adnanberberovic/TSEA56Grupp2/DOKUMENT/DesignSpec/Produktblad/Reflex-Sensor.pdf

Reexsensor
11 oktober 2007
Denna sensor innehåller 1 st så kallad reexdetektor. Den består av en lysdiod med infrarött ljus o

h en ljuskänslig transistor. Lysdioden är alltid tänd så länge som sensorn är spänningssatt. Om underlaget reekterar my

ket ljus blir utsignalen
låg o

h vi

e versa.
Sensorn kopplas in med 5-volts matning till anslutningarna +5 o

h GND. Utsignalen OUT är ana-
log o

h varierar någonstans i området mellan 0 o

h
5 volt. Sensorns motstånd är dimensionerade för ett avstånd på några millimeter mellan fototransistor o

h underlag.

+5V

OUT

GND

62 | 47
Sensorn är en kortbit om 30x14 mm med en anslutningskontakt i ena änden för utsignal (OUT), 5-volts matning (+5) o

h jord (GND). I sensorns
andra ända nns transistor o

h lysdiod. Mitt i sensorn nns ett hål med storleken 3 mm avsett att användas för montering.

OUT
+5

GND

1
