adnanberberovic/TSEA56Grupp2/FÖRSTUDIE/SENSORUPPGIFT/Sensoruppgift_Grupp2.pdf

TSEA56 - Kandidatprojekt i elektronik

## Förstudie - Sensorer

Version 0.1

Grupp 2
Agafonov, Nikolaj, nikag669 Brorsson, Andreas, andbr981

5 mars 2015

Status

Granskad | – | datum
Godkänd | – | datum

Förstudie - Sensorer | 5 mars 2015

## PROJEKTIDENTITET

2015/VT, Undsättningsrobot Gr. 2 Linköpings tekniska högskola, ISY

Namn | Ansvar | Telefon | E-post
Nikolaj Agafonov | Dokumentansvarig (DA) | 072-276 99 46 | nikag669@student.liu.se
Adnan Berberovic | Projektledare (PL) | 070-491 96 07 | adnbe196@student.liu.se
Andreas Brorsson | Testansvarig (TA) | 073-524 44 60 | andbr981@student.liu.se
Fredrik Fridborn | Designansvarig Sensormo-dul (DSE) | 073-585 52 01 | frefr166@student.liu.se
Robert Oprea | Designansvarig Styrmodul (DST) | 070-022 10 18 | robop806@student.liu.se
Måns Skytt | Designansvarig Kommuni-kationsenhet (DK) | 070-354 28 84 | mansk700@student.liu.se

E-postlista för hela gruppen: adnbe196@student.liu.se

Kund: Kent Palmkvist, 581 83 Linköping, Kundtelefon: 013-28 13 47, kentp@isy.liu.se ISY-handledare: Kristoffer Öfjäll, kristoffer.ofjall@liu.se TEMA-handledare: Birgitte Saxstrup, birgitte.saxtrup@liu.se

Kursansvarig: Tomas Svensson, 013-28 13 68, tomass@isy.liu.se Handledare: Olov Andersson, 013-28 26 58, Olov.Andersson@liu.se

TSEA56
ISY
i | Andreas Brorsson Andbr981 Nikolaj Agafonov Nikag669

## Innehåll

1 Inledning | 1
2 Problemformulering | 2
3 Motivation av sensorval | 2
4 Avståndsmätare | 3
5 Vinkelhastightessensor | 6
6 Reflektionssensor | 7
7 RFID | 8
8 Resultat och slutsatser | 8
ii | Andreas Brorsson Andbr981

## Dokumenthistorik

Version | Datum | Utförda förändringar | Utförda av | Granskad
0.1 | 2015-03-05 | Första utkastet | NA, ABr
iii | Andreas Brorsson Andbr981

## 1 Inledning

Denna förstudie om sensorer tar upp frågeställningar som uppkommer när en autonom robot ska konstrueras. Vilka sensorer som kan passa till en undsättningsrobot och hur dessa fungerar. Vilken data de ger till roboten och i vilka storheter fås. Vad kan störa sensorerna och hur noggranna de är.

### 1.1 Syfte

Syftet med skrivuppgiften är att få möjlighet att individuellt träna och få återkoppling på tekniskt skrivande såväl innehållsmässigt som språkligt.

### 1.2 Mål

Målet med förstudien är:

- Att introducera författarna till vetenskapligt och tekniskt skrivande och förbereda inför bland annat examensarbetet.
- Att få en fördjupning i ämnet och en större kunskapsbas för sensorer.
- Att resultatet ska komma fram till vilka sensorer som bör användas i byggandet av en undsättningsrobot i kursen TSEA56.

### 1.3 Introduktion till Sensorer

Sensorer är en anordning för att konvertera en form av energi till en annan form. Dessa energier kan vara elektromagnetiska, mekaniska eller akustiska till t ex en spänning. Då en dator behöver digital data för att kunna analysera sin omgivning kvantiseras spänningen från sensorn via en A/D-omvandlare till digital data som kan processeras.

Sensorer som den autonoma undsättningsroboten kan behöva är:

- Avståndssensorer för att mäta avståndet till väggar och hinder.
- Reflektionssensor, för att få reda på när roboten har kommit fram till målet.
- Gyro, för att läsa av hur mycket roboten har roterat vid svängar eller rotation.
- RFID-avläsare.
1 | Andreas Brorsson Andbr981

## 2 Problemformulering

Förstudien ska beskriva flera olika sensorer som finns tillgängliga för att bygga en autonom undsättningsrobot i kursen TSEA56. Det finns många olika sensorer att tillgå och många sensorer utför samma uppgift. Första uppgiften är att ta reda på vilka sensorer som kan behövas till roboten för att den ska kunna utföra sitt uppdrag.

Därav är det viktigt att beskriva varje sensor utförligt och få svar på dessa frågor för varje sensor för att kunna utvärdera vilka som är lämpliga att använda:

- Hur fungerar sensorn?
- Vilka fysikaliska principer används? (Utveckla)
- Vad har sensorn för mätnoggrannhet? (Utveckla)
- Vilken är dess störkänslighet? (Utveckla)
- Vad har sensorn för prestanda, hur snabb är den och vad har den för fungerande intervall?
- Vart borde den placeras på roboten? (kanske inte borde vara här)
- Har sensorn några Starka/Svaga sidor? (kanske inte borde vara här)

När dessa frågor är besvarade kan en diskussion föras där olika sensorer jämförs. Resultatet av diskussionen generar då ett resultat där en rekommendation om vilka sensorer hur många och placering kommer att sammanställas.

### 2.1 Metod

För att besvara frågeställningar hade vi tillgång till vanheden. Där anges det vilka sensorer vi hade att tillgå, därifån kan vi läsa deras produktblad för att se hur de sköter sig, arbetar och vilken data de ger ifrån sig och om de är dåliga på något. Vi har tillgång till vetenskapliga tidskriftsartiklar via biblioteket. Vi kan fråga personer, intervjua.

## 3 Motivation av sensorval

Sensorer bör finnas på alla sidor om roboten för att känna av väggar och hinder. Och det är även praktiskt att ha fler sensorer på vissa ställen, till exempel på robotens höger- och vänstersidan. Detta behövs för att kunna reglera robotens riktning och hålla den längs ett rakt spår. Dessutom, kan det behövas sensorer av olika detektionsområden på robotens ena sida för att kunna samla tillräcklig data från sensorer, till exempel för att hantera en sväng på ett bra sätt. För att avgöra robotens vridning och därmed undvika att roboten fastnar vid svängar, behöver en vinkelhastighetssensorn kopplas till roboten.

Eftersom korridorerna i labyrinten, där roboten ska köra, är begränsade, och hela labyrintens hölje är högst 6x6 meter, är det lämpligt att använda sensorer, som har relativt lågt detektionsområde.

Områdets undre gränsen är viktigt för mätnoggrannhet vid små avstånd till väggar, för att roboten får inte kollidera med dem. Ju lägre denna gränsen är desto närmare till väggar kan roboten hamna. Mål- och startposition i labyrinten skall vara 0.4x0.4m och markeras med en heltäckande svart ruta. Därför måste roboten ha en sensor som kan detektera start och mål. För dessa syften kan antingen en reflexsensor/reflexsensormodul eller en RFID Card Reader användas.

Det finns även många andra sensorer som inte är relevanta för projektet (till exempel fuktighetsmätare) eller som måste köpas på egen hand och som inte är tillgängliga. Det är bara de sensorer som beskrivs på Vanheden får användas.

## 4 Avståndsmätare

Avståndssensorer skickar ut antingen akustisk eller elektromagnetiska pulser som reflekterar tillbaka från objekt som står i deras väg. Sensorn registrerar när pulserna kommer tillbaka för att sedan räkna ut avståndet till objektet. Optiska och akustiska sensorer har en begränsning vilket avståndsintervall sensorn kan beräkna avstånd på.

### 4.1 Optiska avståndsmätare

Det finns olika typer av optiska sensorer. Generellt finns det en sändare och en mottagare. Dessa kan antingen finnas i en och samma enhet eller inte. Principen bygger på att skicka ut en ljusstråle och detektera den efter att den har reflekterats från det objekt, till vilken avståndet mäts, eller från en speciell reflektor; mottagaren kan även finnas bakom objektet och då bryts ljusstrålen av objektet. [2]

### 4.1.1 Fysikaliska principer

För att mäta avståndet till objektet, används trianguleringsprincipen. Detta medför att avståndet som sensorn visar/skickar beror på den reflekterade ljusets vinkel. Se figur 1 nedan. Funktionaliteten väljs beroende på omgivande miljö. Den kan vara bakgrundsavbländande, förgrundsavbländande eller fixerat fokus. I det första fallet detekteras inte objekt som är längre bort än avkänningsområdet, i det andra - detekteras objektet inte om det finns närmare än avkänningsområdet, och i det sista - detekteras objektet bara om den befinner sig i avkänningsområdet. [2]

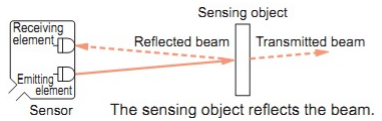
[picture p36: figure]

Figur 1: Direktavkänning - ljuset reflekteras från objektet[ref?].

### 4.1.2 Hur fungerar den för oss?

Direktavkännande sensorer med fixerat fokus kommer att användas i robotens konstruktion, därför att de är de enda som finns att tillgå, samt roboten kommer att användas i en specifik och begränsad miljö. Efter att sensorer har mätt avståndet till en vägg eller något annat objekt, konverteras denna data till respektive spänningsvärde och sedan skickas ut av sensorn. Data behandlas vidare i processorn av en A/D omvandlare, för att kunna användas i ett program.

### 4.1.3 Prestanda

De optiska sensorer som finns till förfogande visar ett mönster av att antingen kunna läsa avstånd på från relativt kort avstånd till relativt kort avstånd. Eller så kan de mäta från ett relativt lång minsta avstånd till relativt långt maximalt avstånd.

Vad detta beror på är att egentligen kan dessa sensorer detektera kortare avstånd än angivit och dessa begränsning endast berättar om deras maximala avstånd. Men på grund av vilka signaler sensorn skickar ut till roboten kommer samma spänning visas för två olika avstånd.

I figur 2 nedan erhålls ett maximum i ut-spänning vid ett visst avstånd, detta är vad sensorn kommer ange som ett minimi-avstånd i dess datablad. Men figuren visar även att sensorn kommer att ge en utsignal när avståndet är mindre, men detta är samma signal fast för ett större avstånd. Därför programmeras roboten att alltid tolka signalerna från mista-avstånd(maximi-punkten) till största avstånd.


Figur 2: Diagram på utsinal beroende på avstånd. [diagram1 ]

För optiska avståndsmätare som är tillgängliga, fås utsignalen i form av ett spänningsvärde. Detta värdet fås cirka 16ms eller 38ms efter en mätning påbörjas, beroende på sensorn.

### 4.1.4 Störkänslighet

De optiska avståndsmätare som var tillgängliga jobbar i det infraröda spektrummet. Detektorn kan då bli störd av solljus och miljöer med starkt omgivande ljus eller reflektioner. Om objekt eller hinder är genomskinlig kan mätningen bli störd eller inte fungera alls.

### 4.2 Akustisk avståndsmätare

Akustiska sensorer registrerar ljud med en mikrofon. Sensorn kan då analysera både våglängd och intensitet på det registrerade ljudet. Med kunskap om utbredningshastigheten för ljudvågor kan även avstånd beräknas.

För akustiska avståndsmätare skickar och mottar mätaren ultraljud. Ultraljuds fördel såväl som definitionen är att människan inte kan höra det, frekvensen ligger över 20kHz. Ultraljud används även för att minska störning från omgivning då det sällan förekommer naturligt. Om avståndsmäting sker under vatten kallas det sonar.

### 4.2.1 Fysikalisk princip

Principen för avståndsmätning med ultraljud är att en högtalare skickar ut ett antal pulser med ultraljud. Ljudet träffar något objekt som reflekterar tillbaka ljudet. Ljudet som har reflekterats tillbaka registreras av mikrofonen på avståndsmätaren. Men kunskap om ljudets hastighet och tiden det tog för ljudet att komma tillbaka går det då att beräkna avståndet till objektet.

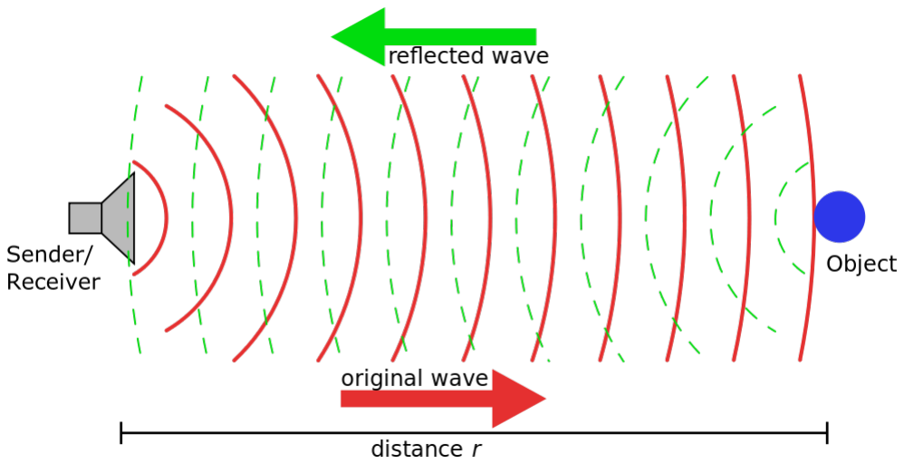
[picture p37: figure]

Figur 3: Hur avståndsmätning med sonar fungerar. [sonar ]

### 4.2.2 Hur fungerar den för oss?

Vilka signaler får vi från out-p?

### 4.2.3 Prestanda

Den ultraljudssensorn som finns till förfogande kan mäta upp avstånd från 3cm till 3m. Sensorn har fördelen att den inte tar hänsyn till ytan av föremålet som t ex om ytan är transparant eller reflekterar ljus dåligt.
Borde stå om hur fort den kan skicka ut data också insignal till man får tillbaka signal..

### 4.2.4 Störkänslighet

När en ultraljudsensor skickar ut pulserna som sedan ska detakteras sprids ljudet ut radiellt från sändaren. Detta resulterar i att detektorn kan detekterar ljud som inkommer i en vissa infallsvinklar som ligger innaför konformat spektrum se figur 4 nedan. Detta medför att roboten som antar att mätingen ska ske ortogonalt från sändaren får fel avstånd på grund av vinkeln detektorn mottagit pulsen.

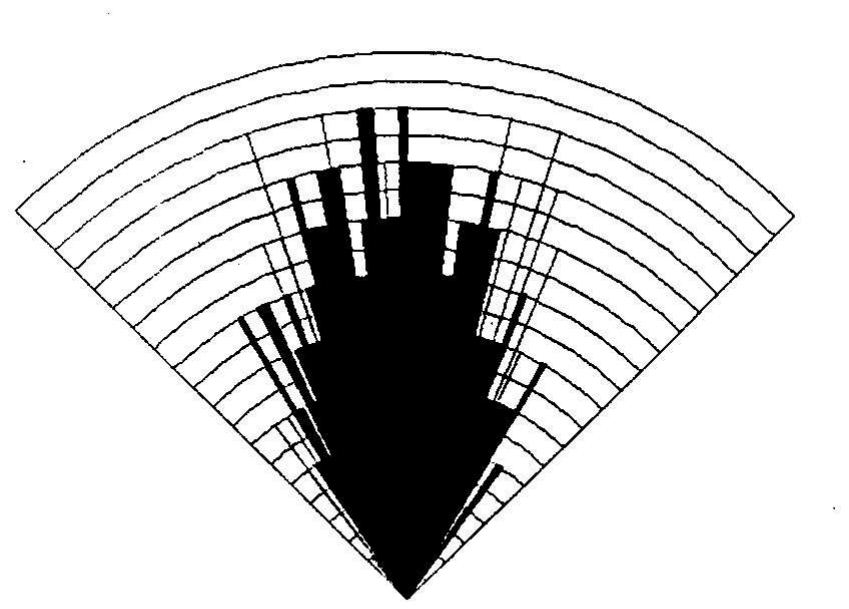
[picture p38: figure]

Figur 4: Spridning i ultraljudsavståndsmätarens mätningar. [spridning ]

## 5 Vinkelhastightessensor

Vinkelhastighetsmätare som ofta refereras till som gyroskop är en mekanisk sensor som kan detektera förändring av vinkel. Denna sortens sensorer kan användas för att räkna ut hur mycket roboten har roterat eller hur långt en sväng är gången. Vinkehastightessensor kan komplettera sensorerna som sitter på hjulen. Varför hjulens egna sensorer inte litas på 100% är för att hjulen kan glida på underlaget eller slira. Detta skulle resultera i att roboten tror den har förflyttat sig när den stått still eller förflyttat sig för lite mot vad den får för information.

### 5.1 Fysikalisk princip

Vibrationsgyro sensorer känner av vinkelhastighet från Corioliskraften som verkar på ett vibrerande ojekt. Roboten kommer att roteras horisontellt - kring Z-axeln (se bild nedan), vilket leder till vertikal vibration inuti gyrot. Sedan beräknas potentiell skillnad mellan de vibrerande armar i gyrot och därmed uppskattas vinkelhastighet. [ref4] och [ref5]

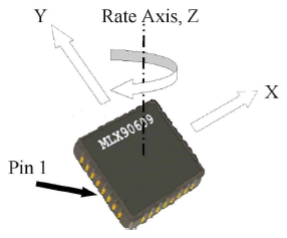
[picture p39: figure]

Figur 5: Vinkelhastighetssensor MLX90609 med axlar[ref?].

### 5.2 Hur fungerar den för oss?

VHS innehåller en A/D-omvandlare, som konverterar data för att kommunicera med processorn via en SPI-bus.

### 5.3 Prestanda

Gyroskopet avläser 13-14 bitar, vilket beror på hur stor vinkelhastighet får vara. Roboten behöver egentligen inte att röra eller rotera sig snabbt.

### 5.4 Störkänslighet

Vad kan göra att sensorn inte fungerar, vad får den att prestera sämre? Om chipet inte är helt vinkelrät kan det bli missvisande mätningar.

## 6 Reflektionssensor

Löst om sensorn

### 6.1 Fysikalisk princip

Beskriv hur sensorn fungerar

### 6.2 Hur fungerar den för oss?

Vad för info kommer vi få från sensorn

### 6.3 Prestanda

Hur bra är den på sin sak(enligt sig själv)

### 6.4 Störkänslighet

Vad kan göra att sensorn inte fungerar, vad får den att prestera sämre?

## 7 RFID

Löst om sensorn

### 7.1 Fysikalisk princip

Beskriv hur sensorn fungerar

### 7.2 Hur fungerar den för oss?

Vad för info kommer vi få från sensorn

### 7.3 Prestanda

Hur bra är den på sin sak(enligt sig själv)

### 7.4 Störkänslighet

Vad kan göra att sensorn inte fungerar, vad får den att prestera sämre?

## 8 Resultat och slutsatser

sammanfatta

### 8.1 Diskussion

Slutsats
