adnanberberovic/TSEA56Grupp2/FÖRSTUDIE/SENSORUPPGIFT/V1/Förstudie Sensorer v1.0.pdf

TSEA56 - Kandidatprojekt i elektronik

## Sensorer till autonom robot

Version 1.0

Agafonov, Nikolaj, nikag669 Brorsson, Andreas, andbr981

1 april 2015

Status

Granskad | FF | 2015-04-01
Godkänd

Sensorer till autonom robot | 1 april 2015

## PROJEKTIDENTITET

2015/VT, Undsättningsrobot Gr. 2 Tekniska högskolan vid Linköpings Universitet, ISY

Namn | Ansvar | Telefon | E-post
Nikolaj Agafonov | Dokumentansvarig (DA) | 072-276 99 46 | nikag669@student.liu.se
Adnan Berberovic | Projektledare (PL) | 070-491 96 07 | adnbe196@student.liu.se
Andreas Brorsson | Testansvarig (TA) | 073-524 44 60 | andbr981@student.liu.se
Fredrik Fridborn | Designansvarig Sensormo-dul (DSE) | 073-585 52 01 | frefr166@student.liu.se
Robert Oprea | Designansvarig Styrmodul (DST) | 070-022 10 18 | robop806@student.liu.se
Måns Skytt | Designansvarig Kommuni-kationsenhet (DK) | 070-354 28 84 | mansk700@student.liu.se

E-postlista för hela gruppen: adnbe196@student.liu.se

Kund: Kent Palmkvist, 581 83 Linköping, Kundtelefon: 013-28 13 47, kentp@isy.liu.se

Kursansvarig: Tomas Svensson, 013-28 13 68, tomass@isy.liu.se Handledare: Olov Andersson, 013-28 26 58, Olov.Andersson@liu.se

TSEA56
ISY
i | Andreas Brorsson, andbr981 Nikolaj Agafonov, nikag669

## Innehåll

1 Inledning | 1
2 Problemformulering | 2
3 Labyrint | 2
4 Motivation till valet av sensorer | 3
5 Avståndsmätare | 3
6 Vinkelhastighetssensor | 7
7 Reflexsensor | 9
8 RFID | 10
ii | Andreas Brorsson, andbr981

9 Resultat och slutsatser | 11
iii | Andreas Brorsson, andbr981

## Dokumenthistorik

Version | Datum | Utförda förändringar | Utförda av | Granskad
0.1 | 2015-03-05 | Första utkastet | NA, ABr | -
1.0 | 2015-04-01 | Slutlig version | NA, ABr | FF
iv | Andreas Brorsson, andbr981

## 1 Inledning

Denna förstudie om sensorer tar upp frågeställningar som uppkommer när en autonom robot ska konstrueras, vilka sensorer som passar till en undsättningsrobot och hur dessa fungerar. Denna rapport behandlar de sensorer som finns tillgängliga i kursen TSEA56 och är lämpliga att använda på en undsättningsrobot. En jämförelse mellan sensorer som utför samma uppgift ställs mot varandra och vilka sensorer som är nödvändiga på roboten.

### 1.1 Introduktion till Sensorer

En sensor är en anordning för att konvertera en form av energi till en annan form. Energin kan vara elektromagnetisk, mekanisk eller akustisk som konverteras till t.ex. en spänning. En dator behöver digital data för att kunna göra beräkningar, därför transformeras spänningen från sensorn via en A/D-omvandlare till digital data som kan processeras.

Sensorer som den autonoma undsättningsroboten behöver är:

- Avståndssensorer för att mäta avståndet till väggar och hinder.
- Reflexsensor eller RFID-avläsare för att ta reda på när roboten kommit fram till målet.
- Gyro, för att beräkna hur mycket roboten har roterat vid svängar eller rotation.

### 1.2 Syfte

Syftet med förstudien är att ge en bred kunskapsbas om sensorer för att kunna jämföra sensorer och komma fram till vilka sensorer som passar bäst till en undsättningsrobot i kursen TSEA56.

### 1.3 Mål

Målet med förstudien är:

- Att beskriva och analysera ovannämnda sensorer.
- Att få en fördjupning i ämnet och en bred kunskapsbas av sensorer.
- Att jämföra ovannämnda sensorer och deras fördelar och nackdelar.
- Att med hänsyn till jämförelsen rekommendera (bestämma) vilka sensorer som bör användas i byggandet av en undsättningsrobot i kursen TSEA56.

### 1.4 Parter

Utöver de personer som är redogjorda för i projektidentiteten är följande personer delaktiga i förstudien.

- Kent Palmkvist - Beställare
- Kristoffer Öfjäll - ISY-handledare
- Birgitte Saxstrup - TEMA-handledare
1 | Andreas Brorsson, andbr981

### 1.5 Begränsningar

Det är bara de sensorer som finns tillgängliga i kursen TSEA56 som kommer att undersökas. Eftersom förstudien skrivas på begränsad tid kommer bara de mest relevanta sensorer att undersökas. Vilka sensorer som finns tillgängliga i kursen specificeras på Vanheden [1]. Vanheden är en webbplats där ISY har samlat datablad och annan nyttig information till de praktiska delarna i kursen.

## 2 Problemformulering

I förstudien ska sensorer som finns tillgängliga för att bygga en autonom undsättningsrobot i kursen TSEA56 beskrivas. Det finns olika sensorer att tillgå och sensorer som utför samma uppgift. Uppgiften är att ta reda på vilka sensorer som behövs till roboten för att den ska kunna utföra sitt uppdrag.

Därav är det viktigt att beskriva varje sensor utförligt och presentera fakta för varje sensor för att kunna utvärdera vilka som är lämpliga att använda. Nedstående frågor används som underlag:

- Hur fungerar sensorn?
- Vilka fysikaliska principer används?
- Vad har sensorn för prestanda?
- Är sensorn känslig för någon störning?

När dessa frågor är besvarade för varje sensor jämförs de. Jämförelsen ger resultatet som sammanfattar vilka och hur många sensorer som bör användas på undsättningsroboten samt var på roboten bör de monteras.

### 2.1 Metod

För att besvara frågeställningarna kommer forskning bedrivas genom litteraturgranskning. Vilka sensorer som ska granskas begränsas av de som finns på Vanheden där tillgång till datablad även finns. För ytterligare information om hur sensorerna fungerar kommer vetenskapliga artiklar att användas. Data ska sammanställas och presenteras för att sedan analyseras för att få fram ett resultat.

## 3 Labyrint

Undsättningsroboten har för uppgift att utforska en labyrint med en area på högst 6x6m. Roboten ska kunna reglera sig själv när den befinner sig i det autonoma läget, d.v.s. att roboten ska korrigera sin riktning på så sätt att avståndet mellan labyrintens väggarna till roboten blir samma. Korridorer i labyrinten ska vara 0.4 m breda och alla hörn får utgöras av vinkelräta väggelement därmed bör roboten vara utrustad med lämpliga sensorer. Mål och startposition i labyrinten skall vara 40x40 cm och markeras med en svart tejp på marken, på så sätt att tejpen täcker hela 40x40 cm rutan.

## 4 Motivation till valet av sensorer

Avståndssensorer bör finnas på alla sidor om roboten för att känna av väggar och hinder. Det är även praktiskt att ha fler sensorer på vissa sidor t.ex. på robotens höger och vänstersida. Detta behövs för att kunna reglera robotens riktning och hålla den centrerad, så att roboten skulle kunna köra utan att slingra sig fram. Dessutom kan det behövas sensorer av olika detektionsområden på robotens sidor för att kunna samla så mycket data som möjligt, till exempel för att rita karta över labyrinten på ett effektivt sätt.

För att avgöra robotens vridning och därmed undvika att roboten fastnar vid svängar behöver en vinkelhastighetssensor kopplas till roboten. Eftersom korridorerna i labyrinten där roboten ska köra är begränsade är det lämpligt att använda sensorer som har relativt kort detektionsområde.

Detektionsområdets undre gräns är viktig för mätnoggrannhet vid små avstånd för att roboten inte ska kollidera med väggar. Ju lägre denna gräns är desto närmare till väggen kan roboten röra sig. Roboten måste även ha en sensor som kan detektera startposition och mål. För dessa syften kan antingen en reflexsensor eller en RFID-avläsare användas.

## 5 Avståndsmätare

Roboten kommer att vara utrustad med aktiva avståndsmätare, vilket betyder att de sensorerna kommer att skicka ut vågor kontinuerligt under den autonoma styrningen. En avståndssensor skickar ut antingen en serie akustiska eller elektromagnetiska pulser som reflekteras tillbaka från objekt som pulserna träffat. Sensorn registrerar antingen när pulserna kommer tillbaka eller reflektionsvinkel för att beräkna avståndet till objektet. Optiska och akustiska sensorer är begränsade med olika avståndsintervall som sensorer kan beräkna avstånd på.

### 5.1 Optisk avståndsmätare

Det finns olika typer av optiska sensorer. Generellt finns det en sändare och en mottagare. Dessa kan antingen finnas i en och samma enhet eller separat. Principen bygger på att skicka ut en ljusstråle och detektera den efter att den har reflekterats från ett objekt, till vilken avståndet mäts [2].

### 5.1.1 Fysikaliska principer

För att mäta avståndet till objekt används trianguleringsprincipen. Detta medför att avståndet som sensorn beräknat fram beror på det reflekterade ljusets vinkel. Se figur 1 nedan. Det finns tre typer av funktionaliteten som väljs beroende på omgivningen. Den kan vara bakgrundsavbländande, förgrundsavbländande eller med fixerat fokus. I det första fallet detekteras inte objekt som är längre bort än avkänningsområdet, i det andra detekteras objekt inte om det finns närmare än avkänningsområdet och i det sista fallet detekteras objekt bara om de befinner sig i avkänningsområdet [2].


Figur 1: Direktavkänning - ljuset reflekteras från objektet [2].

### 5.1.2 Data och signaler

Direktavkännande sensorer med fixerat fokus kommer att användas i robotens konstruktion. Efter att en sensor har mätt avståndet till en vägg eller något annat objekt, konverteras resultatet till respektive spänningsvärde och sedan skickas ut av sensorn. Data behandlas vidare av en A/D-omvandlare för att kunna behandlas i processorn [2], [3].

### 5.1.3 Prestanda

De optiska sensorer som finns till förfogande visar ett mönster av att antingen kunna läsa avstånd från relativt kort avstånd till relativt kort avstånd. Eller så kan de mäta från ett relativt långt minsta avstånd till relativt långt maximalt avstånd t.ex. 4-30 cm och 20-150 cm.

Detta beror på att dessa sensorer egentligen kan detektera kortare avstånd än vad som är angivet som det minsta avståndet i databladen, och de angivna avståndsintervall i databladen anger endast sensorernas maximala avläsningsavstånd. Sensorernas mätningar kan resultera i samma spänningsvärde för två olika avstånd.

I figur 2 nedan erhålls ett maximum i ut-spänning vid avståndet 5 cm(syns på x-axeln), detta är vad sensorn kommer att ange som sitt minimi-avstånd i dess datablad. För avstånd både mindre och större än 5 cm visas samma utspänning, som t.ex för 2.5 volt ges både 4 och 9 cm. Därför programmeras roboten till att alltid tolka signalerna från minsta-avstånd (maximi-punkten) till största avstånd, angivet i databladet [3].


Figur 2: Diagram på utsignal mot avstånd [3].

För optiska avståndsmätare som är tillgängliga, fås utsignalen i form av ett spänningsvärde. Detta värdet fås cirka 16 ms eller 38 ms efter en mätning påbörjas, beroende på sensorn.

### 5.1.4 Störkänslighet

De optiska avståndsmätarna arbetar i det infraröda spektrummet, detektorn kan då bli störd av solljus och miljöer med starkt omgivande ljus eller reflektioner. Om objekt eller hinder är genomskinligt eller har en starkt reflekterande yta kan mätningen bli störd eller inte fungera alls.

### 5.2 Akustisk avståndsmätare

Akustiska sensorer registrerar ljud med en mikrofon. Sensorn kan bestämma både våglängd och intensitet på det registrerade ljudet. Med kunskap om utbredningshastigheten för ljudvågor kan även avståndet till ett objekt beräknas [4].

För akustiska avståndsmätare skickar och mottager mätaren ultraljud. Fördelen med ultraljud är att människan inte kan höra det, för att frekvensen ligger över 20 kHz. Ultraljud används även för att minska störning från omgivning då det sällan förekommer naturligt. Om avståndsmäting sker under vatten kallas det sonar.

### 5.2.1 Fysikalisk princip

Principen för avståndsmätning med ultraljud är att en högtalare skickar ut ett antal pulser med ultraljud. Ljudet träffar något objekt som reflekterar tillbaka ljudet som registreras av mikrofonen på avståndsmätaren. Se figur nedan. Men kunskap om ljudets hastighet och tiden det tar för ljudet att komma tillbaka går det att beräkna avståndet till objektet.


Figur 3: Hur avståndsmätning med ultraljud fungerar [5].

### 5.2.2 Data och signaler

Ultraljudssensorn skickar en puls, som är ungefär från 100 us till 18 ms lång, till en processor, där avståndet till ett objekt beräknas med avseende på pulsens bredd. Om ljudet inte når fram till något objekt, kommer sensorn att skicka en puls som är cirka 36 ms lång.

### 5.2.3 Prestanda

Den ultraljudssensorn som finns till förfogande kan mäta avstånd från 3cm till 3m. Fördelen med sensorn är att dess mätdata är oberoende föremålets förmåga att reflektera eller absorbera ljus.

### 5.2.4 Störkänslighet

När en ultraljudsensor skickar ut pulserna sprids ljudet ut radiellt från sändaren. Detta resulterar i att det detekterade ljudet inkommer från vissa infallsvinklar som ligger innanför ett konformat spektrum se figur 4 nedan. Roboten som antar att mätningar sker ortogonalt från sändaren kan få felaktiga mätvärden.

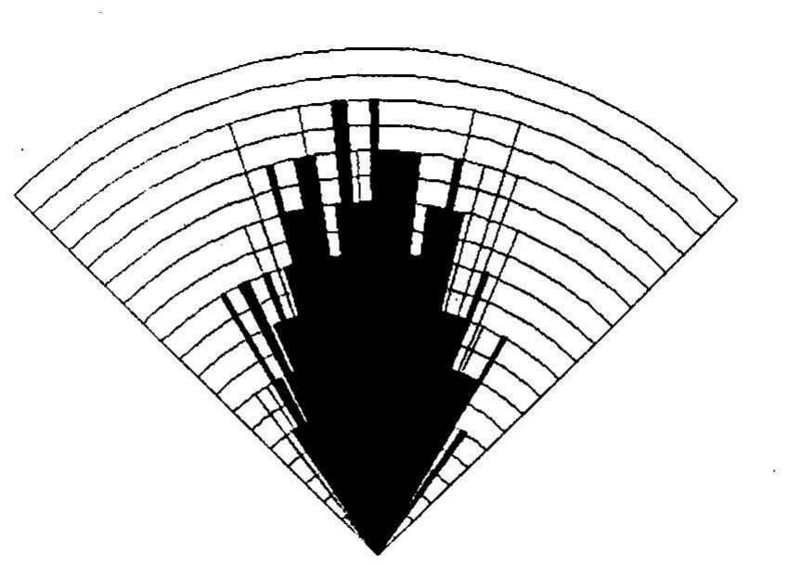
[picture p40: figure]

Figur 4: Spridning i ultraljudsavståndsmätarens mätningar [4].

## 6 Vinkelhastighetssensor

Vinkelhastighetsmätare, som ofta refereras till som gyroskop, är en mekanisk sensor som kan detektera förändringar i vinkelhastighet. Denna sortens sensorer kan användas för att komplettera data, som en processor kan använda för att räkna ut hur mycket roboten har roterat eller hur långt en sväng är gången. Utan gyrot är processorns beräkningar inte helt tillförlitliga för att hjulen kan glida på underlaget eller slira. Detta skulle resultera i att roboten tror den har förflyttat sig när den stått still eller förflyttat sig för lite mot vad den beräknat.

### 6.1 Fysikalisk princip

Gyrot känner av vinkelhastigheten när sensorn roterar horisontellt kring Z-axeln, se figur 5 nedan. Gyrot har en mekanisk struktur som oscillerar då Corioliskraften verkar på den. Denna kraft uppstår endast om modulen är i rörelse. Mekaniska vibrationer som skapas registreras och transformeras sedan till utspänningen [6].


Figur 5: Vinkelhastighetssensor MLX90609 med axlar [6].

### 6.2 Data och signaler

Gyrot beräknar spänningen som beror på robotens vinkelhastighet med avseende på omgivningen. Efter detta konverteras spänningen med en intern A/D-omvandlare till ett digitalt värde. När gyrot har mottagit en operations-kod (bestående av 8 eller 16 bitars ord) från styrmodulen skickas svaret till styrmodulen via en SPI-buss. Data (16 bitars ord) som styrmodulen får från VHS behöver sedan omvandlas till ett respektive värde på vinkelhastiget mätt i grader per sekund.

### 6.3 Prestanda

Gyrot kan läsa av vinkelhastighet upp till 300 grader/s. Gyrot är en enskild modul som kopplas direkt till master-modulen. Det betyder att gyrot inte behöver kopplas till en modul som behöver göra extra beräkningar. A/D-omvandlingen tar cirka 90 mikrosekunder att utföra och det tar 24 klockcykler för gyrot att ta emot ett meddelande från master-modulen och skicka tillbaka ett svar.

### 6.4 Störkänslighet

För att mäta robotens vinkelhastighet med gyrot ska modulen vara placerad vinkelrätt mot rotationsaxeln. Sensorn är känslig för lutning och hinder vilket resulterar i avvikelser från robotens riktiga vinkelhastighet.

## 7 Reflexsensor

Reflekssensorn är en sensor som skickar ut ljus och sedan mäter styrkan i det reflekterade ljuset. Reflekssensorn består av en lysdiod som sänder ut infrarött ljus och en fototransistor som detekterar infrarött ljus, se figur 6 nedan.

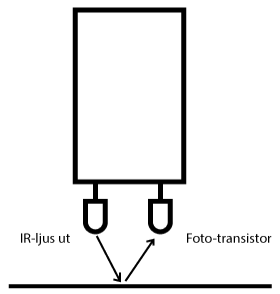
[picture p41: figure]

Figur 6: Hur en reflexsensor fungerar.

### 7.1 Fysikalisk princip

Reflexsensors ljusdiod som radierar infrarött ljus är tänd hela tiden. När fototransistorn blir exponerad för infrarött ljus släpper transistorn igenom ström vilket gör att utgången blir låg. När mindre ljus reflekteras som t.ex. när en svart tejpbit sitter i vägen släpper transistorn igenom mindre ström och utgången blir hög [7].

### 7.2 Data och signaler

Även om tanken är att konstruktionen ska ge en diskret hög och låg signal är det inte så. Utsignalen måste gå genom en A/D-omvandlare och tester måste genomföras för att bestämma när sensorn anses gå hög.

### 7.3 Prestanda

Sensorn placeras några millimeter från mätytan och skickar ut analog data.

### 7.4 Störkänslighet

Fotoresistorn är känslig för infrarött ljus, väldigt starka ljuskällor med infraröttljus i rummet skulle kunna störa sensorn. Avståndet mellan sensorn och ytan ska vara ett par millimeter, därför att om sensorn sätts för långt ifrån ytan kan det reflekterade infraröda ljuset bli för svagt och sensorn går hög felaktigt. Det måste vara tydlig kontrast mellan yta och markering.

## 8 RFID

Tekniken RFID är en akronym för ’radio frequency identification’ och är en teknik som har två huvudkomponenter, en avläsare och en tagg. Där avläsaren skickar ut en radiosignal till en tagg som skickar tillbaka information till avläsaren.

RFID-tekniken har likheter med den föråldrade tekniken med en optisk avläsare som läser stäckkod för att få fram ett ID-nummer. På samma sätt fungerar RFID men eftersom tekniken använder sig av radiovågor istället för optisk avläsning behöver inte avläsaren optiskt se taggen. En annan fördel är att en tagg kan bära på mer information än bara ett ID, de billigaste brukar ha ett minne på 2 KB [8], [9].

Avståndet mellan en avläsare och en tagg kan variera från några centimeter till flera hundra meter beroende på vilken sort tagg som används. Det finns tre olika sorter, passiv, semipassiv och aktiv. Aktiv och semipassiv har strömkällor inkopplade och kan skicka mer data och över längre avstånd, jämfört med en passiv tagg som blir strömförsörjd av radiosignalen från avläsaren [10].

### 8.1 Fysikalisk princip

En avläsare skickar ut radiovågor i 120-140 kHz-området. En passiv tagg som upptäcktes av en avläsare blir strömförsörjd genom induktion som ger den kraft att skicka tillbaka data som sparats på taggen. Resultatet av att passiva taggen använder induktion för att bli strömförsörjd är att avståndet när data ska överföras mellan tagg och avläsare blir kort, ungefär mellan 10-20cm. Semipassiva och aktiva taggar kan därför skicka data över längre avstånd med batteri eller aktiv försörjning.

### 8.2 Data och signaler

Avläsaren skannar kontinuerligt efter en tagg och skickar data seriellt till mikroprocessorn. När en tagg hittats jämförs data med innehållet i ett register i mikroprocessorn [11].

### 8.3 Prestanda

Läsavståndet mellan avläsaren och taggen är upp till 10 cm, avläsaren behöver inte se taggen utan bara vara inom räckhåll. Olika taggar kan ge olika information som avläsaren kan programmeras efter. Taggar kan placeras i många olika miljöer och fungerar nära metall, vätskor och smuts.

### 8.4 Störkänslighet

Om flera taggar skickar tillbaka data samtidigt till avläsaren kan avläsaren få svårt att veta att det är mer än en tagg som skickar data och även blanda ihop data. Den passiva taggen som finns tillgänglig är avståndsberoende och det finns en liten chans att roboten skulle kunna missa taggen. Om taggen är på gränsen kan avläsningen bli fel. Vart taggen är placerad relativt avläsaren påverkar på hur långt avstånd avläsaren kan hitta en tagg.

## 9 Resultat och slutsatser

Genom att jämföra olika sensorer bestämdes vilka sensorer som är lämpliga för robotens konstruktion. Först bedömdes robotens begränsningar, syfte och användningsområde och därmed kunde minsta antalet sensorer bestämmas och deras typer i syfte att roboten skulle kunna uppnå uppställda mål.

Eftersom antalet sensorer som kan kopplas till varje virkort är begransat valdes sensorer som är nödvändiga för att roboten skulle klara av alla uppställda krav. De sensorer som kommer att användas är:

- 5 st optiska avståndsmätare GP2Y0A41SK (4-30 cm).
- 2 st optiska avståndsmätare GP2Y0A21 (10-80 cm).
- En reflexsensor.
- En vinkelhastighetssensor.

En avståndssensor på robotens framsida för att mäta korta avstånd och inte köra på objekt. Två sensorer som mäter korta avstånd på varje sida för att kunna beräkna robotens vinkel och position mellan väggarna. Samt en avståndssensor för långa avstånd på mitten av vardera sida för att ge information om objekt på längre avstånd. Data från dessa sensorer ska användas i PD-regleringen och utritandet av labyrintens karta.

Vinkelhastighetssensorn behövs för att kontrollera hastigheten av robotens vridning och därmed kunna optimera autonom styrning vid kurvor och rotation. Roboten ska ha en sensor som kan identifiera målet, det åstadkommer reflexsensor som fästs på robotens undersida.

### 9.1 Diskussion

En av de stora skillnaderna mellan akustisk och optisk avståndssensor är detektionsområdets vinkel. För akustisk mottagare är detektionsområdet 30 grader brett medans optiska mottagarens detektionsområde är cirka 6 grader. Vilket säger att den optiska sensorn kommer ge mer noggran data.

Enligt databladet är den akustiska sensormodulen ganska stor och duger inte för relativt små robotar. Dessutom är akustiska sensorer avsedda för att mäta avståndet från 3 cm till 3 m och roboten har inget behov av att mäta relativt stora avstånd. Fördelen med både optisk och akustisk avståndsmätare är att människan inte kan uppfatta vågorna som skickas, den optiska sensorn använder infrarött ljus och akustiska sensorn använder ultraljud.

En fråga som dyker upp är om vinkelhastighetssensorn är absolut nödvändig eller inte. Roboten kan tänkas klara vissa av sina uppgifter med hjälp av endast avståndssensorer. Dock kan avståndssensorerna vara missvisande eller svårtolkade under en rotation och robotens egna uträkning om hur långt en rotation är gången blir fel om däcken slirar eller glider. Gyrot beräknar rotationen och ger korrekt data så att en rotation blir effektiv utan att felkorrigering behövs.

Orsaken till att reflexsensorn har valts och inte RFID-avläsaren är framför allt att roboten inte ska känna av olika mål, det finns bara ett. Jämfört med reflexsensorn har RFID-avläsaren större komplexitet och kan hantera olika taggar. Detta behövs inte för autonom styrning av en kartläggningsrobot i kursen TSEA56. Reflexsensorn är enkel darför att den skickar ut en signal som antingen blir hög eller låg beroende om målet hittats eller inte.

RFID-avläsaren skulle kunna vara säkrare än reflexsensorn med avseende på störningskänslighet. De reflekterade ljusets intensitet från reflekssensorn avtar snabbt när avståndet mellan sensor och mark ökar, därmed kan sensormodulen missuppfatta signalen, vid uppbyggandet av roboten bör reflexsensorn placeras så nära marken som möjligt.

## Referenser

[1] Vanheden, ISY, Liu. URL: https://docs.isy.liu.se/twiki/bin/view/VanHeden (hämtad 2015-03-31).
[2] N. Qvist, Generell information om fotoceller, Acumo. URL: http://www.acumo.se/generell-information-om-fotoceller-4 (hämtad 2015-03-31).
[3] Gp2y0a21yk optoelectronic device, SHARP CORPORATION, 2005. URL: http://www.sharpsma.com/webfm_send/1208 (hämtad 2015-03-05).
[4] Srf04 ultrasonic range finder, Devantech, sept. 2003. URL: https://docs.isy.liu.se/twiki/pub/VanHeden/DataSheets/srf04.pdf (hämtad 2015-03-05).
[5] G. Wiora, Principle of a sonar or radar distance measurement, okt. 2005. URL: http://commons.wikimedia.org/wiki/File:Sonar_Principle_EN.svg (hämtad 2015-03-05).
[6] Mlx90609 angular rate sensor, ISY, Liu. URL: https: //docs.isy.liu.se/twiki/pub/VanHeden/DataSheets/MLX90609_datasheet.pdf (hämtad 2015-03-31).
[7] Reflexsensor, okt. 2007. URL: https://docs.isy.liu.se/twiki/pub/VanHeden/DataSheets/reflex_sensor.pdf (hämtad 2015-03-31).
[8] What is rfid? - animated explanation, http://www.explania.com/, mars 2012. URL: https://web.archive.org/web/20120322194318/http://www.explania.com/en/channels/technology/detail/what-is-rfid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 (https://web.archive.org/web/20120322194318/http://www.explania.com/en/channels/technology/detail/what-is-rfid) (hämtad 2015-03-24).
[9] RFID Journal. URL: http://www.rfidjournal.com/faq (hämtad 2015-03-24).
[10] S. A. Weis, Rfid (radio frequency identification): Principles and applications, 2006.
[11] Rfid card reader, serial, Parallax. URL: https://docs.isy.liu.se/twiki/pub/VanHeden/DataSheets/rfid-reader-v21.pdf (hämtad 2015-03-31).
