adnanberberovic/TSEA56Grupp2/DOKUMENT/DesignSpec/Avstand copy.pdf

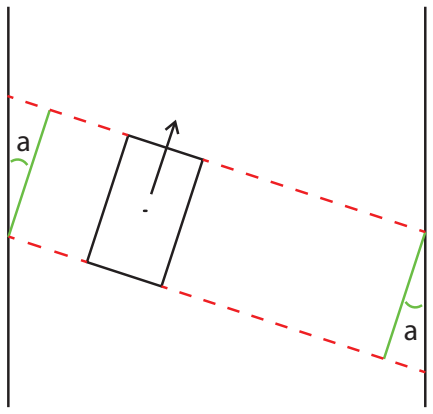
[picture p46: figure]
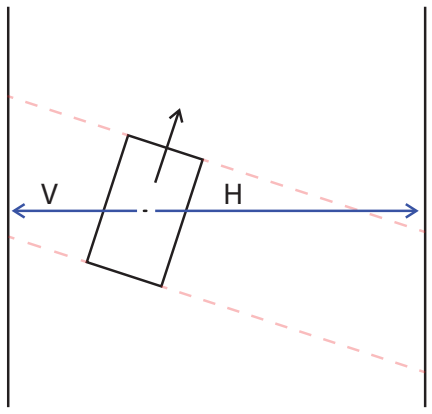
[picture p47: figure]
