adnanberberovic/TSEA56Grupp2/BP/BP2/projektplan_v1.0.pdf

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

Undsättningsrobot | 2015-02-22
3 juni: | (preliminärt) 9.15-17 tävlingar utanför café Java.
5 juni: | Efterstudien ska vara inlämnad. Vid denna tidpunkt ska även källkod skic-kas in i en zip-l.
12 juni: | Bärbar dator och övrig utrustning ska vara återlämnade.

En tidrapport ska lämnas senast kl 16.00 vid följande datum: 4 febr, 23 febr, 9 mars, 23 mars, 30 mars, 13 april, 20 april, 27 april, 4 maj, 11 maj, 18 maj, 25 maj, 1 juni och 8 juni.

2.3 Begränsningar

Roboten anses vara en prototyp. Detta innebär att den kommer vara designad på sådant sätt att den kommer kunna klara av en bana av fördenierad storlek med plan mark, och inte en miljö av godtyckligt väglag och storlek.

## 3 Fasplan

Nedan ges en grov beskrivning av aktiviteterna i varje fas.

3.1 Under projektet

Initialt kommer en stor del av arbetet bestå av att lära sig de verktyg som behövs för att kunna genomföra projektet: AVR, VDHL, dataöverföring via bluetooth, mätteknik etc. Det sker dels genom läsning men även laboratoriskt. Därefter kommer hårdvaran konstrueras och testning kommer ske kontinuerligt. Efter varje modul skapats kommer större tester genomföras. Slutligen kommer mjukvaran kodas med kontinuerlig testning.

3.2 Efter projektet

En färdig produkt ska levereras. Efter projektet kommer efterstudie genomföras, labbplatsen städas och materiel återlämnas varpå projektgruppen upplöses och gruppkontraktet hävs. Gruppen kommer även att reektera över ett utfört projektarbete och kunna föreslå förbättringar.

TSEA56
Projektplan
2 | Projektgrupp 2 e-post: adnbe196@student.liu.se

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
