adnanberberovic/TSEA56Grupp2/BP/BP2/systemskiss_v1.0.pdf

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

Undsättningsrobot | 2015-02-19
1 | Inledning

Denna projektskiss är en del av förarbetet till kandidatprojektet i Elektronik (TSEA56) och detta är en översiktlig beskrivning av hela systemet samt dess ingående delsystem. Projektet utförs på uppdrag av en beställare.

1.1 Syfte och mål

Syftet med projektet är att tillverka en undsättningsrobot som ska tjäna som prototyp för att testa de olika ingående delsystemens funktionalitet samt den autonoma styrningen. Målet med projektet är att tillhandahålla en så väl fungerande prototyp av en autonom undsättningsrobot som möjligt, inom ramarna för projektet.

1.2 Användning

Roboten är tänkt att användas i ett grottsystem (läs spelregler) för att hitta och undsätta personer som fastnat. Roboten ska arbeta autonomt för att hitta kortaste vägen till de nödställda för att sedan leverera nödmaterial så fort som möjligt. Roboten ska även gå att styra från en dator med enkla kommandon tex styra fram, bakåt, svänga och rotera.

## 2 Systemöversikt

Systemet kan ses i sin tänkta miljö i Figur 1. Roboten kommunicerar med en PC via blåtandslänk. Positionsdata skickas kontinuerligt från roboten, som styrs autonomt, till PC:n där användaren kan utläsa värden.

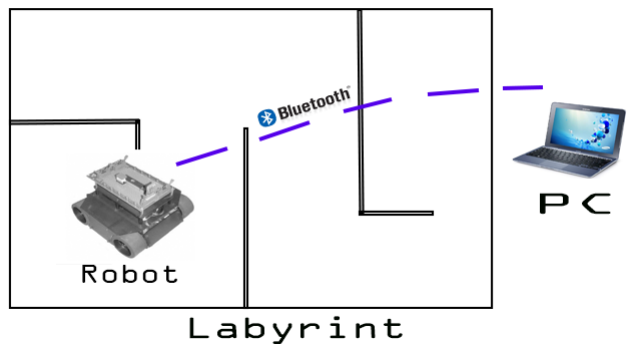
[picture p50: figure]

Figur 1: Systemet i sin tänkta miljö

TSEA56
Systemskiss
1 | Projektgrupp 2 e-post: adnbe196@student.liu.se

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

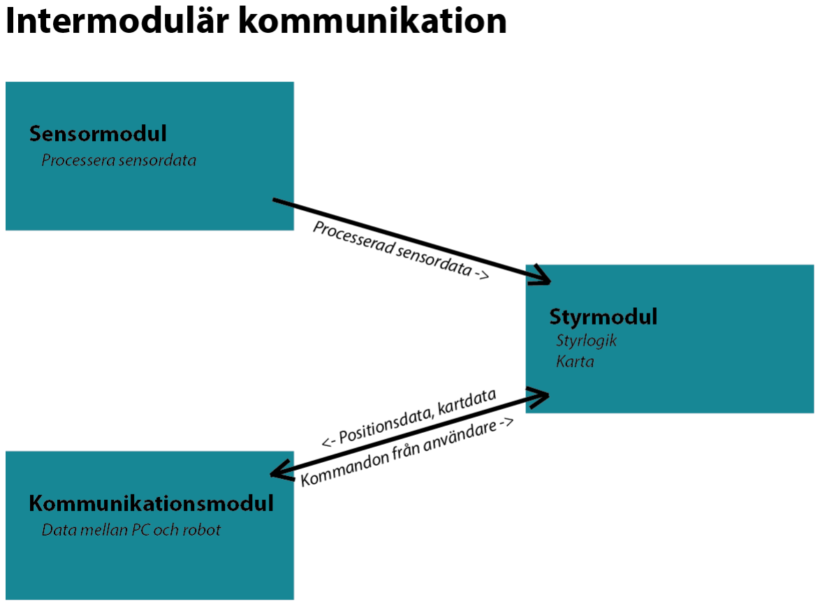
[picture p51: figure]

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

Undsättningsrobot | 2015-02-19

roboten. Upplockning och greppning sker i enlighet med Banspecikation och tävlingsregler.
[2][3]

4.4 Gränssnitt - Display

Displayen ska visa aktuell status och data från roboten på ett tydligt vis.

4.5 Brytare för val av autonom eller manuell styrning

En brytare kommer sitta på ett bra ställe på roboten så den autonoma styrningen kan slås av till fördel av manuell styrning via kommunikationsmodulen och tvärt om med fördel för den autonoma styrningen via sensorer.

## 5 Delsystem 3 - Kommunikationsmodul

Kommunikationsmodulen har två roller beroende på om roboten ligger i autonomt eller manuellt läge. I autonomt läge har den i huvuduppgift att skicka data till PC:n från sensoroch styr-modulen. I manuellt läge har den i uppgift att ta emot data från PC:n som styr roboten via kommunikationsmodulen.

5.1 Bluetooth - Kommunikationsmodul

På kommunikationsmodulen sitter det ett Bluetooth-modem som kan skicka och ta emot data från en PC.

## 6 Delsystem 4 - PC

PC:n har två roller beroende på om roboten ligger i autonomt eller manuellt läge. I autonomt läge har den i huvuduppgift att ta emot data från roboten och sammanfatta för att rita upp en karta på skärm.

6.1 Användargränssnitt - Visualisering

I användargränssnittet så kommer det dels nnas en visualisering av den karta som roboten ritar upp, dels så kommer mät- och styrdata samt de styrbeslut som roboten tar att presenteras på ett tydligt sätt.

6.2 Bluetooth - PC

På PC:n sitter det ett Bluetooth-modem som kan skicka och ta emot data från roboten.

TSEA56
Systemskiss
5 | Projektgrupp 2 e-post: adnbe196@student.liu.se

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
