adnanberberovic/TSEA56Grupp2/BP/BP1/kravspec1.0.pdf

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

Undsättningsrobot | 2015-02-03
1.3 | Användning

Undsättningsroboten kan användas för att utforska en grotta eller någon form av en labyrint (området är begränsat) och leverera ett objekt från en punkt till en annan. Roboten ska kunna styras autonomt med hjälp av olika typer av sensorer runt om roboten. Den ska även kunna styras via blåtand av en användare. Helst ska roboten skicka data till PC:n som behandlas så att en karta kan ritas ut på PC:ns skärm. Följande gur visar ett exempel på hur roboten kommer användas. Den svartmarkerade rutan indikerar målet. Den gröna rutan är ett exempel på var föremålet kan benna sig. Sträckan markerad med (1) visar hur roboten kan köra under utforskningsfasen, dvs kartläggning. Sträckan markerad med (2,3,4) visar hur roboten kan köra under undsättningsfasen, dvs (2) köra ut kortaste sträckan och plocka upp föremålet (grön ruta), (3), köra in och lämna av föremålet på svart ruta och sist (4), köra ut och stanna utanför.

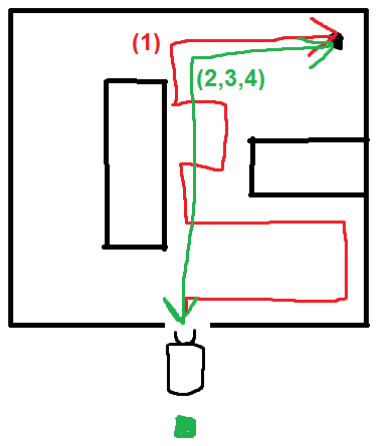
[picture p52: figure]

Figur 1. Exempel på en körning.

TSEA56
LIPS Kravspecikation
2 | Projektgrupp 2 e-post: adnbe196@student.liu.se

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

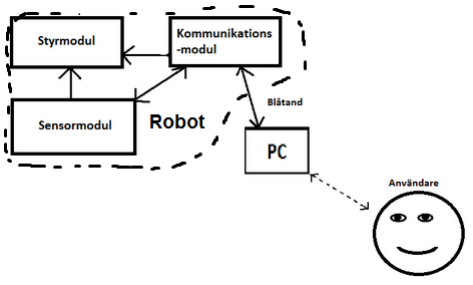
[picture p53: figure]

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

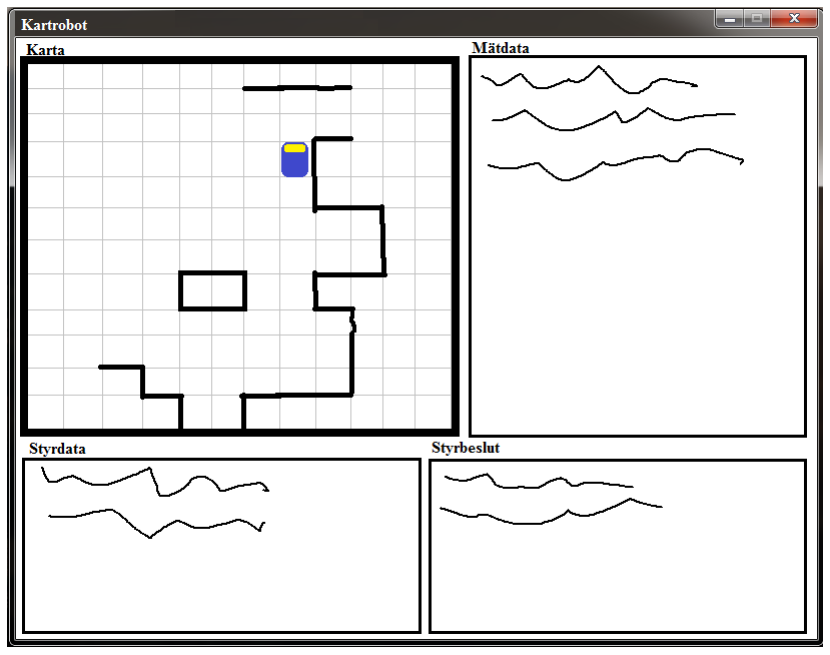
[picture p54: figure]

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
