adnanberberovic/TSEA56Grupp2/FÖRSTUDIE/SENSORUPPGIFT/V1/Förstudie Sensorer V.1/ultra.pdf

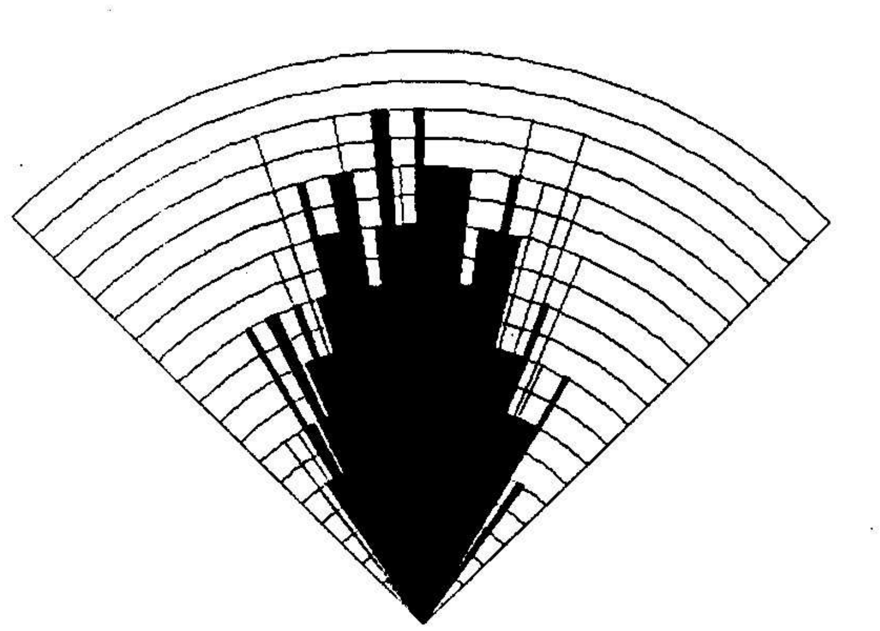
[picture p55: page 1]
