adnanberberovic/TSEA56Grupp2/DOKUMENT/DesignSpec/KOPPLINGSSCHEAMA_SENSOR.jpg

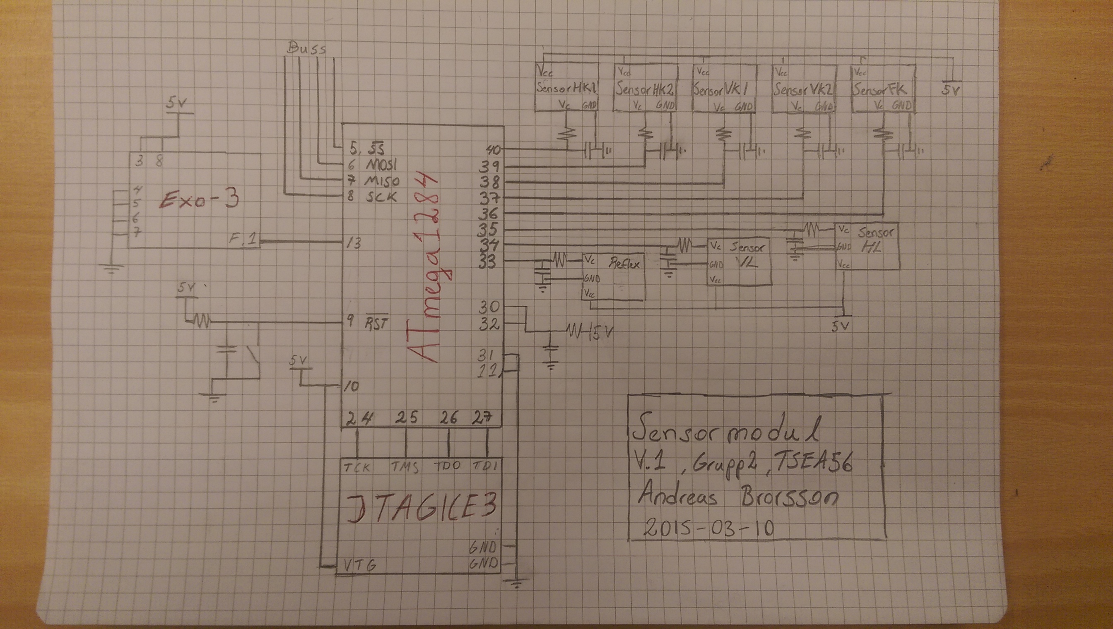
DOKUMENT/DesignSpec/KOPPLINGSSCHEAMA_SENSOR.jpg
