adnanberberovic/TSEA56Grupp2/DOKUMENT/KRAVSPECIFIKATION/Kravspec/images/systemskiss.png

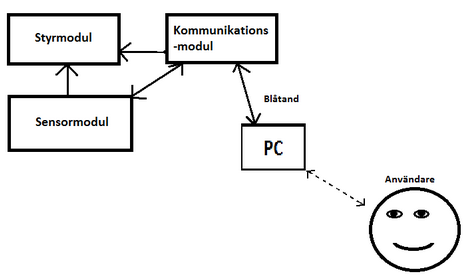
DOKUMENT/KRAVSPECIFIKATION/Kravspec/images/systemskiss.png
