adnanberberovic/TSEA56Grupp2/GUI/Bilder/BG.png

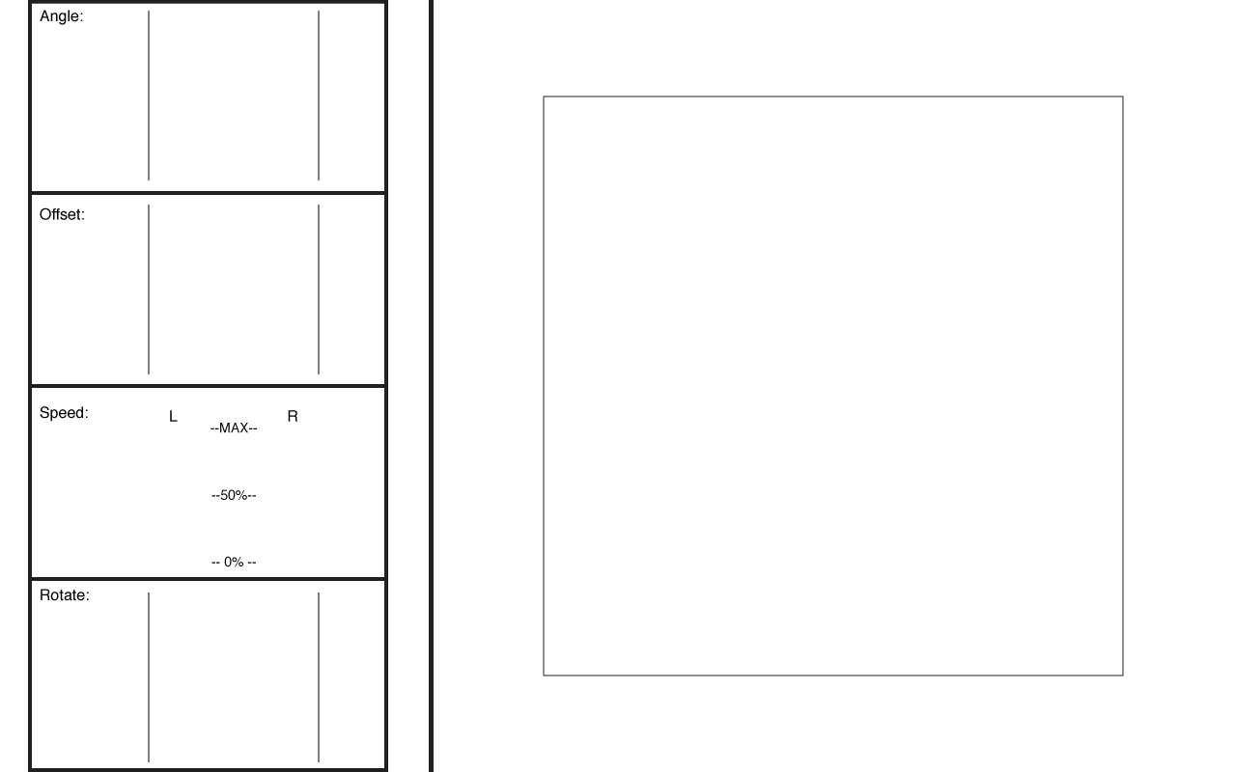
GUI/Bilder/BG.png
