adnanberberovic/TSEA56Grupp2/KONSTRUKTION/BILDER/20150401_132254.jpg

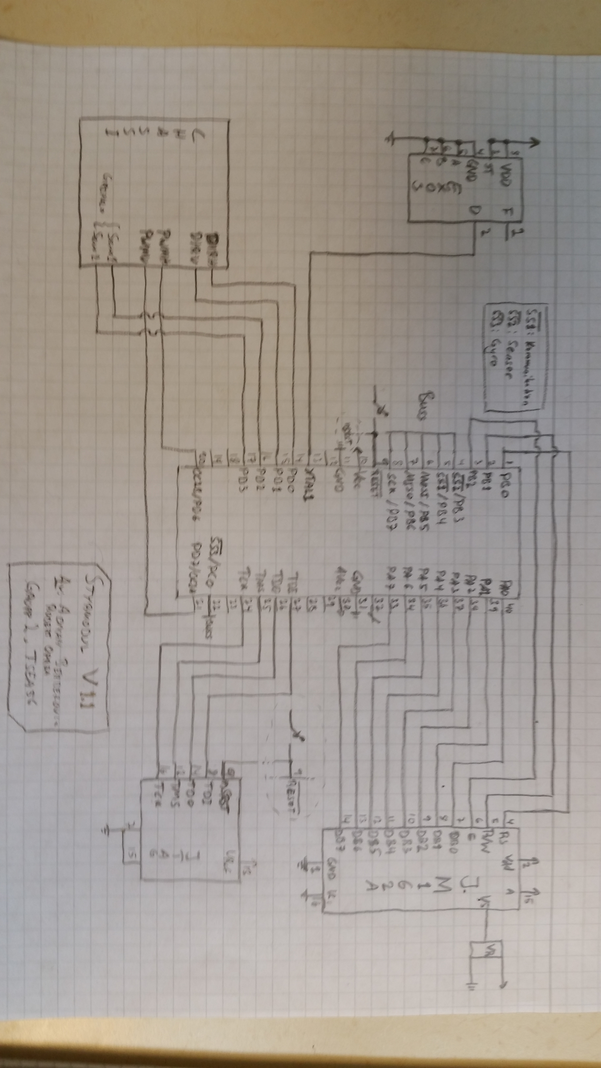
KONSTRUKTION/BILDER/20150401_132254.jpg
