adnanberberovic/TSEA56Grupp2/KONSTRUKTION/BILDER/kopplinsschema_styrmodul_150324.png

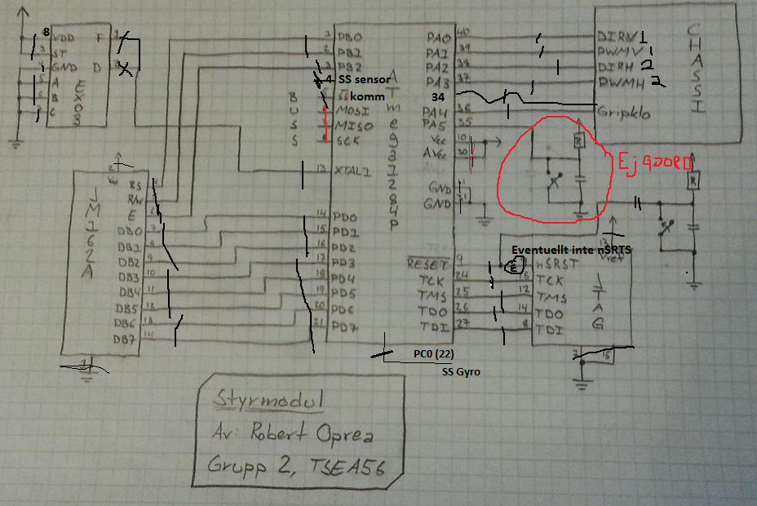
KONSTRUKTION/BILDER/kopplinsschema_styrmodul_150324.png
