adnanberberovic/TSEA56Grupp2/KONSTRUKTION/KOD/Map/Map/Bedug/debug.txt

START 4294967295
0
cPos=(15,15)
cJ=0, JCon=0, lJDir=0, nJs=0, nJl=0
cDir=1, nDir=1
travelledDist=0
2: 2. 1: 1. 0: 0. 
/////////////////////////////          ----------------
/////////////////////////////          ----------------
/////////////////////////////          ----------------
/////////////////////////////          ----------------
/////////////////////////////          ----------------
/////////////////////////////          ----------------
/////////////////////////////          ----------------
/////////////////////////////          ----------------
/////////////////////////////          ----------------
/////////////////////////////          ----------------
/////////////////////////////          ----------------
/////////////////////////////          ----------------
/////////////////////////////          ----------------
/////////////////////////////          ----------------
///////////////./////////////          ----------------
//////////////#O#////////////          ----------------
Normal mode start
Down=0, Left=0, Right=0, Up=1
Visited=1, junction=0
Entered new square
Normal mode end
Op mode: 0 Rot=0 MovF=1
Op mode: 0 Rot=0 MovF=1
Moving forward mode starts
travelledDist=1
curPos=(14,15) 
 Moving forward mode ends
Op mode: 0 Rot=0 MovF=0
Op mode: 0 Rot=0 MovF=0
Op mode: 0 Rot=0 MovF=0

1
cPos=(14,15)
cJ=0, JCon=0, lJDir=0, nJs=0, nJl=0
cDir=1, nDir=1
travelledDist=1
2: 2. 1: 1. 0: 0. 
/////////////////////////////          ----------------
/////////////////////////////          ----------------
/////////////////////////////          ----------------
/////////////////////////////          ----------------
/////////////////////////////          ----------------
/////////////////////////////          ----------------
/////////////////////////////          ----------------
/////////////////////////////          ----------------
/////////////////////////////          ----------------
/////////////////////////////          ----------------
/////////////////////////////          ----------------
/////////////////////////////          ----------------
/////////////////////////////          ----------------
///////////////./////////////          ----------------
//////////////#O.////////////          ----------------
//////////////#:#////////////          ----------------
Normal mode start
Down=0, Left=0, Right=1, Up=1
Visited=1, junction=0
Entered new square
Has unex roads, UnexSQ=2
Array=0, j1=0, j2=0
Array=0, j1=0, j2=0
J#=0, right=0, up=0, left=0, down=0
J#=0, right=0, up=0, left=0, down=0
Normal mode end
Op mode: 0 Rot=0 MovF=1
Op mode: 0 Rot=0 MovF=1
Moving forward mode starts
travelledDist=1
curPos=(13,15) 
 Moving forward mode ends
Op mode: 0 Rot=0 MovF=0
Op mode: 0 Rot=0 MovF=0
Op mode: 0 Rot=0 MovF=0

2
cPos=(13,15)
cJ=0, JCon=1, lJDir=1, nJs=0, nJl=0
cDir=1, nDir=1
travelledDist=1
2: 2. 1: 1. 0: 0. 
/////////////////////////////          ----------------
/////////////////////////////          ----------------
/////////////////////////////          ----------------
/////////////////////////////          ----------------
/////////////////////////////          ----------------
/////////////////////////////          ----------------
/////////////////////////////          ----------------
/////////////////////////////          ----------------
/////////////////////////////          ----------------
/////////////////////////////          ----------------
/////////////////////////////          ----------------
/////////////////////////////          ----------------
///////////////#/////////////          ----------------
//////////////.O#////////////          ----------------
//////////////#X.////////////          ----------------
//////////////#:#////////////          ----------------
Normal mode start
Down=1, Left=1, Right=0, Up=0
Visited=1, junction=0
Entered new square
Normal mode end
Op mode: 0 Rot=1 MovF=1
Rotating mode starts
curDir=2 
 Rotating mode ends
Op mode: 0 Rot=0 MovF=1
Moving forward mode starts
travelledDist=2
curPos=(13,14) 
 Moving forward mode ends
Op mode: 0 Rot=0 MovF=0
Op mode: 0 Rot=0 MovF=0
Op mode: 0 Rot=0 MovF=0

3
cPos=(13,14)
cJ=0, JCon=1, lJDir=1, nJs=0, nJl=0
cDir=2, nDir=2
travelledDist=2
3: 3. 2: 2. 1: 1. 
/////////////////////////////          ----------------
/////////////////////////////          ----------------
/////////////////////////////          ----------------
/////////////////////////////          ----------------
/////////////////////////////          ----------------
/////////////////////////////          ----------------
/////////////////////////////          ----------------
/////////////////////////////          ----------------
/////////////////////////////          ----------------
/////////////////////////////          ----------------
/////////////////////////////          ----------------
/////////////////////////////          ----------------
//////////////##/////////////          ----------------
/////////////.O:#////////////          ----------------
//////////////#X.////////////          ----------------
//////////////#:#////////////          ----------------
Normal mode start
Down=0, Left=1, Right=0, Up=0
Visited=1, junction=0
Entered new square
Normal mode end
Op mode: 0 Rot=0 MovF=1
Op mode: 0 Rot=0 MovF=1
Moving forward mode starts
travelledDist=3
curPos=(13,13) 
 Moving forward mode ends
Op mode: 0 Rot=0 MovF=0
Op mode: 0 Rot=0 MovF=0
Op mode: 0 Rot=0 MovF=0

4
cPos=(13,13)
cJ=0, JCon=1, lJDir=1, nJs=0, nJl=0
cDir=2, nDir=2
travelledDist=3
3: 3. 2: 2. 1: 1. 
/////////////////////////////          ----------------
/////////////////////////////          ----------------
/////////////////////////////          ----------------
/////////////////////////////          ----------------
/////////////////////////////          ----------------
/////////////////////////////          ----------------
/////////////////////////////          ----------------
/////////////////////////////          ----------------
/////////////////////////////          ----------------
/////////////////////////////          ----------------
/////////////////////////////          ----------------
/////////////////////////////          ----------------
/////////////.##/////////////          ----------------
////////////#O::#////////////          ----------------
/////////////.#X.////////////          ----------------
//////////////#:#////////////          ----------------
Normal mode start
Down=1, Left=0, Right=0, Up=1
Visited=1, junction=0
Entered new square
Has unex roads, UnexSQ=2
Array=0, j1=0, j2=1
1337
j1=0, j2=1, direction=1,Added up
j1=1, j2=0, direction=0,Added right
J#=0, right=0, up=1, left=0, down=0
J#=1, right=0, up=0, left=0, down=0
Normal mode end
Op mode: 0 Rot=1 MovF=1
Rotating mode starts
curDir=3 
 Rotating mode ends
Op mode: 0 Rot=0 MovF=1
Moving forward mode starts
travelledDist=1
curPos=(14,13) 
 Moving forward mode ends
Op mode: 0 Rot=0 MovF=0
Op mode: 0 Rot=0 MovF=0
Op mode: 0 Rot=0 MovF=0

5
cPos=(14,13)
cJ=1, JCon=2, lJDir=3, nJs=0, nJl=0
cDir=3, nDir=3
travelledDist=1
0: 0. 3: 3. 2: 2. 
/////////////////////////////          -3--------------
/////////////////////////////          3---------------
/////////////////////////////          ----------------
/////////////////////////////          ----------------
/////////////////////////////          ----------------
/////////////////////////////          ----------------
/////////////////////////////          ----------------
/////////////////////////////          ----------------
/////////////////////////////          ----------------
/////////////////////////////          ----------------
/////////////////////////////          ----------------
/////////////////////////////          ----------------
/////////////.##/////////////          ----------------
////////////#X::#////////////          ----------------
////////////#O#X.////////////          ----------------
/////////////##:#////////////          ----------------
Normal mode start
Down=0, Left=0, Right=0, Up=1
Visited=1, junction=0
Entered new square
Normal mode end
Op mode: 0 Rot=1 MovF=1
Rotating mode starts
curDir=1 
 Rotating mode ends
Op mode: 0 Rot=0 MovF=1
Moving forward mode starts
travelledDist=2
curPos=(13,13) 
 Moving forward mode ends
Op mode: 0 Rot=0 MovF=0
Op mode: 0 Rot=0 MovF=0
Op mode: 0 Rot=0 MovF=0

6
cPos=(13,13)
cJ=1, JCon=2, lJDir=3, nJs=0, nJl=0
cDir=1, nDir=1
travelledDist=2
2: 2. 1: 1. 0: 0. 
/////////////////////////////          -3--------------
/////////////////////////////          3---------------
/////////////////////////////          ----------------
/////////////////////////////          ----------------
/////////////////////////////          ----------------
/////////////////////////////          ----------------
/////////////////////////////          ----------------
/////////////////////////////          ----------------
/////////////////////////////          ----------------
/////////////////////////////          ----------------
/////////////////////////////          ----------------
/////////////////////////////          ----------------
/////////////.##/////////////          ----------------
////////////#O::#////////////          ----------------
////////////#:#X.////////////          ----------------
/////////////##:#////////////          ----------------
Normal mode start
Down=0, Left=0, Right=0, Up=1
Visited=1, junction=1
Entered visited junction
Array=0, j1=1, j2=1
Array=0, j1=1, j2=1
J#=1, right=0, up=0, left=0, down=0
J#=1, right=0, up=0, left=0, down=0
Sent dir=3
Tester=1, UnexSq=1, 0=00, 1=00, 2=00, 3=00
Has UnexSQ=1
Normal mode end
Op mode: 0 Rot=0 MovF=1
Op mode: 0 Rot=0 MovF=1
Moving forward mode starts
travelledDist=1
curPos=(12,13) 
 Moving forward mode ends
Op mode: 0 Rot=0 MovF=0
Op mode: 0 Rot=0 MovF=0
Op mode: 0 Rot=0 MovF=0

7
cPos=(12,13)
cJ=1, JCon=2, lJDir=1, nJs=0, nJl=0
cDir=1, nDir=1
travelledDist=1
2: 2. 1: 1. 0: 0. 
/////////////////////////////          -3--------------
/////////////////////////////          3---------------
/////////////////////////////          ----------------
/////////////////////////////          ----------------
/////////////////////////////          ----------------
/////////////////////////////          ----------------
/////////////////////////////          ----------------
/////////////////////////////          ----------------
/////////////////////////////          ----------------
/////////////////////////////          ----------------
/////////////////////////////          ----------------
/////////////.///////////////          ----------------
////////////#O##/////////////          ----------------
////////////#X::#////////////          ----------------
////////////#:#X.////////////          ----------------
/////////////##:#////////////          ----------------
Normal mode start
Down=1, Left=0, Right=0, Up=1
Visited=1, junction=0
Entered new square
Normal mode end
Op mode: 0 Rot=0 MovF=1
Op mode: 0 Rot=0 MovF=1
Moving forward mode starts
travelledDist=2
curPos=(11,13) 
 Moving forward mode ends
Op mode: 0 Rot=0 MovF=0
Op mode: 0 Rot=0 MovF=0
Op mode: 0 Rot=0 MovF=0

8
cPos=(11,13)
cJ=1, JCon=2, lJDir=1, nJs=0, nJl=0
cDir=1, nDir=1
travelledDist=2
2: 2. 1: 1. 0: 0. 
/////////////////////////////          -3--------------
/////////////////////////////          3---------------
/////////////////////////////          ----------------
/////////////////////////////          ----------------
/////////////////////////////          ----------------
/////////////////////////////          ----------------
/////////////////////////////          ----------------
/////////////////////////////          ----------------
/////////////////////////////          ----------------
/////////////////////////////          ----------------
/////////////.///////////////          ----------------
////////////#O#//////////////          ----------------
////////////#:##/////////////          ----------------
////////////#X::#////////////          ----------------
////////////#:#X.////////////          ----------------
/////////////##:#////////////          ----------------
Normal mode start
Down=0, Left=0, Right=0, Up=1
Visited=1, junction=0
Entered new square
Normal mode end
Op mode: 0 Rot=0 MovF=1
Op mode: 0 Rot=0 MovF=1
Moving forward mode starts
travelledDist=3
curPos=(10,13) 
 Moving forward mode ends
Op mode: 0 Rot=0 MovF=0
Op mode: 0 Rot=0 MovF=0
Op mode: 0 Rot=0 MovF=0

9
cPos=(10,13)
cJ=1, JCon=2, lJDir=1, nJs=0, nJl=0
cDir=1, nDir=1
travelledDist=3
2: 2. 1: 1. 0: 0. 
/////////////////////////////          -3--------------
/////////////////////////////          3---------------
/////////////////////////////          ----------------
/////////////////////////////          ----------------
/////////////////////////////          ----------------
/////////////////////////////          ----------------
/////////////////////////////          ----------------
/////////////////////////////          ----------------
/////////////////////////////          ----------------
/////////////.///////////////          ----------------
////////////#O#//////////////          ----------------
////////////#:#//////////////          ----------------
////////////#:##/////////////          ----------------
////////////#X::#////////////          ----------------
////////////#:#X.////////////          ----------------
/////////////##:#////////////          ----------------
Normal mode start
Down=0, Left=0, Right=0, Up=1
Visited=1, junction=0
Entered new square
Normal mode end
Op mode: 0 Rot=0 MovF=1
Op mode: 0 Rot=0 MovF=1
Moving forward mode starts
travelledDist=4
curPos=(9,13) 
 Moving forward mode ends
Op mode: 0 Rot=0 MovF=0
Op mode: 0 Rot=0 MovF=0
Op mode: 0 Rot=0 MovF=0

10
cPos=(9,13)
cJ=1, JCon=2, lJDir=1, nJs=0, nJl=0
cDir=1, nDir=1
travelledDist=4
2: 2. 1: 1. 0: 0. 
/////////////////////////////          -3--------------
/////////////////////////////          3---------------
/////////////////////////////          ----------------
/////////////////////////////          ----------------
/////////////////////////////          ----------------
/////////////////////////////          ----------------
/////////////////////////////          ----------------
/////////////////////////////          ----------------
/////////////.///////////////          ----------------
////////////#O.//////////////          ----------------
////////////#:#//////////////          ----------------
////////////#:#//////////////          ----------------
////////////#:##/////////////          ----------------
////////////#X::#////////////          ----------------
////////////#:#X.////////////          ----------------
/////////////##:#////////////          ----------------
Normal mode start
Down=0, Left=0, Right=1, Up=1
Visited=1, junction=0
Entered new square
Has unex roads, UnexSQ=2
Array=0, j1=1, j2=2
1337
j1=1, j2=2, direction=1,Added up
j1=2, j2=1, direction=3,Added down
J#=1, right=0, up=2, left=0, down=0
J#=2, right=0, up=0, left=0, down=1
Normal mode end
Op mode: 0 Rot=0 MovF=1
Op mode: 0 Rot=0 MovF=1
Moving forward mode starts
travelledDist=1
curPos=(8,13) 
 Moving forward mode ends
Op mode: 0 Rot=0 MovF=0
Op mode: 0 Rot=0 MovF=0
Op mode: 0 Rot=0 MovF=0

11
cPos=(8,13)
cJ=2, JCon=3, lJDir=1, nJs=0, nJl=0
cDir=1, nDir=1
travelledDist=1
2: 2. 1: 1. 0: 0. 
/////////////////////////////          -3--------------
/////////////////////////////          3-4-------------
/////////////////////////////          -4--------------
/////////////////////////////          ----------------
/////////////////////////////          ----------------
/////////////////////////////          ----------------
/////////////////////////////          ----------------
/////////////.///////////////          ----------------
////////////#O#//////////////          ----------------
////////////#X.//////////////          ----------------
////////////#:#//////////////          ----------------
////////////#:#//////////////          ----------------
////////////#:##/////////////          ----------------
////////////#X::#////////////          ----------------
////////////#:#X.////////////          ----------------
/////////////##:#////////////          ----------------
Normal mode start
Down=1, Left=0, Right=0, Up=1
Visited=1, junction=0
Entered new square
Normal mode end
Op mode: 0 Rot=0 MovF=1
Op mode: 0 Rot=0 MovF=1
Moving forward mode starts
travelledDist=2
curPos=(7,13) 
 Moving forward mode ends
Op mode: 0 Rot=0 MovF=0
Op mode: 0 Rot=0 MovF=0
Op mode: 0 Rot=0 MovF=0

12
cPos=(7,13)
cJ=2, JCon=3, lJDir=1, nJs=0, nJl=0
cDir=1, nDir=1
travelledDist=2
2: 2. 1: 1. 0: 0. 
/////////////////////////////          -3--------------
/////////////////////////////          3-4-------------
/////////////////////////////          -4--------------
/////////////////////////////          ----------------
/////////////////////////////          ----------------
/////////////////////////////          ----------------
/////////////.///////////////          ----------------
////////////#O#//////////////          ----------------
////////////#:#//////////////          ----------------
////////////#X.//////////////          ----------------
////////////#:#//////////////          ----------------
////////////#:#//////////////          ----------------
////////////#:##/////////////          ----------------
////////////#X::#////////////          ----------------
////////////#:#X.////////////          ----------------
/////////////##:#////////////          ----------------
Normal mode start
Down=0, Left=0, Right=0, Up=1
Visited=1, junction=0
Entered new square
Normal mode end
Op mode: 0 Rot=0 MovF=1
Op mode: 0 Rot=0 MovF=1
Moving forward mode starts
travelledDist=3
curPos=(6,13) 
 Moving forward mode ends
Op mode: 0 Rot=0 MovF=0
Op mode: 0 Rot=0 MovF=0
Op mode: 0 Rot=0 MovF=0

13
cPos=(6,13)
cJ=2, JCon=3, lJDir=1, nJs=0, nJl=0
cDir=1, nDir=1
travelledDist=3
2: 2. 1: 1. 0: 0. 
/////////////////////////////          -3--------------
/////////////////////////////          3-4-------------
/////////////////////////////          -4--------------
/////////////////////////////          ----------------
/////////////////////////////          ----------------
/////////////.///////////////          ----------------
////////////#O.//////////////          ----------------
////////////#:#//////////////          ----------------
////////////#:#//////////////          ----------------
////////////#X.//////////////          ----------------
////////////#:#//////////////          ----------------
////////////#:#//////////////          ----------------
////////////#:##/////////////          ----------------
////////////#X::#////////////          ----------------
////////////#:#X.////////////          ----------------
/////////////##:#////////////          ----------------
Normal mode start
Down=0, Left=0, Right=1, Up=1
Visited=1, junction=0
Entered new square
Has unex roads, UnexSQ=2
Array=0, j1=2, j2=3
1337
j1=2, j2=3, direction=1,Added up
j1=3, j2=2, direction=3,Added down
J#=2, right=0, up=3, left=0, down=1
J#=3, right=0, up=0, left=0, down=2
Normal mode end
Op mode: 0 Rot=0 MovF=1
Op mode: 0 Rot=0 MovF=1
Moving forward mode starts
travelledDist=1
curPos=(5,13) 
 Moving forward mode ends
Op mode: 0 Rot=0 MovF=0
Op mode: 0 Rot=0 MovF=0
Op mode: 0 Rot=0 MovF=0

14
cPos=(5,13)
cJ=3, JCon=4, lJDir=1, nJs=0, nJl=0
cDir=1, nDir=1
travelledDist=1
2: 2. 1: 1. 0: 0. 
/////////////////////////////          -3--------------
/////////////////////////////          3-4-------------
/////////////////////////////          -4-3------------
/////////////////////////////          --3-------------
/////////////.///////////////          ----------------
////////////#O#//////////////          ----------------
////////////#X.//////////////          ----------------
////////////#:#//////////////          ----------------
////////////#:#//////////////          ----------------
////////////#X.//////////////          ----------------
////////////#:#//////////////          ----------------
////////////#:#//////////////          ----------------
////////////#:##/////////////          ----------------
////////////#X::#////////////          ----------------
////////////#:#X.////////////          ----------------
/////////////##:#////////////          ----------------
Normal mode start
Down=1, Left=0, Right=0, Up=1
Visited=1, junction=0
Entered new square
Normal mode end
Op mode: 0 Rot=0 MovF=1
Op mode: 0 Rot=0 MovF=1
Moving forward mode starts
travelledDist=2
curPos=(4,13) 
 Moving forward mode ends
Op mode: 0 Rot=0 MovF=0
Op mode: 0 Rot=0 MovF=0
Op mode: 0 Rot=0 MovF=0

15
cPos=(4,13)
cJ=3, JCon=4, lJDir=1, nJs=0, nJl=0
cDir=1, nDir=1
travelledDist=2
2: 2. 1: 1. 0: 0. 
/////////////////////////////          -3--------------
/////////////////////////////          3-4-------------
/////////////////////////////          -4-3------------
/////////////.///////////////          --3-------------
////////////#O#//////////////          ----------------
////////////#:#//////////////          ----------------
////////////#X.//////////////          ----------------
////////////#:#//////////////          ----------------
////////////#:#//////////////          ----------------
////////////#X.//////////////          ----------------
////////////#:#//////////////          ----------------
////////////#:#//////////////          ----------------
////////////#:##/////////////          ----------------
////////////#X::#////////////          ----------------
////////////#:#X.////////////          ----------------
/////////////##:#////////////          ----------------
Normal mode start
Down=0, Left=0, Right=0, Up=1
Visited=1, junction=0
Entered new square
Normal mode end
Op mode: 0 Rot=0 MovF=1
Op mode: 0 Rot=0 MovF=1
Moving forward mode starts
travelledDist=3
curPos=(3,13) 
 Moving forward mode ends
Op mode: 0 Rot=0 MovF=0
Op mode: 0 Rot=0 MovF=0
Op mode: 0 Rot=0 MovF=0

16
cPos=(3,13)
cJ=3, JCon=4, lJDir=1, nJs=0, nJl=0
cDir=1, nDir=1
travelledDist=3
2: 2. 1: 1. 0: 0. 
/////////////////////////////          -3--------------
/////////////////////////////          3-4-------------
/////////////.///////////////          -4-3------------
////////////#O.//////////////          --3-------------
////////////#:#//////////////          ----------------
////////////#:#//////////////          ----------------
////////////#X.//////////////          ----------------
////////////#:#//////////////          ----------------
////////////#:#//////////////          ----------------
////////////#X.//////////////          ----------------
////////////#:#//////////////          ----------------
////////////#:#//////////////          ----------------
////////////#:##/////////////          ----------------
////////////#X::#////////////          ----------------
////////////#:#X.////////////          ----------------
/////////////##:#////////////          ----------------
Normal mode start
Down=0, Left=0, Right=1, Up=1
Visited=1, junction=0
Entered new square
Has unex roads, UnexSQ=2
Array=0, j1=3, j2=4
1337
j1=3, j2=4, direction=1,Added up
j1=4, j2=3, direction=3,Added down
J#=3, right=0, up=4, left=0, down=2
J#=4, right=0, up=0, left=0, down=3
Normal mode end
Op mode: 0 Rot=0 MovF=1
Op mode: 0 Rot=0 MovF=1
Moving forward mode starts
travelledDist=1
curPos=(2,13) 
 Moving forward mode ends
Op mode: 0 Rot=0 MovF=0
Op mode: 0 Rot=0 MovF=0
Op mode: 0 Rot=0 MovF=0

17
cPos=(2,13)
cJ=4, JCon=5, lJDir=1, nJs=0, nJl=0
cDir=1, nDir=1
travelledDist=1
2: 2. 1: 1. 0: 0. 
/////////////////////////////          -3--------------
/////////////#///////////////          3-4-------------
////////////#O#//////////////          -4-3------------
////////////#X.//////////////          --3-3-----------
////////////#:#//////////////          ---3------------
////////////#:#//////////////          ----------------
////////////#X.//////////////          ----------------
////////////#:#//////////////          ----------------
////////////#:#//////////////          ----------------
////////////#X.//////////////          ----------------
////////////#:#//////////////          ----------------
////////////#:#//////////////          ----------------
////////////#:##/////////////          ----------------
////////////#X::#////////////          ----------------
////////////#:#X.////////////          ----------------
/////////////##:#////////////          ----------------
Normal mode start
Down=1, Left=0, Right=0, Up=0
Visited=1, junction=0
Entered new square
Normal mode end
Op mode: 0 Rot=1 MovF=1
Rotating mode starts
curDir=3 
 Rotating mode ends
Op mode: 0 Rot=0 MovF=1
Moving forward mode starts
travelledDist=2
curPos=(3,13) 
 Moving forward mode ends
Op mode: 0 Rot=0 MovF=0
Op mode: 0 Rot=0 MovF=0
Op mode: 0 Rot=0 MovF=0

18
cPos=(3,13)
cJ=4, JCon=5, lJDir=1, nJs=0, nJl=0
cDir=3, nDir=3
travelledDist=2
0: 0. 3: 3. 2: 2. 
/////////////////////////////          -3--------------
/////////////#///////////////          3-4-------------
////////////#:#//////////////          -4-3------------
////////////#O.//////////////          --3-3-----------
////////////#:#//////////////          ---3------------
////////////#:#//////////////          ----------------
////////////#X.//////////////          ----------------
////////////#:#//////////////          ----------------
////////////#:#//////////////          ----------------
////////////#X.//////////////          ----------------
////////////#:#//////////////          ----------------
////////////#:#//////////////          ----------------
////////////#:##/////////////          ----------------
////////////#X::#////////////          ----------------
////////////#:#X.////////////          ----------------
/////////////##:#////////////          ----------------
Normal mode start
Down=0, Left=0, Right=1, Up=0
Visited=1, junction=1
Entered visited junction
Array=0, j1=4, j2=4
Array=0, j1=4, j2=4
J#=4, right=0, up=0, left=0, down=3
J#=4, right=0, up=0, left=0, down=3
Sent dir=1
Tester=1, UnexSq=1, 0=00, 1=00, 2=00, 3=00
Has UnexSQ=1
Normal mode end
Op mode: 0 Rot=1 MovF=1
Rotating mode starts
curDir=0 
 Rotating mode ends
Op mode: 0 Rot=0 MovF=1
Moving forward mode starts
travelledDist=1
curPos=(3,14) 
 Moving forward mode ends
Op mode: 0 Rot=0 MovF=0
Op mode: 0 Rot=0 MovF=0
Op mode: 0 Rot=0 MovF=0

19
cPos=(3,14)
cJ=4, JCon=5, lJDir=0, nJs=0, nJl=0
cDir=0, nDir=0
travelledDist=1
1: 1. 0: 0. 3: 3. 
/////////////////////////////          -3--------------
/////////////#///////////////          3-4-------------
////////////#:#//////////////          -4-3------------
////////////#XO./////////////          --3-3-----------
////////////#:#//////////////          ---3------------
////////////#:#//////////////          ----------------
////////////#X.//////////////          ----------------
////////////#:#//////////////          ----------------
////////////#:#//////////////          ----------------
////////////#X.//////////////          ----------------
////////////#:#//////////////          ----------------
////////////#:#//////////////          ----------------
////////////#:##/////////////          ----------------
////////////#X::#////////////          ----------------
////////////#:#X.////////////          ----------------
/////////////##:#////////////          ----------------
Normal mode start
Down=0, Left=1, Right=1, Up=0
Visited=1, junction=0
Entered new square
Normal mode end
Op mode: 0 Rot=0 MovF=1
Op mode: 0 Rot=0 MovF=1
Moving forward mode starts
travelledDist=2
curPos=(3,15) 
 Moving forward mode ends
Op mode: 0 Rot=0 MovF=0
Op mode: 0 Rot=0 MovF=0
Op mode: 0 Rot=0 MovF=0

20
cPos=(3,15)
cJ=4, JCon=5, lJDir=0, nJs=0, nJl=0
cDir=0, nDir=0
travelledDist=2
1: 1. 0: 0. 3: 3. 
/////////////////////////////          -3--------------
/////////////#///////////////          3-4-------------
////////////#:##/////////////          -4-3------------
////////////#X:O#////////////          --3-3-----------
////////////#:#./////////////          ---3------------
////////////#:#//////////////          ----------------
////////////#X.//////////////          ----------------
////////////#:#//////////////          ----------------
////////////#:#//////////////          ----------------
////////////#X.//////////////          ----------------
////////////#:#//////////////          ----------------
////////////#:#//////////////          ----------------
////////////#:##/////////////          ----------------
////////////#X::#////////////          ----------------
////////////#:#X.////////////          ----------------
/////////////##:#////////////          ----------------
Normal mode start
Down=1, Left=0, Right=0, Up=0
Visited=1, junction=0
Entered new square
Normal mode end
Op mode: 0 Rot=1 MovF=1
Rotating mode starts
curDir=3 
 Rotating mode ends
Op mode: 0 Rot=0 MovF=1
Moving forward mode starts
travelledDist=3
curPos=(4,15) 
 Moving forward mode ends
Op mode: 0 Rot=0 MovF=0
Op mode: 0 Rot=0 MovF=0
Op mode: 0 Rot=0 MovF=0

21
cPos=(4,15)
cJ=4, JCon=5, lJDir=0, nJs=0, nJl=0
cDir=3, nDir=3
travelledDist=3
0: 0. 3: 3. 2: 2. 
/////////////////////////////          -3--------------
/////////////#///////////////          3-4-------------
////////////#:##/////////////          -4-3------------
////////////#X::#////////////          --3-3-----------
////////////#:#O.////////////          ---3------------
////////////#:##/////////////          ----------------
////////////#X.//////////////          ----------------
////////////#:#//////////////          ----------------
////////////#:#//////////////          ----------------
////////////#X.//////////////          ----------------
////////////#:#//////////////          ----------------
////////////#:#//////////////          ----------------
////////////#:##/////////////          ----------------
////////////#X::#////////////          ----------------
////////////#:#X.////////////          ----------------
/////////////##:#////////////          ----------------
Normal mode start
Down=0, Left=0, Right=1, Up=0
Visited=1, junction=0
Entered new square
Normal mode end
Op mode: 0 Rot=1 MovF=1
Rotating mode starts
curDir=0 
 Rotating mode ends
Op mode: 0 Rot=0 MovF=1
Moving forward mode starts
travelledDist=4
curPos=(4,16) 
 Moving forward mode ends
Op mode: 0 Rot=0 MovF=0
Op mode: 0 Rot=0 MovF=0
Op mode: 0 Rot=0 MovF=0

22
cPos=(4,16)
cJ=4, JCon=5, lJDir=0, nJs=0, nJl=0
cDir=0, nDir=0
travelledDist=4
1: 1. 0: 0. 3: 3. 
/////////////////////////////          -3--------------
/////////////#///////////////          3-4-------------
////////////#:##/////////////          -4-3------------
////////////#X::#////////////          --3-3-----------
////////////#:#:O.///////////          ---3------------
////////////#:###////////////          ----------------
////////////#X.//////////////          ----------------
////////////#:#//////////////          ----------------
////////////#:#//////////////          ----------------
////////////#X.//////////////          ----------------
////////////#:#//////////////          ----------------
////////////#:#//////////////          ----------------
////////////#:##/////////////          ----------------
////////////#X::#////////////          ----------------
////////////#:#X.////////////          ----------------
/////////////##:#////////////          ----------------
Normal mode start
Down=0, Left=0, Right=1, Up=0
Visited=1, junction=0
Entered new square
Normal mode end
Op mode: 0 Rot=0 MovF=1
Op mode: 0 Rot=0 MovF=1
Moving forward mode starts
travelledDist=5
curPos=(4,17) 
 Moving forward mode ends
Op mode: 0 Rot=0 MovF=0
Op mode: 0 Rot=0 MovF=0
Op mode: 0 Rot=0 MovF=0

23
cPos=(4,17)
cJ=4, JCon=5, lJDir=0, nJs=0, nJl=0
cDir=0, nDir=0
travelledDist=5
1: 1. 0: 0. 3: 3. 
/////////////////////////////          -3--------------
/////////////#///////////////          3-4-------------
////////////#:##/////////////          -4-3------------
////////////#X::##///////////          --3-3-----------
////////////#:#::O.//////////          ---3------------
////////////#:###.///////////          ----------------
////////////#X.//////////////          ----------------
////////////#:#//////////////          ----------------
////////////#:#//////////////          ----------------
////////////#X.//////////////          ----------------
////////////#:#//////////////          ----------------
////////////#:#//////////////          ----------------
////////////#:##/////////////          ----------------
////////////#X::#////////////          ----------------
////////////#:#X.////////////          ----------------
/////////////##:#////////////          ----------------
Normal mode start
Down=1, Left=0, Right=1, Up=0
Visited=1, junction=0
Entered new square
Has unex roads, UnexSQ=2
Array=0, j1=4, j2=5
1337
j1=4, j2=5, direction=0,Added right
j1=5, j2=4, direction=2,Added left
J#=4, right=5, up=0, left=0, down=3
J#=5, right=0, up=0, left=4, down=0
Normal mode end
Op mode: 0 Rot=0 MovF=1
Op mode: 0 Rot=0 MovF=1
Moving forward mode starts
travelledDist=1
curPos=(4,18) 
 Moving forward mode ends
Op mode: 0 Rot=0 MovF=0
Op mode: 0 Rot=0 MovF=0
Op mode: 0 Rot=0 MovF=0

24
cPos=(4,18)
cJ=5, JCon=6, lJDir=0, nJs=0, nJl=0
cDir=0, nDir=0
travelledDist=1
1: 1. 0: 0. 3: 3. 
/////////////////////////////          -3--------------
/////////////#///////////////          3-4-------------
////////////#:##/////////////          -4-3------------
////////////#X::###//////////          --3-3-----------
////////////#:#::XO./////////          ---3-5----------
////////////#:###.#//////////          ----5-----------
////////////#X.//////////////          ----------------
////////////#:#//////////////          ----------------
////////////#:#//////////////          ----------------
////////////#X.//////////////          ----------------
////////////#:#//////////////          ----------------
////////////#:#//////////////          ----------------
////////////#:##/////////////          ----------------
////////////#X::#////////////          ----------------
////////////#:#X.////////////          ----------------
/////////////##:#////////////          ----------------
Normal mode start
Down=0, Left=1, Right=1, Up=0
Visited=1, junction=0
Entered new square
Normal mode end
Op mode: 0 Rot=0 MovF=1
Op mode: 0 Rot=0 MovF=1
Moving forward mode starts
travelledDist=2
curPos=(4,19) 
 Moving forward mode ends
Op mode: 0 Rot=0 MovF=0
Op mode: 0 Rot=0 MovF=0
Op mode: 0 Rot=0 MovF=0

25
cPos=(4,19)
cJ=5, JCon=6, lJDir=0, nJs=0, nJl=0
cDir=0, nDir=0
travelledDist=2
1: 1. 0: 0. 3: 3. 
/////////////////////////////          -3--------------
/////////////#///////////////          3-4-------------
////////////#:##/////////////          -4-3------------
////////////#X::####/////////          --3-3-----------
////////////#:#::X:O.////////          ---3-5----------
////////////#:###.##/////////          ----5-----------
////////////#X.//////////////          ----------------
////////////#:#//////////////          ----------------
////////////#:#//////////////          ----------------
////////////#X.//////////////          ----------------
////////////#:#//////////////          ----------------
////////////#:#//////////////          ----------------
////////////#:##/////////////          ----------------
////////////#X::#////////////          ----------------
////////////#:#X.////////////          ----------------
/////////////##:#////////////          ----------------
Normal mode start
Down=0, Left=0, Right=1, Up=0
Visited=1, junction=0
Entered new square
Normal mode end
Op mode: 0 Rot=0 MovF=1
Op mode: 0 Rot=0 MovF=1
Moving forward mode starts
travelledDist=3
curPos=(4,20) 
 Moving forward mode ends
Op mode: 0 Rot=0 MovF=0
Op mode: 0 Rot=0 MovF=0
Op mode: 0 Rot=0 MovF=0

26
cPos=(4,20)
cJ=5, JCon=6, lJDir=0, nJs=0, nJl=0
cDir=0, nDir=0
travelledDist=3
1: 1. 0: 0. 3: 3. 
/////////////////////////////          -3--------------
/////////////#///////////////          3-4-------------
////////////#:##/////////////          -4-3------------
////////////#X::####.////////          --3-3-----------
////////////#:#::X::O.///////          ---3-5----------
////////////#:###.###////////          ----5-----------
////////////#X.//////////////          ----------------
////////////#:#//////////////          ----------------
////////////#:#//////////////          ----------------
////////////#X.//////////////          ----------------
////////////#:#//////////////          ----------------
////////////#:#//////////////          ----------------
////////////#:##/////////////          ----------------
////////////#X::#////////////          ----------------
////////////#:#X.////////////          ----------------
/////////////##:#////////////          ----------------
Normal mode start
Down=0, Left=0, Right=1, Up=1
Visited=1, junction=0
Entered new square
Has unex roads, UnexSQ=2
Array=0, j1=5, j2=6
1337
j1=5, j2=6, direction=0,Added right
j1=6, j2=5, direction=2,Added left
J#=5, right=6, up=0, left=4, down=0
J#=6, right=0, up=0, left=5, down=0
Normal mode end
Op mode: 0 Rot=1 MovF=1
Rotating mode starts
curDir=1 
 Rotating mode ends
Op mode: 0 Rot=0 MovF=1
Moving forward mode starts
travelledDist=1
curPos=(3,20) 
 Moving forward mode ends
Op mode: 0 Rot=0 MovF=0
Op mode: 0 Rot=0 MovF=0
Op mode: 0 Rot=0 MovF=0

27
cPos=(3,20)
cJ=6, JCon=7, lJDir=1, nJs=0, nJl=0
cDir=1, nDir=1
travelledDist=1
2: 2. 1: 1. 0: 0. 
/////////////////////////////          -3--------------
/////////////#///////////////          3-4-------------
////////////#:##////.////////          -4-3------------
////////////#X::####O#///////          --3-3-----------
////////////#:#::X::X.///////          ---3-5----------
////////////#:###.###////////          ----5-3---------
////////////#X.//////////////          -----3----------
////////////#:#//////////////          ----------------
////////////#:#//////////////          ----------------
////////////#X.//////////////          ----------------
////////////#:#//////////////          ----------------
////////////#:#//////////////          ----------------
////////////#:##/////////////          ----------------
////////////#X::#////////////          ----------------
////////////#:#X.////////////          ----------------
/////////////##:#////////////          ----------------
Normal mode start
Down=1, Left=0, Right=0, Up=1
Visited=1, junction=0
Entered new square
Normal mode end
Op mode: 0 Rot=0 MovF=1
Op mode: 0 Rot=0 MovF=1
Moving forward mode starts
travelledDist=2
curPos=(2,20) 
 Moving forward mode ends
Op mode: 0 Rot=0 MovF=0
Op mode: 0 Rot=0 MovF=0
Op mode: 0 Rot=0 MovF=0

28
cPos=(2,20)
cJ=6, JCon=7, lJDir=1, nJs=0, nJl=0
cDir=1, nDir=1
travelledDist=2
2: 2. 1: 1. 0: 0. 
/////////////////////////////          -3--------------
/////////////#//////#////////          3-4-------------
////////////#:##///.O#///////          -4-3------------
////////////#X::####:#///////          --3-3-----------
////////////#:#::X::X.///////          ---3-5----------
////////////#:###.###////////          ----5-3---------
////////////#X.//////////////          -----3----------
////////////#:#//////////////          ----------------
////////////#:#//////////////          ----------------
////////////#X.//////////////          ----------------
////////////#:#//////////////          ----------------
////////////#:#//////////////          ----------------
////////////#:##/////////////          ----------------
////////////#X::#////////////          ----------------
////////////#:#X.////////////          ----------------
/////////////##:#////////////          ----------------
Normal mode start
Down=0, Left=1, Right=0, Up=0
Visited=1, junction=0
Entered new square
Normal mode end
Op mode: 0 Rot=1 MovF=1
Rotating mode starts
curDir=2 
 Rotating mode ends
Op mode: 0 Rot=0 MovF=1
Moving forward mode starts
travelledDist=3
curPos=(2,19) 
 Moving forward mode ends
Op mode: 0 Rot=0 MovF=0
Op mode: 0 Rot=0 MovF=0
Op mode: 0 Rot=0 MovF=0

29
cPos=(2,19)
cJ=6, JCon=7, lJDir=1, nJs=0, nJl=0
cDir=2, nDir=2
travelledDist=3
3: 3. 2: 2. 1: 1. 
/////////////////////////////          -3--------------
/////////////#/////##////////          3-4-------------
////////////#:##//.O:#///////          -4-3------------
////////////#X::####:#///////          --3-3-----------
////////////#:#::X::X.///////          ---3-5----------
////////////#:###.###////////          ----5-3---------
////////////#X.//////////////          -----3----------
////////////#:#//////////////          ----------------
////////////#:#//////////////          ----------------
////////////#X.//////////////          ----------------
////////////#:#//////////////          ----------------
////////////#:#//////////////          ----------------
////////////#:##/////////////          ----------------
////////////#X::#////////////          ----------------
////////////#:#X.////////////          ----------------
/////////////##:#////////////          ----------------
Normal mode start
Down=0, Left=1, Right=0, Up=0
Visited=1, junction=0
Entered new square
Normal mode end
Op mode: 0 Rot=0 MovF=1
Op mode: 0 Rot=0 MovF=1
Moving forward mode starts
travelledDist=4
curPos=(2,18) 
 Moving forward mode ends
Op mode: 0 Rot=0 MovF=0
Op mode: 0 Rot=0 MovF=0
Op mode: 0 Rot=0 MovF=0

30
cPos=(2,18)
cJ=6, JCon=7, lJDir=1, nJs=0, nJl=0
cDir=2, nDir=2
travelledDist=4
3: 3. 2: 2. 1: 1. 
/////////////////////////////          -3--------------
/////////////#////###////////          3-4-------------
////////////#:##/.O::#///////          -4-3------------
////////////#X::####:#///////          --3-3-----------
////////////#:#::X::X.///////          ---3-5----------
////////////#:###.###////////          ----5-3---------
////////////#X.//////////////          -----3----------
////////////#:#//////////////          ----------------
////////////#:#//////////////          ----------------
////////////#X.//////////////          ----------------
////////////#:#//////////////          ----------------
////////////#:#//////////////          ----------------
////////////#:##/////////////          ----------------
////////////#X::#////////////          ----------------
////////////#:#X.////////////          ----------------
/////////////##:#////////////          ----------------
Normal mode start
Down=0, Left=1, Right=0, Up=0
Visited=1, junction=0
Entered new square
Normal mode end
Op mode: 0 Rot=0 MovF=1
Op mode: 0 Rot=0 MovF=1
Moving forward mode starts
travelledDist=5
curPos=(2,17) 
 Moving forward mode ends
Op mode: 0 Rot=0 MovF=0
Op mode: 0 Rot=0 MovF=0
Op mode: 0 Rot=0 MovF=0

31
cPos=(2,17)
cJ=6, JCon=7, lJDir=1, nJs=0, nJl=0
cDir=2, nDir=2
travelledDist=5
3: 3. 2: 2. 1: 1. 
/////////////////////////////          -3--------------
/////////////#///####////////          3-4-------------
////////////#:###O:::#///////          -4-3------------
////////////#X::####:#///////          --3-3-----------
////////////#:#::X::X.///////          ---3-5----------
////////////#:###.###////////          ----5-3---------
////////////#X.//////////////          -----3----------
////////////#:#//////////////          ----------------
////////////#:#//////////////          ----------------
////////////#X.//////////////          ----------------
////////////#:#//////////////          ----------------
////////////#:#//////////////          ----------------
////////////#:##/////////////          ----------------
////////////#X::#////////////          ----------------
////////////#:#X.////////////          ----------------
/////////////##:#////////////          ----------------
Normal mode start
Down=0, Left=0, Right=0, Up=0
Visited=1, junction=0
Entered new square
Dead end, UnexSq=0
Rotating mode starts
curDir=0 
 Rotating mode ends
Op mode: 3 Rot=0 MovF=1
Moving forward mode starts
travelledDist=6
curPos=(2,18) 
 Moving forward mode ends
Op mode: 3 Rot=0 MovF=0
Go to junction mode starts
Down=0
Up=0
Go to junction mode ends
Op mode: 3 Rot=0 MovF=1
Op mode: 3 Rot=0 MovF=1

32
cPos=(2,18)
cJ=6, JCon=7, lJDir=1, nJs=6, nJl=0
cDir=0, nDir=0
travelledDist=6
1: 1. 0: 0. 3: 3. 
/////////////////////////////          -3--------------
/////////////#///####////////          3-4-------------
////////////#:###:O::#///////          -4-3------------
////////////#X::####:#///////          --3-3-----------
////////////#:#::X::X.///////          ---3-5----------
////////////#:###.###////////          ----5-3---------
////////////#X.//////////////          -----3----------
////////////#:#//////////////          ----------------
////////////#:#//////////////          ----------------
////////////#X.//////////////          ----------------
////////////#:#//////////////          ----------------
////////////#:#//////////////          ----------------
////////////#:##/////////////          ----------------
////////////#X::#////////////          ----------------
////////////#:#X.////////////          ----------------
/////////////##:#////////////          ----------------
Op mode: 3 Rot=0 MovF=1
Op mode: 3 Rot=0 MovF=1
Moving forward mode starts
travelledDist=7
curPos=(2,19) 
 Moving forward mode ends
Op mode: 3 Rot=0 MovF=0
Go to junction mode starts
Down=0
Up=0
Go to junction mode ends
Op mode: 3 Rot=0 MovF=1
Op mode: 3 Rot=0 MovF=1

33
cPos=(2,19)
cJ=6, JCon=7, lJDir=1, nJs=6, nJl=0
cDir=0, nDir=0
travelledDist=7
1: 1. 0: 0. 3: 3. 
/////////////////////////////          -3--------------
/////////////#///####////////          3-4-------------
////////////#:###::O:#///////          -4-3------------
////////////#X::####:#///////          --3-3-----------
////////////#:#::X::X.///////          ---3-5----------
////////////#:###.###////////          ----5-3---------
////////////#X.//////////////          -----3----------
////////////#:#//////////////          ----------------
////////////#:#//////////////          ----------------
////////////#X.//////////////          ----------------
////////////#:#//////////////          ----------------
////////////#:#//////////////          ----------------
////////////#:##/////////////          ----------------
////////////#X::#////////////          ----------------
////////////#:#X.////////////          ----------------
/////////////##:#////////////          ----------------
Op mode: 3 Rot=0 MovF=1
Op mode: 3 Rot=0 MovF=1
Moving forward mode starts
travelledDist=8
curPos=(2,20) 
 Moving forward mode ends
Op mode: 3 Rot=0 MovF=0
Go to junction mode starts
Down=1
ROT=-1
Go to junction mode ends
Op mode: 3 Rot=1 MovF=1
Op mode: 3 Rot=1 MovF=1

34
cPos=(2,20)
cJ=6, JCon=7, lJDir=1, nJs=6, nJl=0
cDir=0, nDir=3
travelledDist=8
1: 1. 0: 0. 3: 3. 
/////////////////////////////          -3--------------
/////////////#///####////////          3-4-------------
////////////#:###:::O#///////          -4-3------------
////////////#X::####:#///////          --3-3-----------
////////////#:#::X::X.///////          ---3-5----------
////////////#:###.###////////          ----5-3---------
////////////#X.//////////////          -----3----------
////////////#:#//////////////          ----------------
////////////#:#//////////////          ----------------
////////////#X.//////////////          ----------------
////////////#:#//////////////          ----------------
////////////#:#//////////////          ----------------
////////////#:##/////////////          ----------------
////////////#X::#////////////          ----------------
////////////#:#X.////////////          ----------------
/////////////##:#////////////          ----------------
Op mode: 3 Rot=1 MovF=1
Rotating mode starts
curDir=3 
 Rotating mode ends
Op mode: 3 Rot=0 MovF=1
Moving forward mode starts
travelledDist=9
curPos=(3,20) 
 Moving forward mode ends
Op mode: 3 Rot=0 MovF=0
Go to junction mode starts
Left=0
Right=0
Go to junction mode ends
Op mode: 3 Rot=0 MovF=1
Op mode: 3 Rot=0 MovF=1

35
cPos=(3,20)
cJ=6, JCon=7, lJDir=1, nJs=6, nJl=0
cDir=3, nDir=3
travelledDist=9
0: 0. 3: 3. 2: 2. 
/////////////////////////////          -3--------------
/////////////#///####////////          3-4-------------
////////////#:###::::#///////          -4-3------------
////////////#X::####O#///////          --3-3-----------
////////////#:#::X::X.///////          ---3-5----------
////////////#:###.###////////          ----5-3---------
////////////#X.//////////////          -----3----------
////////////#:#//////////////          ----------------
////////////#:#//////////////          ----------------
////////////#X.//////////////          ----------------
////////////#:#//////////////          ----------------
////////////#:#//////////////          ----------------
////////////#:##/////////////          ----------------
////////////#X::#////////////          ----------------
////////////#:#X.////////////          ----------------
/////////////##:#////////////          ----------------
Op mode: 3 Rot=0 MovF=1
Op mode: 3 Rot=0 MovF=1
Moving forward mode starts
travelledDist=10
curPos=(4,20) 
 Moving forward mode ends
Op mode: 3 Rot=0 MovF=0
Go to junction mode starts
Left=1
ROT=-1
curJ=nJs!!
Down=0, Left=0, Right=1, Up=0
Tester=1, UnexSq=1, 0=00, 1=00, 2=00, 3=00
UnexSq exist!!
Go to junction mode ends
Op mode: 0 Rot=0 MovF=0
Op mode: 0 Rot=0 MovF=0

36
cPos=(4,20)
cJ=6, JCon=7, lJDir=1, nJs=6, nJl=0
cDir=3, nDir=0
travelledDist=0
0: 0. 3: 3. 2: 2. 
/////////////////////////////          -3--------------
/////////////#///####////////          3-4-------------
////////////#:###::::#///////          -4-3------------
////////////#X::####:#///////          --3-3-----------
////////////#:#::X::O.///////          ---3-5----------
////////////#:###.###////////          ----5-3---------
////////////#X.//////////////          -----3----------
////////////#:#//////////////          ----------------
////////////#:#//////////////          ----------------
////////////#X.//////////////          ----------------
////////////#:#//////////////          ----------------
////////////#:#//////////////          ----------------
////////////#:##/////////////          ----------------
////////////#X::#////////////          ----------------
////////////#:#X.////////////          ----------------
/////////////##:#////////////          ----------------
Normal mode start
Down=0, Left=0, Right=1, Up=0
Visited=1, junction=1
Entered visited junction
Array=0, j1=6, j2=6
Array=0, j1=6, j2=6
J#=6, right=0, up=0, left=5, down=0
J#=6, right=0, up=0, left=5, down=0
Sent dir=1
Tester=1, UnexSq=1, 0=00, 1=00, 2=00, 3=00
Has UnexSQ=1
Normal mode end
Op mode: 0 Rot=1 MovF=1
Rotating mode starts
curDir=0 
 Rotating mode ends
Op mode: 0 Rot=0 MovF=1
Moving forward mode starts
travelledDist=1
curPos=(4,21) 
 Moving forward mode ends
Op mode: 0 Rot=0 MovF=0
Op mode: 0 Rot=0 MovF=0
Op mode: 0 Rot=0 MovF=0

37
cPos=(4,21)
cJ=6, JCon=7, lJDir=0, nJs=6, nJl=0
cDir=0, nDir=0
travelledDist=1
1: 1. 0: 0. 3: 3. 
/////////////////////////////          -3--------------
/////////////#///####////////          3-4-------------
////////////#:###::::#///////          -4-3------------
////////////#X::####:#///////          --3-3-----------
////////////#:#::X::XO#//////          ---3-5----------
////////////#:###.###.///////          ----5-3---------
////////////#X.//////////////          -----3----------
////////////#:#//////////////          ----------------
////////////#:#//////////////          ----------------
////////////#X.//////////////          ----------------
////////////#:#//////////////          ----------------
////////////#:#//////////////          ----------------
////////////#:##/////////////          ----------------
////////////#X::#////////////          ----------------
////////////#:#X.////////////          ----------------
/////////////##:#////////////          ----------------
Normal mode start
Down=1, Left=1, Right=0, Up=0
Visited=1, junction=0
Entered new square
Normal mode end
Op mode: 0 Rot=1 MovF=1
Rotating mode starts
curDir=3 
 Rotating mode ends
Op mode: 0 Rot=0 MovF=1
Moving forward mode starts
travelledDist=2
curPos=(5,21) 
 Moving forward mode ends
Op mode: 0 Rot=0 MovF=0
Op mode: 0 Rot=0 MovF=0
Op mode: 0 Rot=0 MovF=0

38
cPos=(5,21)
cJ=6, JCon=7, lJDir=0, nJs=6, nJl=0
cDir=3, nDir=3
travelledDist=2
0: 0. 3: 3. 2: 2. 
/////////////////////////////          -3--------------
/////////////#///####////////          3-4-------------
////////////#:###::::#///////          -4-3------------
////////////#X::####:#///////          --3-3-----------
////////////#:#::X::X:#//////          ---3-5----------
////////////#:###.###O.//////          ----5-3---------
////////////#X.//////.///////          -----3----------
////////////#:#//////////////          ----------------
////////////#:#//////////////          ----------------
////////////#X.//////////////          ----------------
////////////#:#//////////////          ----------------
////////////#:#//////////////          ----------------
////////////#:##/////////////          ----------------
////////////#X::#////////////          ----------------
////////////#:#X.////////////          ----------------
/////////////##:#////////////          ----------------
Normal mode start
Down=1, Left=0, Right=1, Up=0
Visited=1, junction=0
Entered new square
Has unex roads, UnexSQ=2
Array=0, j1=6, j2=7
1337
j1=6, j2=7, direction=0,Added right
j1=7, j2=6, direction=1,Added up
J#=6, right=7, up=0, left=5, down=0
J#=7, right=0, up=6, left=0, down=0
Normal mode end
Op mode: 0 Rot=1 MovF=1
Rotating mode starts
curDir=0 
 Rotating mode ends
Op mode: 0 Rot=0 MovF=1
Moving forward mode starts
travelledDist=1
curPos=(5,22) 
 Moving forward mode ends
Op mode: 0 Rot=0 MovF=0
Op mode: 0 Rot=0 MovF=0
Op mode: 0 Rot=0 MovF=0

39
cPos=(5,22)
cJ=7, JCon=8, lJDir=0, nJs=6, nJl=0
cDir=0, nDir=0
travelledDist=1
1: 1. 0: 0. 3: 3. 
/////////////////////////////          -3--------------
/////////////#///####////////          3-4-------------
////////////#:###::::#///////          -4-3------------
////////////#X::####:#///////          --3-3-----------
////////////#:#::X::X:#//////          ---3-5----------
////////////#:###.###XO./////          ----5-3---------
////////////#X.//////.#//////          -----3-2--------
////////////#:#//////////////          ------2---------
////////////#:#//////////////          ----------------
////////////#X.//////////////          ----------------
////////////#:#//////////////          ----------------
////////////#:#//////////////          ----------------
////////////#:##/////////////          ----------------
////////////#X::#////////////          ----------------
////////////#:#X.////////////          ----------------
/////////////##:#////////////          ----------------
Normal mode start
Down=0, Left=1, Right=1, Up=0
Visited=1, junction=0
Entered new square
Normal mode end
Op mode: 0 Rot=0 MovF=1
Op mode: 0 Rot=0 MovF=1
Moving forward mode starts
travelledDist=2
curPos=(5,23) 
 Moving forward mode ends
Op mode: 0 Rot=0 MovF=0
Op mode: 0 Rot=0 MovF=0
Op mode: 0 Rot=0 MovF=0

40
cPos=(5,23)
cJ=7, JCon=8, lJDir=0, nJs=6, nJl=0
cDir=0, nDir=0
travelledDist=2
1: 1. 0: 0. 3: 3. 
/////////////////////////////          -3--------------
/////////////#///####////////          3-4-------------
////////////#:###::::#///////          -4-3------------
////////////#X::####:#///////          --3-3-----------
////////////#:#::X::X:##/////          ---3-5----------
////////////#:###.###X:O.////          ----5-3---------
////////////#X.//////.##/////          -----3-2--------
////////////#:#//////////////          ------2---------
////////////#:#//////////////          ----------------
////////////#X.//////////////          ----------------
////////////#:#//////////////          ----------------
////////////#:#//////////////          ----------------
////////////#:##/////////////          ----------------
////////////#X::#////////////          ----------------
////////////#:#X.////////////          ----------------
/////////////##:#////////////          ----------------
Normal mode start
Down=0, Left=0, Right=1, Up=0
Visited=1, junction=0
Entered new square
Normal mode end
Op mode: 0 Rot=0 MovF=1
Op mode: 0 Rot=0 MovF=1
Moving forward mode starts
travelledDist=3
curPos=(5,24) 
 Moving forward mode ends
Op mode: 0 Rot=0 MovF=0
Op mode: 0 Rot=0 MovF=0
Op mode: 0 Rot=0 MovF=0

41
cPos=(5,24)
cJ=7, JCon=8, lJDir=0, nJs=6, nJl=0
cDir=0, nDir=0
travelledDist=3
1: 1. 0: 0. 3: 3. 
/////////////////////////////          -3--------------
/////////////#///####////////          3-4-------------
////////////#:###::::#///////          -4-3------------
////////////#X::####:#///////          --3-3-----------
////////////#:#::X::X:##.////          ---3-5----------
////////////#:###.###X::O#///          ----5-3---------
////////////#X.//////.##.////          -----3-2--------
////////////#:#//////////////          ------2---------
////////////#:#//////////////          ----------------
////////////#X.//////////////          ----------------
////////////#:#//////////////          ----------------
////////////#:#//////////////          ----------------
////////////#:##/////////////          ----------------
////////////#X::#////////////          ----------------
////////////#:#X.////////////          ----------------
/////////////##:#////////////          ----------------
Normal mode start
Down=1, Left=0, Right=0, Up=1
Visited=1, junction=0
Entered new square
Has unex roads, UnexSQ=2
Array=0, j1=7, j2=8
1337
j1=7, j2=8, direction=0,Added right
j1=8, j2=7, direction=2,Added left
J#=7, right=8, up=6, left=0, down=0
J#=8, right=0, up=0, left=7, down=0
Normal mode end
Op mode: 0 Rot=1 MovF=1
Rotating mode starts
curDir=1 
 Rotating mode ends
Op mode: 0 Rot=0 MovF=1
Moving forward mode starts
travelledDist=1
curPos=(4,24) 
 Moving forward mode ends
Op mode: 0 Rot=0 MovF=0
Op mode: 0 Rot=0 MovF=0
Op mode: 0 Rot=0 MovF=0

42
cPos=(4,24)
cJ=8, JCon=9, lJDir=1, nJs=6, nJl=0
cDir=1, nDir=1
travelledDist=1
2: 2. 1: 1. 0: 0. 
/////////////////////////////          -3--------------
/////////////#///####////////          3-4-------------
////////////#:###::::#///////          -4-3------------
////////////#X::####:#//.////          --3-3-----------
////////////#:#::X::X:##O#///          ---3-5----------
////////////#:###.###X::X#///          ----5-3---------
////////////#X.//////.##.////          -----3-2--------
////////////#:#//////////////          ------2-3-------
////////////#:#//////////////          -------3--------
////////////#X.//////////////          ----------------
////////////#:#//////////////          ----------------
////////////#:#//////////////          ----------------
////////////#:##/////////////          ----------------
////////////#X::#////////////          ----------------
////////////#:#X.////////////          ----------------
/////////////##:#////////////          ----------------
Normal mode start
Down=1, Left=0, Right=0, Up=1
Visited=1, junction=0
Entered new square
Normal mode end
Op mode: 0 Rot=0 MovF=1
Op mode: 0 Rot=0 MovF=1
Moving forward mode starts
travelledDist=2
curPos=(3,24) 
 Moving forward mode ends
Op mode: 0 Rot=0 MovF=0
Op mode: 0 Rot=0 MovF=0
Op mode: 0 Rot=0 MovF=0

43
cPos=(3,24)
cJ=8, JCon=9, lJDir=1, nJs=6, nJl=0
cDir=1, nDir=1
travelledDist=2
2: 2. 1: 1. 0: 0. 
/////////////////////////////          -3--------------
/////////////#///####////////          3-4-------------
////////////#:###::::#//.////          -4-3------------
////////////#X::####:#/#O.///          --3-3-----------
////////////#:#::X::X:##:#///          ---3-5----------
////////////#:###.###X::X#///          ----5-3---------
////////////#X.//////.##.////          -----3-2--------
////////////#:#//////////////          ------2-3-------
////////////#:#//////////////          -------3--------
////////////#X.//////////////          ----------------
////////////#:#//////////////          ----------------
////////////#:#//////////////          ----------------
////////////#:##/////////////          ----------------
////////////#X::#////////////          ----------------
////////////#:#X.////////////          ----------------
/////////////##:#////////////          ----------------
Normal mode start
Down=0, Left=0, Right=1, Up=1
Visited=1, junction=0
Entered new square
Has unex roads, UnexSQ=2
Array=0, j1=8, j2=9
1337
j1=8, j2=9, direction=1,Added up
j1=9, j2=8, direction=3,Added down
J#=8, right=0, up=9, left=7, down=0
J#=9, right=0, up=0, left=0, down=8
Normal mode end
Op mode: 0 Rot=0 MovF=1
Op mode: 0 Rot=0 MovF=1
Moving forward mode starts
travelledDist=1
curPos=(2,24) 
 Moving forward mode ends
Op mode: 0 Rot=0 MovF=0
Op mode: 0 Rot=0 MovF=0
Op mode: 0 Rot=0 MovF=0

44
cPos=(2,24)
cJ=9, JCon=10, lJDir=1, nJs=6, nJl=0
cDir=1, nDir=1
travelledDist=1
2: 2. 1: 1. 0: 0. 
/////////////////////////////          -3--------------
/////////////#///####///#////          3-4-------------
////////////#:###::::#/.O#///          -4-3------------
////////////#X::####:#/#X.///          --3-3-----------
////////////#:#::X::X:##:#///          ---3-5----------
////////////#:###.###X::X#///          ----5-3---------
////////////#X.//////.##.////          -----3-2--------
////////////#:#//////////////          ------2-3-------
////////////#:#//////////////          -------3-2------
////////////#X.//////////////          --------2-------
////////////#:#//////////////          ----------------
////////////#:#//////////////          ----------------
////////////#:##/////////////          ----------------
////////////#X::#////////////          ----------------
////////////#:#X.////////////          ----------------
/////////////##:#////////////          ----------------
Normal mode start
Down=1, Left=1, Right=0, Up=0
Visited=1, junction=0
Entered new square
Normal mode end
Op mode: 0 Rot=1 MovF=1
Rotating mode starts
curDir=2 
 Rotating mode ends
Op mode: 0 Rot=0 MovF=1
Moving forward mode starts
travelledDist=2
curPos=(2,23) 
 Moving forward mode ends
Op mode: 0 Rot=0 MovF=0
Op mode: 0 Rot=0 MovF=0
Op mode: 0 Rot=0 MovF=0

45
cPos=(2,23)
cJ=9, JCon=10, lJDir=1, nJs=6, nJl=0
cDir=2, nDir=2
travelledDist=2
3: 3. 2: 2. 1: 1. 
/////////////////////////////          -3--------------
/////////////#///####//##////          3-4-------------
////////////#:###::::#.O:#///          -4-3------------
////////////#X::####:#/#X.///          --3-3-----------
////////////#:#::X::X:##:#///          ---3-5----------
////////////#:###.###X::X#///          ----5-3---------
////////////#X.//////.##.////          -----3-2--------
////////////#:#//////////////          ------2-3-------
////////////#:#//////////////          -------3-2------
////////////#X.//////////////          --------2-------
////////////#:#//////////////          ----------------
////////////#:#//////////////          ----------------
////////////#:##/////////////          ----------------
////////////#X::#////////////          ----------------
////////////#:#X.////////////          ----------------
/////////////##:#////////////          ----------------
Normal mode start
Down=0, Left=1, Right=0, Up=0
Visited=1, junction=0
Entered new square
Normal mode end
Op mode: 0 Rot=0 MovF=1
Op mode: 0 Rot=0 MovF=1
Moving forward mode starts
travelledDist=3
curPos=(2,22) 
 Moving forward mode ends
Op mode: 0 Rot=0 MovF=0
Op mode: 0 Rot=0 MovF=0
Op mode: 0 Rot=0 MovF=0

46
cPos=(2,22)
cJ=9, JCon=10, lJDir=1, nJs=6, nJl=0
cDir=2, nDir=2
travelledDist=3
3: 3. 2: 2. 1: 1. 
/////////////////////////////          -3--------------
/////////////#///####/###////          3-4-------------
////////////#:###::::#O::#///          -4-3------------
////////////#X::####:###X.///          --3-3-----------
////////////#:#::X::X:##:#///          ---3-5----------
////////////#:###.###X::X#///          ----5-3---------
////////////#X.//////.##.////          -----3-2--------
////////////#:#//////////////          ------2-3-------
////////////#:#//////////////          -------3-2------
////////////#X.//////////////          --------2-------
////////////#:#//////////////          ----------------
////////////#:#//////////////          ----------------
////////////#:##/////////////          ----------------
////////////#X::#////////////          ----------------
////////////#:#X.////////////          ----------------
/////////////##:#////////////          ----------------
Normal mode start
Down=0, Left=0, Right=0, Up=0
Visited=1, junction=0
Entered new square
Dead end, UnexSq=0
Rotating mode starts
curDir=0 
 Rotating mode ends
Op mode: 3 Rot=0 MovF=1
Moving forward mode starts
travelledDist=4
curPos=(2,23) 
 Moving forward mode ends
Op mode: 3 Rot=0 MovF=0
Go to junction mode starts
Down=0
Up=0
Go to junction mode ends
Op mode: 3 Rot=0 MovF=1
Op mode: 3 Rot=0 MovF=1

47
cPos=(2,23)
cJ=9, JCon=10, lJDir=1, nJs=9, nJl=0
cDir=0, nDir=0
travelledDist=4
1: 1. 0: 0. 3: 3. 
/////////////////////////////          -3--------------
/////////////#///####/###////          3-4-------------
////////////#:###::::#:O:#///          -4-3------------
////////////#X::####:###X.///          --3-3-----------
////////////#:#::X::X:##:#///          ---3-5----------
////////////#:###.###X::X#///          ----5-3---------
////////////#X.//////.##.////          -----3-2--------
////////////#:#//////////////          ------2-3-------
////////////#:#//////////////          -------3-2------
////////////#X.//////////////          --------2-------
////////////#:#//////////////          ----------------
////////////#:#//////////////          ----------------
////////////#:##/////////////          ----------------
////////////#X::#////////////          ----------------
////////////#:#X.////////////          ----------------
/////////////##:#////////////          ----------------
Op mode: 3 Rot=0 MovF=1
Op mode: 3 Rot=0 MovF=1
Moving forward mode starts
travelledDist=5
curPos=(2,24) 
 Moving forward mode ends
Op mode: 3 Rot=0 MovF=0
Go to junction mode starts
Down=1
ROT=-1
Go to junction mode ends
Op mode: 3 Rot=1 MovF=1
Op mode: 3 Rot=1 MovF=1

48
cPos=(2,24)
cJ=9, JCon=10, lJDir=1, nJs=9, nJl=0
cDir=0, nDir=3
travelledDist=5
1: 1. 0: 0. 3: 3. 
/////////////////////////////          -3--------------
/////////////#///####/###////          3-4-------------
////////////#:###::::#::O#///          -4-3------------
////////////#X::####:###X.///          --3-3-----------
////////////#:#::X::X:##:#///          ---3-5----------
////////////#:###.###X::X#///          ----5-3---------
////////////#X.//////.##.////          -----3-2--------
////////////#:#//////////////          ------2-3-------
////////////#:#//////////////          -------3-2------
////////////#X.//////////////          --------2-------
////////////#:#//////////////          ----------------
////////////#:#//////////////          ----------------
////////////#:##/////////////          ----------------
////////////#X::#////////////          ----------------
////////////#:#X.////////////          ----------------
/////////////##:#////////////          ----------------
Op mode: 3 Rot=1 MovF=1
Rotating mode starts
curDir=3 
 Rotating mode ends
Op mode: 3 Rot=0 MovF=1
Moving forward mode starts
travelledDist=6
curPos=(3,24) 
 Moving forward mode ends
Op mode: 3 Rot=0 MovF=0
Go to junction mode starts
Left=0
Right=1
ROT=1
curJ=nJs!!
Down=0, Left=0, Right=1, Up=0
Tester=1, UnexSq=1, 0=00, 1=00, 2=00, 3=00
UnexSq exist!!
Go to junction mode ends
Op mode: 0 Rot=0 MovF=0
Op mode: 0 Rot=0 MovF=0

49
cPos=(3,24)
cJ=9, JCon=10, lJDir=1, nJs=9, nJl=0
cDir=3, nDir=0
travelledDist=0
0: 0. 3: 3. 2: 2. 
/////////////////////////////          -3--------------
/////////////#///####/###////          3-4-------------
////////////#:###::::#:::#///          -4-3------------
////////////#X::####:###O.///          --3-3-----------
////////////#:#::X::X:##:#///          ---3-5----------
////////////#:###.###X::X#///          ----5-3---------
////////////#X.//////.##.////          -----3-2--------
////////////#:#//////////////          ------2-3-------
////////////#:#//////////////          -------3-2------
////////////#X.//////////////          --------2-------
////////////#:#//////////////          ----------------
////////////#:#//////////////          ----------------
////////////#:##/////////////          ----------------
////////////#X::#////////////          ----------------
////////////#:#X.////////////          ----------------
/////////////##:#////////////          ----------------
Normal mode start
Down=0, Left=0, Right=1, Up=0
Visited=1, junction=1
Entered visited junction
Array=0, j1=9, j2=9
Array=0, j1=9, j2=9
J#=9, right=0, up=0, left=0, down=8
J#=9, right=0, up=0, left=0, down=8
Sent dir=1
Tester=1, UnexSq=1, 0=00, 1=00, 2=00, 3=00
Has UnexSQ=1
Normal mode end
Op mode: 0 Rot=1 MovF=1
Rotating mode starts
curDir=0 
 Rotating mode ends
Op mode: 0 Rot=0 MovF=1
Moving forward mode starts
travelledDist=1
curPos=(3,25) 
 Moving forward mode ends
Op mode: 0 Rot=0 MovF=0
Op mode: 0 Rot=0 MovF=0
Op mode: 0 Rot=0 MovF=0

50
cPos=(3,25)
cJ=9, JCon=10, lJDir=0, nJs=9, nJl=0
cDir=0, nDir=0
travelledDist=1
1: 1. 0: 0. 3: 3. 
/////////////////////////////          -3--------------
/////////////#///####/###////          3-4-------------
////////////#:###::::#:::#///          -4-3------------
////////////#X::####:###XO#//          --3-3-----------
////////////#:#::X::X:##:#///          ---3-5----------
////////////#:###.###X::X#///          ----5-3---------
////////////#X.//////.##.////          -----3-2--------
////////////#:#//////////////          ------2-3-------
////////////#:#//////////////          -------3-2------
////////////#X.//////////////          --------2-------
////////////#:#//////////////          ----------------
////////////#:#//////////////          ----------------
////////////#:##/////////////          ----------------
////////////#X::#////////////          ----------------
////////////#:#X.////////////          ----------------
/////////////##:#////////////          ----------------
Normal mode start
Down=0, Left=1, Right=0, Up=0
Visited=1, junction=0
Entered new square
Normal mode end
Op mode: 0 Rot=1 MovF=1
Rotating mode starts
curDir=2 
 Rotating mode ends
Op mode: 0 Rot=0 MovF=1
Moving forward mode starts
travelledDist=2
curPos=(3,24) 
 Moving forward mode ends
Op mode: 0 Rot=0 MovF=0
Op mode: 0 Rot=0 MovF=0
Op mode: 0 Rot=0 MovF=0

51
cPos=(3,24)
cJ=9, JCon=10, lJDir=0, nJs=9, nJl=0
cDir=2, nDir=2
travelledDist=2
3: 3. 2: 2. 1: 1. 
/////////////////////////////          -3--------------
/////////////#///####/###////          3-4-------------
////////////#:###::::#:::#///          -4-3------------
////////////#X::####:###O:#//          --3-3-----------
////////////#:#::X::X:##:#///          ---3-5----------
////////////#:###.###X::X#///          ----5-3---------
////////////#X.//////.##.////          -----3-2--------
////////////#:#//////////////          ------2-3-------
////////////#:#//////////////          -------3-2------
////////////#X.//////////////          --------2-------
////////////#:#//////////////          ----------------
////////////#:#//////////////          ----------------
////////////#:##/////////////          ----------------
////////////#X::#////////////          ----------------
////////////#:#X.////////////          ----------------
/////////////##:#////////////          ----------------
Normal mode start
Down=0, Left=0, Right=0, Up=0
Visited=1, junction=1
Entered visited junction
Array=0, j1=9, j2=9
Array=0, j1=9, j2=9
J#=9, right=0, up=0, left=0, down=8
J#=9, right=0, up=0, left=0, down=8
Sent dir=0
Tester=0, UnexSq=0, 0=00, 1=00, 2=00, 3=00
Fully explored junction
WTF CurJunction = 9
 10 9
Decided nJl=8
Op mode: 2 Rot=0 MovF=0
Op mode: 2 Rot=0 MovF=0
Op mode: 2 Rot=0 MovF=0
Far junction mode starts
Destination decided, nJl=8
Åk mot nJs
nDir=1, cJ=9, nJs=8
nDir=3, cJ=9, nJs=8
Far junction mode ends
Op mode: 3 Rot=1 MovF=1

52
cPos=(3,24)
cJ=9, JCon=10, lJDir=0, nJs=8, nJl=8
cDir=2, nDir=3
travelledDist=0
3: 3. 2: 2. 1: 1. 
/////////////////////////////          -3--------------
/////////////#///####/###////          3-4-------------
////////////#:###::::#:::#///          -4-3------------
////////////#X::####:###O:#//          --3-3-----------
////////////#:#::X::X:##:#///          ---3-5----------
////////////#:###.###X::X#///          ----5-3---------
////////////#X.//////.##.////          -----3-2--------
////////////#:#//////////////          ------2-3-------
////////////#:#//////////////          -------3-2------
////////////#X.//////////////          --------2-------
////////////#:#//////////////          ----------------
////////////#:#//////////////          ----------------
////////////#:##/////////////          ----------------
////////////#X::#////////////          ----------------
////////////#:#X.////////////          ----------------
/////////////##:#////////////          ----------------
Op mode: 3 Rot=1 MovF=1
Rotating mode starts
curDir=3 
 Rotating mode ends
Op mode: 3 Rot=0 MovF=1
Moving forward mode starts
travelledDist=1
curPos=(4,24) 
 Moving forward mode ends
Op mode: 3 Rot=0 MovF=0
Go to junction mode starts
Left=0
Right=0
Go to junction mode ends
Op mode: 3 Rot=0 MovF=1
Op mode: 3 Rot=0 MovF=1

53
cPos=(4,24)
cJ=9, JCon=10, lJDir=3, nJs=8, nJl=8
cDir=3, nDir=3
travelledDist=1
0: 0. 3: 3. 2: 2. 
/////////////////////////////          -3--------------
/////////////#///####/###////          3-4-------------
////////////#:###::::#:::#///          -4-3------------
////////////#X::####:###X:#//          --3-3-----------
////////////#:#::X::X:##O#///          ---3-5----------
////////////#:###.###X::X#///          ----5-3---------
////////////#X.//////.##.////          -----3-2--------
////////////#:#//////////////          ------2-3-------
////////////#:#//////////////          -------3-2------
////////////#X.//////////////          --------2-------
////////////#:#//////////////          ----------------
////////////#:#//////////////          ----------------
////////////#:##/////////////          ----------------
////////////#X::#////////////          ----------------
////////////#:#X.////////////          ----------------
/////////////##:#////////////          ----------------
Op mode: 3 Rot=0 MovF=1
Op mode: 3 Rot=0 MovF=1
Moving forward mode starts
travelledDist=2
curPos=(5,24) 
 Moving forward mode ends
Op mode: 3 Rot=0 MovF=0
Go to junction mode starts
Left=1
ROT=-1
curJ=nJs!!
Down=1, Left=0, Right=0, Up=0
Tester=1, UnexSq=1, 0=00, 1=00, 2=00, 3=00
UnexSq exist!!
Go to junction mode ends
Op mode: 0 Rot=0 MovF=0
Op mode: 0 Rot=0 MovF=0

54
cPos=(5,24)
cJ=8, JCon=10, lJDir=3, nJs=8, nJl=8
cDir=3, nDir=3
travelledDist=0
0: 0. 3: 3. 2: 2. 
/////////////////////////////          -3--------------
/////////////#///####/###////          3-4-------------
////////////#:###::::#:::#///          -4-3------------
////////////#X::####:###X:#//          --3-3-----------
////////////#:#::X::X:##:#///          ---3-5----------
////////////#:###.###X::O#///          ----5-3---------
////////////#X.//////.##.////          -----3-2--------
////////////#:#//////////////          ------2-3-------
////////////#:#//////////////          -------3-2------
////////////#X.//////////////          --------2-------
////////////#:#//////////////          ----------------
////////////#:#//////////////          ----------------
////////////#:##/////////////          ----------------
////////////#X::#////////////          ----------------
////////////#:#X.////////////          ----------------
/////////////##:#////////////          ----------------
Normal mode start
Down=1, Left=0, Right=0, Up=0
Visited=1, junction=1
Entered visited junction
Array=0, j1=8, j2=8
Array=0, j1=8, j2=8
J#=8, right=0, up=9, left=7, down=0
J#=8, right=0, up=9, left=7, down=0
Sent dir=1
Tester=1, UnexSq=1, 0=00, 1=00, 2=00, 3=00
Has UnexSQ=1
Normal mode end
Op mode: 0 Rot=0 MovF=1
Op mode: 0 Rot=0 MovF=1
Moving forward mode starts
travelledDist=1
curPos=(6,24) 
 Moving forward mode ends
Op mode: 0 Rot=0 MovF=0
Op mode: 0 Rot=0 MovF=0
Op mode: 0 Rot=0 MovF=0

55
cPos=(6,24)
cJ=8, JCon=10, lJDir=3, nJs=8, nJl=8
cDir=3, nDir=3
travelledDist=1
0: 0. 3: 3. 2: 2. 
/////////////////////////////          -3--------------
/////////////#///####/###////          3-4-------------
////////////#:###::::#:::#///          -4-3------------
////////////#X::####:###X:#//          --3-3-----------
////////////#:#::X::X:##:#///          ---3-5----------
////////////#:###.###X::X#///          ----5-3---------
////////////#X.//////.##O#///          -----3-2--------
////////////#:#/////////#////          ------2-3-------
////////////#:#//////////////          -------3-2------
////////////#X.//////////////          --------2-------
////////////#:#//////////////          ----------------
////////////#:#//////////////          ----------------
////////////#:##/////////////          ----------------
////////////#X::#////////////          ----------------
////////////#:#X.////////////          ----------------
/////////////##:#////////////          ----------------
Normal mode start
Down=0, Left=0, Right=0, Up=1
Visited=1, junction=0
Entered new square
Normal mode end
Op mode: 0 Rot=1 MovF=1
Rotating mode starts
curDir=1 
 Rotating mode ends
Op mode: 0 Rot=0 MovF=1
Moving forward mode starts
travelledDist=2
curPos=(5,24) 
 Moving forward mode ends
Op mode: 0 Rot=0 MovF=0
Op mode: 0 Rot=0 MovF=0
Op mode: 0 Rot=0 MovF=0

56
cPos=(5,24)
cJ=8, JCon=10, lJDir=3, nJs=8, nJl=8
cDir=1, nDir=1
travelledDist=2
2: 2. 1: 1. 0: 0. 
/////////////////////////////          -3--------------
/////////////#///####/###////          3-4-------------
////////////#:###::::#:::#///          -4-3------------
////////////#X::####:###X:#//          --3-3-----------
////////////#:#::X::X:##:#///          ---3-5----------
////////////#:###.###X::O#///          ----5-3---------
////////////#X.//////.##:#///          -----3-2--------
////////////#:#/////////#////          ------2-3-------
////////////#:#//////////////          -------3-2------
////////////#X.//////////////          --------2-------
////////////#:#//////////////          ----------------
////////////#:#//////////////          ----------------
////////////#:##/////////////          ----------------
////////////#X::#////////////          ----------------
////////////#:#X.////////////          ----------------
/////////////##:#////////////          ----------------
Normal mode start
Down=0, Left=0, Right=0, Up=0
Visited=1, junction=1
Entered visited junction
Array=0, j1=8, j2=8
Array=0, j1=8, j2=8
J#=8, right=0, up=9, left=7, down=0
J#=8, right=0, up=9, left=7, down=0
Sent dir=3
Tester=0, UnexSq=0, 0=00, 1=00, 2=00, 3=00
Fully explored junction
WTF CurJunction = 8
 10 9 8
Decided nJl=7
Op mode: 2 Rot=0 MovF=0
Op mode: 2 Rot=0 MovF=0
Op mode: 2 Rot=0 MovF=0
Far junction mode starts
Destination decided, nJl=7
Åk mot nJs
nDir=1, cJ=8, nJs=7
nDir=2, cJ=8, nJs=7
Far junction mode ends
Op mode: 3 Rot=1 MovF=1

57
cPos=(5,24)
cJ=8, JCon=10, lJDir=3, nJs=7, nJl=7
cDir=1, nDir=2
travelledDist=0
2: 2. 1: 1. 0: 0. 
/////////////////////////////          -3--------------
/////////////#///####/###////          3-4-------------
////////////#:###::::#:::#///          -4-3------------
////////////#X::####:###X:#//          --3-3-----------
////////////#:#::X::X:##:#///          ---3-5----------
////////////#:###.###X::O#///          ----5-3---------
////////////#X.//////.##:#///          -----3-2--------
////////////#:#/////////#////          ------2-3-------
////////////#:#//////////////          -------3-2------
////////////#X.//////////////          --------2-------
////////////#:#//////////////          ----------------
////////////#:#//////////////          ----------------
////////////#:##/////////////          ----------------
////////////#X::#////////////          ----------------
////////////#:#X.////////////          ----------------
/////////////##:#////////////          ----------------
Op mode: 3 Rot=1 MovF=1
Rotating mode starts
curDir=2 
 Rotating mode ends
Op mode: 3 Rot=0 MovF=1
Moving forward mode starts
travelledDist=1
curPos=(5,23) 
 Moving forward mode ends
Op mode: 3 Rot=0 MovF=0
Go to junction mode starts
Up=0
Down=0
Go to junction mode ends
Op mode: 3 Rot=0 MovF=1
Op mode: 3 Rot=0 MovF=1

58
cPos=(5,23)
cJ=8, JCon=10, lJDir=2, nJs=7, nJl=7
cDir=2, nDir=2
travelledDist=1
3: 3. 2: 2. 1: 1. 
/////////////////////////////          -3--------------
/////////////#///####/###////          3-4-------------
////////////#:###::::#:::#///          -4-3------------
////////////#X::####:###X:#//          --3-3-----------
////////////#:#::X::X:##:#///          ---3-5----------
////////////#:###.###X:OX#///          ----5-3---------
////////////#X.//////.##:#///          -----3-2--------
////////////#:#/////////#////          ------2-3-------
////////////#:#//////////////          -------3-2------
////////////#X.//////////////          --------2-------
////////////#:#//////////////          ----------------
////////////#:#//////////////          ----------------
////////////#:##/////////////          ----------------
////////////#X::#////////////          ----------------
////////////#:#X.////////////          ----------------
/////////////##:#////////////          ----------------
Op mode: 3 Rot=0 MovF=1
Op mode: 3 Rot=0 MovF=1
Moving forward mode starts
travelledDist=2
curPos=(5,22) 
 Moving forward mode ends
Op mode: 3 Rot=0 MovF=0
Go to junction mode starts
Up=0
Down=0
Go to junction mode ends
Op mode: 3 Rot=0 MovF=1
Op mode: 3 Rot=0 MovF=1

59
cPos=(5,22)
cJ=8, JCon=10, lJDir=2, nJs=7, nJl=7
cDir=2, nDir=2
travelledDist=2
3: 3. 2: 2. 1: 1. 
/////////////////////////////          -3--------------
/////////////#///####/###////          3-4-------------
////////////#:###::::#:::#///          -4-3------------
////////////#X::####:###X:#//          --3-3-----------
////////////#:#::X::X:##:#///          ---3-5----------
////////////#:###.###XO:X#///          ----5-3---------
////////////#X.//////.##:#///          -----3-2--------
////////////#:#/////////#////          ------2-3-------
////////////#:#//////////////          -------3-2------
////////////#X.//////////////          --------2-------
////////////#:#//////////////          ----------------
////////////#:#//////////////          ----------------
////////////#:##/////////////          ----------------
////////////#X::#////////////          ----------------
////////////#:#X.////////////          ----------------
/////////////##:#////////////          ----------------
Op mode: 3 Rot=0 MovF=1
Op mode: 3 Rot=0 MovF=1
Moving forward mode starts
travelledDist=3
curPos=(5,21) 
 Moving forward mode ends
Op mode: 3 Rot=0 MovF=0
Go to junction mode starts
Up=1
ROT=-1
curJ=nJs!!
Down=1, Left=0, Right=0, Up=0
Tester=1, UnexSq=1, 0=00, 1=00, 2=00, 3=00
UnexSq exist!!
Go to junction mode ends
Op mode: 0 Rot=0 MovF=0
Op mode: 0 Rot=0 MovF=0

60
cPos=(5,21)
cJ=7, JCon=10, lJDir=2, nJs=7, nJl=7
cDir=2, nDir=3
travelledDist=0
3: 3. 2: 2. 1: 1. 
/////////////////////////////          -3--------------
/////////////#///####/###////          3-4-------------
////////////#:###::::#:::#///          -4-3------------
////////////#X::####:###X:#//          --3-3-----------
////////////#:#::X::X:##:#///          ---3-5----------
////////////#:###.###O::X#///          ----5-3---------
////////////#X.//////.##:#///          -----3-2--------
////////////#:#/////////#////          ------2-3-------
////////////#:#//////////////          -------3-2------
////////////#X.//////////////          --------2-------
////////////#:#//////////////          ----------------
////////////#:#//////////////          ----------------
////////////#:##/////////////          ----------------
////////////#X::#////////////          ----------------
////////////#:#X.////////////          ----------------
/////////////##:#////////////          ----------------
Normal mode start
Down=1, Left=0, Right=0, Up=0
Visited=1, junction=1
Entered visited junction
Array=0, j1=7, j2=7
Array=0, j1=7, j2=7
J#=7, right=8, up=6, left=0, down=0
J#=7, right=8, up=6, left=0, down=0
Sent dir=0
Tester=1, UnexSq=1, 0=00, 1=00, 2=00, 3=00
Has UnexSQ=1
Normal mode end
Op mode: 0 Rot=1 MovF=1
Rotating mode starts
curDir=3 
 Rotating mode ends
Op mode: 0 Rot=0 MovF=1
Moving forward mode starts
travelledDist=1
curPos=(6,21) 
 Moving forward mode ends
Op mode: 0 Rot=0 MovF=0
Op mode: 0 Rot=0 MovF=0
Op mode: 0 Rot=0 MovF=0

61
cPos=(6,21)
cJ=7, JCon=10, lJDir=3, nJs=7, nJl=7
cDir=3, nDir=3
travelledDist=1
0: 0. 3: 3. 2: 2. 
/////////////////////////////          -3--------------
/////////////#///####/###////          3-4-------------
////////////#:###::::#:::#///          -4-3------------
////////////#X::####:###X:#//          --3-3-----------
////////////#:#::X::X:##:#///          ---3-5----------
////////////#:###.###X::X#///          ----5-3---------
////////////#X./////#O##:#///          -----3-2--------
////////////#:#//////.//#////          ------2-3-------
////////////#:#//////////////          -------3-2------
////////////#X.//////////////          --------2-------
////////////#:#//////////////          ----------------
////////////#:#//////////////          ----------------
////////////#:##/////////////          ----------------
////////////#X::#////////////          ----------------
////////////#:#X.////////////          ----------------
/////////////##:#////////////          ----------------
Normal mode start
Down=1, Left=0, Right=0, Up=1
Visited=1, junction=0
Entered new square
Normal mode end
Op mode: 0 Rot=0 MovF=1
Op mode: 0 Rot=0 MovF=1
Moving forward mode starts
travelledDist=2
curPos=(7,21) 
 Moving forward mode ends
Op mode: 0 Rot=0 MovF=0
Op mode: 0 Rot=0 MovF=0
Op mode: 0 Rot=0 MovF=0

62
cPos=(7,21)
cJ=7, JCon=10, lJDir=3, nJs=7, nJl=7
cDir=3, nDir=3
travelledDist=2
0: 0. 3: 3. 2: 2. 
/////////////////////////////          -3--------------
/////////////#///####/###////          3-4-------------
////////////#:###::::#:::#///          -4-3------------
////////////#X::####:###X:#//          --3-3-----------
////////////#:#::X::X:##:#///          ---3-5----------
////////////#:###.###X::X#///          ----5-3---------
////////////#X./////#:##:#///          -----3-2--------
////////////#:#/////.O#/#////          ------2-3-------
////////////#:#//////.///////          -------3-2------
////////////#X.//////////////          --------2-------
////////////#:#//////////////          ----------------
////////////#:#//////////////          ----------------
////////////#:##/////////////          ----------------
////////////#X::#////////////          ----------------
////////////#:#X.////////////          ----------------
/////////////##:#////////////          ----------------
Normal mode start
Down=1, Left=1, Right=0, Up=0
Visited=1, junction=0
Entered new square
Has unex roads, UnexSQ=2
Array=0, j1=7, j2=10
1337
j1=7, j2=10, direction=3,Added down
j1=10, j2=7, direction=1,Added up
J#=7, right=8, up=6, left=0, down=10
J#=10, right=0, up=7, left=0, down=0
Normal mode end
Op mode: 0 Rot=0 MovF=1
Op mode: 0 Rot=0 MovF=1
Moving forward mode starts
travelledDist=1
curPos=(8,21) 
 Moving forward mode ends
Op mode: 0 Rot=0 MovF=0
Op mode: 0 Rot=0 MovF=0
Op mode: 0 Rot=0 MovF=0

63
cPos=(8,21)
cJ=10, JCon=11, lJDir=3, nJs=7, nJl=7
cDir=3, nDir=3
travelledDist=1
0: 0. 3: 3. 2: 2. 
/////////////////////////////          -3--------------
/////////////#///####/###////          3-4-------------
////////////#:###::::#:::#///          -4-3------------
////////////#X::####:###X:#//          --3-3-----------
////////////#:#::X::X:##:#///          ---3-5----------
////////////#:###.###X::X#///          ----5-3---------
////////////#X./////#:##:#///          -----3-2--------
////////////#:#/////.X#/#////          ------2-3-2-----
////////////#:#/////#O.//////          -------3-2------
////////////#X.//////#///////          --------2-------
////////////#:#//////////////          -------2--------
////////////#:#//////////////          ----------------
////////////#:##/////////////          ----------------
////////////#X::#////////////          ----------------
////////////#:#X.////////////          ----------------
/////////////##:#////////////          ----------------
Normal mode start
Down=0, Left=0, Right=1, Up=1
Visited=1, junction=0
Entered new square
Normal mode end
Op mode: 0 Rot=1 MovF=1
Rotating mode starts
curDir=0 
 Rotating mode ends
Op mode: 0 Rot=0 MovF=1
Moving forward mode starts
travelledDist=2
curPos=(8,22) 
 Moving forward mode ends
Op mode: 0 Rot=0 MovF=0
Op mode: 0 Rot=0 MovF=0
Op mode: 0 Rot=0 MovF=0

64
cPos=(8,22)
cJ=10, JCon=11, lJDir=3, nJs=7, nJl=7
cDir=0, nDir=0
travelledDist=2
1: 1. 0: 0. 3: 3. 
/////////////////////////////          -3--------------
/////////////#///####/###////          3-4-------------
////////////#:###::::#:::#///          -4-3------------
////////////#X::####:###X:#//          --3-3-----------
////////////#:#::X::X:##:#///          ---3-5----------
////////////#:###.###X::X#///          ----5-3---------
////////////#X./////#:##:#///          -----3-2--------
////////////#:#/////.X#/#////          ------2-3-2-----
////////////#:#/////#:O./////          -------3-2------
////////////#X.//////##//////          --------2-------
////////////#:#//////////////          -------2--------
////////////#:#//////////////          ----------------
////////////#:##/////////////          ----------------
////////////#X::#////////////          ----------------
////////////#:#X.////////////          ----------------
/////////////##:#////////////          ----------------
Normal mode start
Down=0, Left=0, Right=1, Up=0
Visited=1, junction=0
Entered new square
Normal mode end
Op mode: 0 Rot=0 MovF=1
Op mode: 0 Rot=0 MovF=1
Moving forward mode starts
travelledDist=3
curPos=(8,23) 
 Moving forward mode ends
Op mode: 0 Rot=0 MovF=0
Op mode: 0 Rot=0 MovF=0
Op mode: 0 Rot=0 MovF=0

65
cPos=(8,23)
cJ=10, JCon=11, lJDir=3, nJs=7, nJl=7
cDir=0, nDir=0
travelledDist=3
1: 1. 0: 0. 3: 3. 
/////////////////////////////          -3--------------
/////////////#///####/###////          3-4-------------
////////////#:###::::#:::#///          -4-3------------
////////////#X::####:###X:#//          --3-3-----------
////////////#:#::X::X:##:#///          ---3-5----------
////////////#:###.###X::X#///          ----5-3---------
////////////#X./////#:##:#///          -----3-2--------
////////////#:#/////.X###////          ------2-3-2-----
////////////#:#/////#::O.////          -------3-2------
////////////#X.//////##./////          --------2-------
////////////#:#//////////////          -------2--------
////////////#:#//////////////          ----------------
////////////#:##/////////////          ----------------
////////////#X::#////////////          ----------------
////////////#:#X.////////////          ----------------
/////////////##:#////////////          ----------------
Normal mode start
Down=1, Left=0, Right=1, Up=0
Visited=1, junction=0
Entered new square
Has unex roads, UnexSQ=2
Array=0, j1=10, j2=11
1337
j1=10, j2=11, direction=3,Added down
j1=11, j2=10, direction=2,Added left
J#=10, right=0, up=7, left=0, down=11
J#=11, right=0, up=0, left=10, down=0
Normal mode end
Op mode: 0 Rot=0 MovF=1
Op mode: 0 Rot=0 MovF=1
Moving forward mode starts
travelledDist=1
curPos=(8,24) 
 Moving forward mode ends
Op mode: 0 Rot=0 MovF=0
Op mode: 0 Rot=0 MovF=0
Op mode: 0 Rot=0 MovF=0

66
cPos=(8,24)
cJ=11, JCon=12, lJDir=0, nJs=7, nJl=7
cDir=0, nDir=0
travelledDist=1
1: 1. 0: 0. 3: 3. 
/////////////////////////////          -3--------------
/////////////#///####/###////          3-4-------------
////////////#:###::::#:::#///          -4-3------------
////////////#X::####:###X:#//          --3-3-----------
////////////#:#::X::X:##:#///          ---3-5----------
////////////#:###.###X::X#///          ----5-3---------
////////////#X./////#:##:#///          -----3-2--------
////////////#:#/////.X###////          ------2-3-2-----
////////////#:#/////#::XO.///          -------3-2------
////////////#X.//////##.#////          --------2-------
////////////#:#//////////////          -------2---3----
////////////#:#//////////////          ----------3-----
////////////#:##/////////////          ----------------
////////////#X::#////////////          ----------------
////////////#:#X.////////////          ----------------
/////////////##:#////////////          ----------------
Normal mode start
Down=0, Left=1, Right=1, Up=0
Visited=1, junction=0
Entered new square
Normal mode end
Op mode: 0 Rot=0 MovF=1
Op mode: 0 Rot=0 MovF=1
Moving forward mode starts
travelledDist=2
curPos=(8,25) 
 Moving forward mode ends
Op mode: 0 Rot=0 MovF=0
Op mode: 0 Rot=0 MovF=0
Op mode: 0 Rot=0 MovF=0

67
cPos=(8,25)
cJ=11, JCon=12, lJDir=0, nJs=7, nJl=7
cDir=0, nDir=0
travelledDist=2
1: 1. 0: 0. 3: 3. 
/////////////////////////////          -3--------------
/////////////#///####/###////          3-4-------------
////////////#:###::::#:::#///          -4-3------------
////////////#X::####:###X:#//          --3-3-----------
////////////#:#::X::X:##:#///          ---3-5----------
////////////#:###.###X::X#///          ----5-3---------
////////////#X./////#:##:#///          -----3-2--------
////////////#:#/////.X####///          ------2-3-2-----
////////////#:#/////#::X:O#//          -------3-2------
////////////#X.//////##.#.///          --------2-------
////////////#:#//////////////          -------2---3----
////////////#:#//////////////          ----------3-----
////////////#:##/////////////          ----------------
////////////#X::#////////////          ----------------
////////////#:#X.////////////          ----------------
/////////////##:#////////////          ----------------
Normal mode start
Down=1, Left=0, Right=0, Up=0
Visited=1, junction=0
Entered new square
Normal mode end
Op mode: 0 Rot=1 MovF=1
Rotating mode starts
curDir=3 
 Rotating mode ends
Op mode: 0 Rot=0 MovF=1
Moving forward mode starts
travelledDist=3
curPos=(9,25) 
 Moving forward mode ends
Op mode: 0 Rot=0 MovF=0
Op mode: 0 Rot=0 MovF=0
Op mode: 0 Rot=0 MovF=0

68
cPos=(9,25)
cJ=11, JCon=12, lJDir=0, nJs=7, nJl=7
cDir=3, nDir=3
travelledDist=3
0: 0. 3: 3. 2: 2. 
/////////////////////////////          -3--------------
/////////////#///####/###////          3-4-------------
////////////#:###::::#:::#///          -4-3------------
////////////#X::####:###X:#//          --3-3-----------
////////////#:#::X::X:##:#///          ---3-5----------
////////////#:###.###X::X#///          ----5-3---------
////////////#X./////#:##:#///          -----3-2--------
////////////#:#/////.X####///          ------2-3-2-----
////////////#:#/////#::X::#//          -------3-2------
////////////#X.//////##.#O#//          --------2-------
////////////#:#//////////.///          -------2---3----
////////////#:#//////////////          ----------3-----
////////////#:##/////////////          ----------------
////////////#X::#////////////          ----------------
////////////#:#X.////////////          ----------------
/////////////##:#////////////          ----------------
Normal mode start
Down=1, Left=0, Right=0, Up=0
Visited=1, junction=0
Entered new square
Normal mode end
Op mode: 0 Rot=0 MovF=1
Op mode: 0 Rot=0 MovF=1
Moving forward mode starts
travelledDist=4
curPos=(10,25) 
 Moving forward mode ends
Op mode: 0 Rot=0 MovF=0
Op mode: 0 Rot=0 MovF=0
Op mode: 0 Rot=0 MovF=0

69
cPos=(10,25)
cJ=11, JCon=12, lJDir=0, nJs=7, nJl=7
cDir=3, nDir=3
travelledDist=4
0: 0. 3: 3. 2: 2. 
/////////////////////////////          -3--------------
/////////////#///####/###////          3-4-------------
////////////#:###::::#:::#///          -4-3------------
////////////#X::####:###X:#//          --3-3-----------
////////////#:#::X::X:##:#///          ---3-5----------
////////////#:###.###X::X#///          ----5-3---------
////////////#X./////#:##:#///          -----3-2--------
////////////#:#/////.X####///          ------2-3-2-----
////////////#:#/////#::X::#//          -------3-2------
////////////#X.//////##.#:#//          --------2-------
////////////#:#/////////#O#//          -------2---3----
////////////#:#//////////.///          ----------3-----
////////////#:##/////////////          ----------------
////////////#X::#////////////          ----------------
////////////#:#X.////////////          ----------------
/////////////##:#////////////          ----------------
Normal mode start
Down=1, Left=0, Right=0, Up=0
Visited=1, junction=0
Entered new square
Normal mode end
Op mode: 0 Rot=0 MovF=1
Op mode: 0 Rot=0 MovF=1
Moving forward mode starts
travelledDist=5
curPos=(11,25) 
 Moving forward mode ends
Op mode: 0 Rot=0 MovF=0
Op mode: 0 Rot=0 MovF=0
Op mode: 0 Rot=0 MovF=0

70
cPos=(11,25)
cJ=11, JCon=12, lJDir=0, nJs=7, nJl=7
cDir=3, nDir=3
travelledDist=5
0: 0. 3: 3. 2: 2. 
/////////////////////////////          -3--------------
/////////////#///####/###////          3-4-------------
////////////#:###::::#:::#///          -4-3------------
////////////#X::####:###X:#//          --3-3-----------
////////////#:#::X::X:##:#///          ---3-5----------
////////////#:###.###X::X#///          ----5-3---------
////////////#X./////#:##:#///          -----3-2--------
////////////#:#/////.X####///          ------2-3-2-----
////////////#:#/////#::X::#//          -------3-2------
////////////#X.//////##.#:#//          --------2-------
////////////#:#/////////#:#//          -------2---3----
////////////#:#/////////#O#//          ----------3-----
////////////#:##/////////.///          ----------------
////////////#X::#////////////          ----------------
////////////#:#X.////////////          ----------------
/////////////##:#////////////          ----------------
Normal mode start
Down=1, Left=0, Right=0, Up=0
Visited=1, junction=0
Entered new square
Normal mode end
Op mode: 0 Rot=0 MovF=1
Op mode: 0 Rot=0 MovF=1
Moving forward mode starts
travelledDist=6
curPos=(12,25) 
 Moving forward mode ends
Op mode: 0 Rot=0 MovF=0
Op mode: 0 Rot=0 MovF=0
Op mode: 0 Rot=0 MovF=0

71
cPos=(12,25)
cJ=11, JCon=12, lJDir=0, nJs=7, nJl=7
cDir=3, nDir=3
travelledDist=6
0: 0. 3: 3. 2: 2. 
/////////////////////////////          -3--------------
/////////////#///####/###////          3-4-------------
////////////#:###::::#:::#///          -4-3------------
////////////#X::####:###X:#//          --3-3-----------
////////////#:#::X::X:##:#///          ---3-5----------
////////////#:###.###X::X#///          ----5-3---------
////////////#X./////#:##:#///          -----3-2--------
////////////#:#/////.X####///          ------2-3-2-----
////////////#:#/////#::X::#//          -------3-2------
////////////#X.//////##.#:#//          --------2-------
////////////#:#/////////#:#//          -------2---3----
////////////#:#/////////#:#//          ----------3-----
////////////#:##////////#O#//          ----------------
////////////#X::#////////.///          ----------------
////////////#:#X.////////////          ----------------
/////////////##:#////////////          ----------------
Normal mode start
Down=1, Left=0, Right=0, Up=0
Visited=1, junction=0
Entered new square
Normal mode end
Op mode: 0 Rot=0 MovF=1
Op mode: 0 Rot=0 MovF=1
Moving forward mode starts
travelledDist=7
curPos=(13,25) 
 Moving forward mode ends
Op mode: 0 Rot=0 MovF=0
Op mode: 0 Rot=0 MovF=0
Op mode: 0 Rot=0 MovF=0

72
cPos=(13,25)
cJ=11, JCon=12, lJDir=0, nJs=7, nJl=7
cDir=3, nDir=3
travelledDist=7
0: 0. 3: 3. 2: 2. 
/////////////////////////////          -3--------------
/////////////#///####/###////          3-4-------------
////////////#:###::::#:::#///          -4-3------------
////////////#X::####:###X:#//          --3-3-----------
////////////#:#::X::X:##:#///          ---3-5----------
////////////#:###.###X::X#///          ----5-3---------
////////////#X./////#:##:#///          -----3-2--------
////////////#:#/////.X####///          ------2-3-2-----
////////////#:#/////#::X::#//          -------3-2------
////////////#X.//////##.#:#//          --------2-------
////////////#:#/////////#:#//          -------2---3----
////////////#:#/////////#:#//          ----------3-----
////////////#:##////////#:#//          ----------------
////////////#X::#///////#O#//          ----------------
////////////#:#X.////////.///          ----------------
/////////////##:#////////////          ----------------
Normal mode start
Down=1, Left=0, Right=0, Up=0
Visited=1, junction=0
Entered new square
Normal mode end
Op mode: 0 Rot=0 MovF=1
Op mode: 0 Rot=0 MovF=1
Moving forward mode starts
travelledDist=8
curPos=(14,25) 
 Moving forward mode ends
Op mode: 0 Rot=0 MovF=0
Op mode: 0 Rot=0 MovF=0
Op mode: 0 Rot=0 MovF=0

73
cPos=(14,25)
cJ=11, JCon=12, lJDir=0, nJs=7, nJl=7
cDir=3, nDir=3
travelledDist=8
0: 0. 3: 3. 2: 2. 
/////////////////////////////          -3--------------
/////////////#///####/###////          3-4-------------
////////////#:###::::#:::#///          -4-3------------
////////////#X::####:###X:#//          --3-3-----------
////////////#:#::X::X:##:#///          ---3-5----------
////////////#:###.###X::X#///          ----5-3---------
////////////#X./////#:##:#///          -----3-2--------
////////////#:#/////.X####///          ------2-3-2-----
////////////#:#/////#::X::#//          -------3-2------
////////////#X.//////##.#:#//          --------2-------
////////////#:#/////////#:#//          -------2---3----
////////////#:#/////////#:#//          ----------3-----
////////////#:##////////#:#//          ----------------
////////////#X::#///////#:#//          ----------------
////////////#:#X.///////.O#//          ----------------
/////////////##:#////////#///          ----------------
Normal mode start
Down=0, Left=1, Right=0, Up=0
Visited=1, junction=0
Entered new square
Normal mode end
Op mode: 0 Rot=1 MovF=1
Rotating mode starts
curDir=2 
 Rotating mode ends
Op mode: 0 Rot=0 MovF=1
Moving forward mode starts
travelledDist=9
curPos=(14,24) 
 Moving forward mode ends
Op mode: 0 Rot=0 MovF=0
Op mode: 0 Rot=0 MovF=0
Op mode: 0 Rot=0 MovF=0

74
cPos=(14,24)
cJ=11, JCon=12, lJDir=0, nJs=7, nJl=7
cDir=2, nDir=2
travelledDist=9
3: 3. 2: 2. 1: 1. 
/////////////////////////////          -3--------------
/////////////#///####/###////          3-4-------------
////////////#:###::::#:::#///          -4-3------------
////////////#X::####:###X:#//          --3-3-----------
////////////#:#::X::X:##:#///          ---3-5----------
////////////#:###.###X::X#///          ----5-3---------
////////////#X./////#:##:#///          -----3-2--------
////////////#:#/////.X####///          ------2-3-2-----
////////////#:#/////#::X::#//          -------3-2------
////////////#X.//////##.#:#//          --------2-------
////////////#:#/////////#:#//          -------2---3----
////////////#:#/////////#:#//          ----------3-----
////////////#:##////////#:#//          ----------------
////////////#X::#///////#:#//          ----------------
////////////#:#X.//////.O:#//          ----------------
/////////////##:#///////##///          ----------------
Normal mode start
Down=0, Left=1, Right=0, Up=0
Visited=1, junction=0
Entered new square
Normal mode end
Op mode: 0 Rot=0 MovF=1
Op mode: 0 Rot=0 MovF=1
Moving forward mode starts
travelledDist=10
curPos=(14,23) 
 Moving forward mode ends
Op mode: 0 Rot=0 MovF=0
Op mode: 0 Rot=0 MovF=0
Op mode: 0 Rot=0 MovF=0

75
cPos=(14,23)
cJ=11, JCon=12, lJDir=0, nJs=7, nJl=7
cDir=2, nDir=2
travelledDist=10
3: 3. 2: 2. 1: 1. 
/////////////////////////////          -3--------------
/////////////#///####/###////          3-4-------------
////////////#:###::::#:::#///          -4-3------------
////////////#X::####:###X:#//          --3-3-----------
////////////#:#::X::X:##:#///          ---3-5----------
////////////#:###.###X::X#///          ----5-3---------
////////////#X./////#:##:#///          -----3-2--------
////////////#:#/////.X####///          ------2-3-2-----
////////////#:#/////#::X::#//          -------3-2------
////////////#X.//////##.#:#//          --------2-------
////////////#:#/////////#:#//          -------2---3----
////////////#:#/////////#:#//          ----------3-----
////////////#:##////////#:#//          ----------------
////////////#X::#//////##:#//          ----------------
////////////#:#X./////.O::#//          ----------------
/////////////##:#//////###///          ----------------
Normal mode start
Down=0, Left=1, Right=0, Up=0
Visited=1, junction=0
Entered new square
Normal mode end
Op mode: 0 Rot=0 MovF=1
Op mode: 0 Rot=0 MovF=1
Moving forward mode starts
travelledDist=11
curPos=(14,22) 
 Moving forward mode ends
Op mode: 0 Rot=0 MovF=0
Op mode: 0 Rot=0 MovF=0
Op mode: 0 Rot=0 MovF=0

76
cPos=(14,22)
cJ=11, JCon=12, lJDir=0, nJs=7, nJl=7
cDir=2, nDir=2
travelledDist=11
3: 3. 2: 2. 1: 1. 
/////////////////////////////          -3--------------
/////////////#///####/###////          3-4-------------
////////////#:###::::#:::#///          -4-3------------
////////////#X::####:###X:#//          --3-3-----------
////////////#:#::X::X:##:#///          ---3-5----------
////////////#:###.###X::X#///          ----5-3---------
////////////#X./////#:##:#///          -----3-2--------
////////////#:#/////.X####///          ------2-3-2-----
////////////#:#/////#::X::#//          -------3-2------
////////////#X.//////##.#:#//          --------2-------
////////////#:#/////////#:#//          -------2---3----
////////////#:#/////////#:#//          ----------3-----
////////////#:##////////#:#//          ----------------
////////////#X::#/////###:#//          ----------------
////////////#:#X.////.O:::#//          ----------------
/////////////##:#/////####///          ----------------
Normal mode start
Down=0, Left=1, Right=0, Up=0
Visited=1, junction=0
Entered new square
Normal mode end
Op mode: 0 Rot=0 MovF=1
Op mode: 0 Rot=0 MovF=1
Moving forward mode starts
travelledDist=12
curPos=(14,21) 
 Moving forward mode ends
Op mode: 0 Rot=0 MovF=0
Op mode: 0 Rot=0 MovF=0
Op mode: 0 Rot=0 MovF=0

77
cPos=(14,21)
cJ=11, JCon=12, lJDir=0, nJs=7, nJl=7
cDir=2, nDir=2
travelledDist=12
3: 3. 2: 2. 1: 1. 
/////////////////////////////          -3--------------
/////////////#///####/###////          3-4-------------
////////////#:###::::#:::#///          -4-3------------
////////////#X::####:###X:#//          --3-3-----------
////////////#:#::X::X:##:#///          ---3-5----------
////////////#:###.###X::X#///          ----5-3---------
////////////#X./////#:##:#///          -----3-2--------
////////////#:#/////.X####///          ------2-3-2-----
////////////#:#/////#::X::#//          -------3-2------
////////////#X.//////##.#:#//          --------2-------
////////////#:#/////////#:#//          -------2---3----
////////////#:#/////////#:#//          ----------3-----
////////////#:##////////#:#//          ----------------
////////////#X::#////####:#//          ----------------
////////////#:#X.///.O::::#//          ----------------
/////////////##:#////#####///          ----------------
Normal mode start
Down=0, Left=1, Right=0, Up=0
Visited=1, junction=0
Entered new square
Normal mode end
Op mode: 0 Rot=0 MovF=1
Op mode: 0 Rot=0 MovF=1
Moving forward mode starts
travelledDist=13
curPos=(14,20) 
 Moving forward mode ends
Op mode: 0 Rot=0 MovF=0
Op mode: 0 Rot=0 MovF=0
Op mode: 0 Rot=0 MovF=0

78
cPos=(14,20)
cJ=11, JCon=12, lJDir=0, nJs=7, nJl=7
cDir=2, nDir=2
travelledDist=13
3: 3. 2: 2. 1: 1. 
/////////////////////////////          -3--------------
/////////////#///####/###////          3-4-------------
////////////#:###::::#:::#///          -4-3------------
////////////#X::####:###X:#//          --3-3-----------
////////////#:#::X::X:##:#///          ---3-5----------
////////////#:###.###X::X#///          ----5-3---------
////////////#X./////#:##:#///          -----3-2--------
////////////#:#/////.X####///          ------2-3-2-----
////////////#:#/////#::X::#//          -------3-2------
////////////#X.//////##.#:#//          --------2-------
////////////#:#/////////#:#//          -------2---3----
////////////#:#/////////#:#//          ----------3-----
////////////#:##////////#:#//          ----------------
////////////#X::#///.####:#//          ----------------
////////////#:#X.//.O:::::#//          ----------------
/////////////##:#///######///          ----------------
Normal mode start
Down=0, Left=1, Right=0, Up=1
Visited=1, junction=0
Entered new square
Has unex roads, UnexSQ=2
Array=0, j1=11, j2=12
1337
j1=11, j2=12, direction=0,Added right
j1=12, j2=11, direction=0,Added right
J#=11, right=12, up=0, left=10, down=0
J#=12, right=11, up=0, left=0, down=0
Normal mode end
Op mode: 0 Rot=0 MovF=1
Op mode: 0 Rot=0 MovF=1
Moving forward mode starts
travelledDist=1
curPos=(14,19) 
 Moving forward mode ends
Op mode: 0 Rot=0 MovF=0
Op mode: 0 Rot=0 MovF=0
Op mode: 0 Rot=0 MovF=0

79
cPos=(14,19)
cJ=12, JCon=13, lJDir=2, nJs=7, nJl=7
cDir=2, nDir=2
travelledDist=1
3: 3. 2: 2. 1: 1. 
/////////////////////////////          -3--------------
/////////////#///####/###////          3-4-------------
////////////#:###::::#:::#///          -4-3------------
////////////#X::####:###X:#//          --3-3-----------
////////////#:#::X::X:##:#///          ---3-5----------
////////////#:###.###X::X#///          ----5-3---------
////////////#X./////#:##:#///          -----3-2--------
////////////#:#/////.X####///          ------2-3-2-----
////////////#:#/////#::X::#//          -------3-2------
////////////#X.//////##.#:#//          --------2-------
////////////#:#/////////#:#//          -------2---3----
////////////#:#/////////#:#//          ----------3-13---
////////////#:##////////#:#//          -----------13----
////////////#X::#//#.####:#//          ----------------
////////////#:#X./.OX:::::#//          ----------------
/////////////##:#//#######///          ----------------
Normal mode start
Down=0, Left=1, Right=1, Up=0
Visited=1, junction=0
Entered new square
Normal mode end
Op mode: 0 Rot=0 MovF=1
Op mode: 0 Rot=0 MovF=1
Moving forward mode starts
travelledDist=2
curPos=(14,18) 
 Moving forward mode ends
Op mode: 0 Rot=0 MovF=0
Op mode: 0 Rot=0 MovF=0
Op mode: 0 Rot=0 MovF=0

80
cPos=(14,18)
cJ=12, JCon=13, lJDir=2, nJs=7, nJl=7
cDir=2, nDir=2
travelledDist=2
3: 3. 2: 2. 1: 1. 
/////////////////////////////          -3--------------
/////////////#///####/###////          3-4-------------
////////////#:###::::#:::#///          -4-3------------
////////////#X::####:###X:#//          --3-3-----------
////////////#:#::X::X:##:#///          ---3-5----------
////////////#:###.###X::X#///          ----5-3---------
////////////#X./////#:##:#///          -----3-2--------
////////////#:#/////.X####///          ------2-3-2-----
////////////#:#/////#::X::#//          -------3-2------
////////////#X.//////##.#:#//          --------2-------
////////////#:#/////////#:#//          -------2---3----
////////////#:#/////////#:#//          ----------3-13---
////////////#:##////////#:#//          -----------13----
////////////#X::#/##.####:#//          ----------------
////////////#:#X..O:X:::::#//          ----------------
/////////////##:#/########///          ----------------
Normal mode start
Down=0, Left=1, Right=0, Up=0
Visited=1, junction=0
Entered new square
Normal mode end
Op mode: 0 Rot=0 MovF=1
Op mode: 0 Rot=0 MovF=1
Moving forward mode starts
travelledDist=3
curPos=(14,17) 
 Moving forward mode ends
Op mode: 0 Rot=0 MovF=0
Op mode: 0 Rot=0 MovF=0
Op mode: 0 Rot=0 MovF=0

81
cPos=(14,17)
cJ=12, JCon=13, lJDir=2, nJs=7, nJl=7
cDir=2, nDir=2
travelledDist=3
3: 3. 2: 2. 1: 1. 
/////////////////////////////          -3--------------
/////////////#///####/###////          3-4-------------
////////////#:###::::#:::#///          -4-3------------
////////////#X::####:###X:#//          --3-3-----------
////////////#:#::X::X:##:#///          ---3-5----------
////////////#:###.###X::X#///          ----5-3---------
////////////#X./////#:##:#///          -----3-2--------
////////////#:#/////.X####///          ------2-3-2-----
////////////#:#/////#::X::#//          -------3-2------
////////////#X.//////##.#:#//          --------2-------
////////////#:#/////////#:#//          -------2---3----
////////////#:#/////////#:#//          ----------3-13---
////////////#:##////////#:#//          -----------13----
////////////#X::#.##.####:#//          ----------------
////////////#:#X.O::X:::::#//          ----------------
/////////////##:##########///          ----------------
Normal mode start
Down=0, Left=1, Right=0, Up=1
Visited=1, junction=0
Entered new square
Has unex roads, UnexSQ=2
Array=0, j1=12, j2=13
1337
j1=12, j2=13, direction=2,Added left
j1=13, j2=12, direction=0,Added right
J#=12, right=11, up=0, left=13, down=0
J#=13, right=12, up=0, left=0, down=0
Normal mode end
Op mode: 0 Rot=0 MovF=1
Op mode: 0 Rot=0 MovF=1
Moving forward mode starts
travelledDist=1
curPos=(14,16) 
 Moving forward mode ends
Op mode: 0 Rot=0 MovF=0
Op mode: 0 Rot=0 MovF=0
Op mode: 0 Rot=0 MovF=0

82
cPos=(14,16)
cJ=13, JCon=14, lJDir=2, nJs=7, nJl=7
cDir=2, nDir=2
travelledDist=1
3: 3. 2: 2. 1: 1. 
/////////////////////////////          -3--------------
/////////////#///####/###////          3-4-------------
////////////#:###::::#:::#///          -4-3------------
////////////#X::####:###X:#//          --3-3-----------
////////////#:#::X::X:##:#///          ---3-5----------
////////////#:###.###X::X#///          ----5-3---------
////////////#X./////#:##:#///          -----3-2--------
////////////#:#/////.X####///          ------2-3-2-----
////////////#:#/////#::X::#//          -------3-2------
////////////#X.//////##.#:#//          --------2-------
////////////#:#/////////#:#//          -------2---3----
////////////#:#/////////#:#//          ----------3-13---
////////////#:##////////#:#//          -----------13-3--
////////////#X::#.##.####:#//          ------------3---
////////////#:#XOX::X:::::#//          ----------------
/////////////##:##########///          ----------------
Normal mode start
Down=0, Left=1, Right=1, Up=0
Visited=1, junction=0
Entered new square
Normal mode end
Op mode: 0 Rot=0 MovF=1
Op mode: 0 Rot=0 MovF=1
Moving forward mode starts
travelledDist=2
curPos=(14,15) 
 Moving forward mode ends
Op mode: 0 Rot=0 MovF=0
Op mode: 0 Rot=0 MovF=0
Op mode: 0 Rot=0 MovF=0

83
cPos=(14,15)
cJ=13, JCon=14, lJDir=2, nJs=7, nJl=7
cDir=2, nDir=2
travelledDist=2
3: 3. 2: 2. 1: 1. 
/////////////////////////////          -3--------------
/////////////#///####/###////          3-4-------------
////////////#:###::::#:::#///          -4-3------------
////////////#X::####:###X:#//          --3-3-----------
////////////#:#::X::X:##:#///          ---3-5----------
////////////#:###.###X::X#///          ----5-3---------
////////////#X./////#:##:#///          -----3-2--------
////////////#:#/////.X####///          ------2-3-2-----
////////////#:#/////#::X::#//          -------3-2------
////////////#X.//////##.#:#//          --------2-------
////////////#:#/////////#:#//          -------2---3----
////////////#:#/////////#:#//          ----------3-13---
////////////#:##////////#:#//          -----------13-3--
////////////#X::#.##.####:#//          ------------3---
////////////#:#O:X::X:::::#//          ----------------
/////////////##:##########///          ----------------
Normal mode start
Down=0, Left=0, Right=0, Up=0
Visited=1, junction=1
Entered visited junction
Array=0, j1=13, j2=0
1337
j1=0, j2=13, direction=0,Added right
j1=13, j2=0, direction=2,Added left
J#=13, right=12, up=0, left=0, down=0
J#=0, right=13, up=1, left=0, down=0
Sent dir=0
Tester=0, UnexSq=0, 0=00, 1=00, 2=00, 3=00
Fully explored junction
WTF CurJunction = 0
 14
Decided nJl=13
Op mode: 2 Rot=0 MovF=0
Op mode: 2 Rot=0 MovF=0
Op mode: 2 Rot=0 MovF=0
Far junction mode starts
Destination decided, nJl=13
Åk mot nJs
nDir=1, cJ=0, nJs=1
nDir=1, cJ=0, nJs=1
Far junction mode ends
Op mode: 3 Rot=1 MovF=1

84
cPos=(14,15)
cJ=0, JCon=14, lJDir=2, nJs=1, nJl=13
cDir=2, nDir=1
travelledDist=0
3: 3. 2: 2. 1: 1. 
/////////////////////////////          -3-----------2--
/////////////#///####/###////          3-4-------------
////////////#:###::::#:::#///          -4-3------------
////////////#X::####:###X:#//          --3-3-----------
////////////#:#::X::X:##:#///          ---3-5----------
////////////#:###.###X::X#///          ----5-3---------
////////////#X./////#:##:#///          -----3-2--------
////////////#:#/////.X####///          ------2-3-2-----
////////////#:#/////#::X::#//          -------3-2------
////////////#X.//////##.#:#//          --------2-------
////////////#:#/////////#:#//          -------2---3----
////////////#:#/////////#:#//          ----------3-13---
////////////#:##////////#:#//          -----------13-3--
////////////#X::#.##.####:#//          2-----------3---
////////////#:#O:X::X:::::#//          ----------------
/////////////##:##########///          ----------------
Op mode: 3 Rot=1 MovF=1
Rotating mode starts
curDir=1 
 Rotating mode ends
Op mode: 3 Rot=0 MovF=1
Moving forward mode starts
travelledDist=1
curPos=(13,15) 
 Moving forward mode ends
Op mode: 3 Rot=0 MovF=0
Go to junction mode starts
Right=0
Left=1
ROT=1
Go to junction mode ends
Op mode: 3 Rot=1 MovF=1
Op mode: 3 Rot=1 MovF=1

85
cPos=(13,15)
cJ=0, JCon=14, lJDir=1, nJs=1, nJl=13
cDir=1, nDir=2
travelledDist=1
2: 2. 1: 1. 0: 0. 
/////////////////////////////          -3-----------2--
/////////////#///####/###////          3-4-------------
////////////#:###::::#:::#///          -4-3------------
////////////#X::####:###X:#//          --3-3-----------
////////////#:#::X::X:##:#///          ---3-5----------
////////////#:###.###X::X#///          ----5-3---------
////////////#X./////#:##:#///          -----3-2--------
////////////#:#/////.X####///          ------2-3-2-----
////////////#:#/////#::X::#//          -------3-2------
////////////#X.//////##.#:#//          --------2-------
////////////#:#/////////#:#//          -------2---3----
////////////#:#/////////#:#//          ----------3-13---
////////////#:##////////#:#//          -----------13-3--
////////////#X:O#.##.####:#//          2-----------3---
////////////#:#X:X::X:::::#//          ----------------
/////////////##:##########///          ----------------
Op mode: 3 Rot=1 MovF=1
Rotating mode starts
curDir=2 
 Rotating mode ends
Op mode: 3 Rot=0 MovF=1
Moving forward mode starts
travelledDist=2
curPos=(13,14) 
 Moving forward mode ends
Op mode: 3 Rot=0 MovF=0
Go to junction mode starts
Up=0
Down=0
Go to junction mode ends
Op mode: 3 Rot=0 MovF=1
Op mode: 3 Rot=0 MovF=1

86
cPos=(13,14)
cJ=0, JCon=14, lJDir=1, nJs=1, nJl=13
cDir=2, nDir=2
travelledDist=2
3: 3. 2: 2. 1: 1. 
/////////////////////////////          -3-----------2--
/////////////#///####/###////          3-4-------------
////////////#:###::::#:::#///          -4-3------------
////////////#X::####:###X:#//          --3-3-----------
////////////#:#::X::X:##:#///          ---3-5----------
////////////#:###.###X::X#///          ----5-3---------
////////////#X./////#:##:#///          -----3-2--------
////////////#:#/////.X####///          ------2-3-2-----
////////////#:#/////#::X::#//          -------3-2------
////////////#X.//////##.#:#//          --------2-------
////////////#:#/////////#:#//          -------2---3----
////////////#:#/////////#:#//          ----------3-13---
////////////#:##////////#:#//          -----------13-3--
////////////#XO:#.##.####:#//          2-----------3---
////////////#:#X:X::X:::::#//          ----------------
/////////////##:##########///          ----------------
Op mode: 3 Rot=0 MovF=1
Op mode: 3 Rot=0 MovF=1
Moving forward mode starts
travelledDist=3
curPos=(13,13) 
 Moving forward mode ends
Op mode: 3 Rot=0 MovF=0
Go to junction mode starts
Up=1
ROT=-1
curJ=nJs!!
Down=0, Left=0, Right=0, Up=0
Tester=0, UnexSq=0, 0=01, 1=01, 2=01, 3=01
 14
Decided nJl=13
Go to junction mode ends
Op mode: 2 Rot=1 MovF=0
Op mode: 2 Rot=1 MovF=0

87
cPos=(13,13)
cJ=1, JCon=14, lJDir=1, nJs=2, nJl=13
cDir=2, nDir=1
travelledDist=0
3: 3. 2: 2. 1: 1. 
/////////////////////////////          -3-----------2--
/////////////#///####/###////          3-4-------------
////////////#:###::::#:::#///          -4-3------------
////////////#X::####:###X:#//          --3-3-----------
////////////#:#::X::X:##:#///          ---3-5----------
////////////#:###.###X::X#///          ----5-3---------
////////////#X./////#:##:#///          -----3-2--------
////////////#:#/////.X####///          ------2-3-2-----
////////////#:#/////#::X::#//          -------3-2------
////////////#X.//////##.#:#//          --------2-------
////////////#:#/////////#:#//          -------2---3----
////////////#:#/////////#:#//          ----------3-13---
////////////#:##////////#:#//          -----------13-3--
////////////#O::#.##.####:#//          2-----------3---
////////////#:#X:X::X:::::#//          ----------------
/////////////##:##########///          ----------------
Op mode: 2 Rot=1 MovF=0
Rotating mode starts
curDir=1 
 Rotating mode ends
Op mode: 2 Rot=0 MovF=0
Op mode: 2 Rot=0 MovF=0
Op mode: 2 Rot=0 MovF=0
Far junction mode starts
Destination decided, nJl=13
Åk mot nJs
nDir=1, cJ=1, nJs=2
nDir=1, cJ=1, nJs=2
Far junction mode ends
Op mode: 3 Rot=0 MovF=1

88
cPos=(13,13)
cJ=1, JCon=14, lJDir=1, nJs=2, nJl=13
cDir=1, nDir=1
travelledDist=0
2: 2. 1: 1. 0: 0. 
/////////////////////////////          -3-----------2--
/////////////#///####/###////          3-4-------------
////////////#:###::::#:::#///          -4-3------------
////////////#X::####:###X:#//          --3-3-----------
////////////#:#::X::X:##:#///          ---3-5----------
////////////#:###.###X::X#///          ----5-3---------
////////////#X./////#:##:#///          -----3-2--------
////////////#:#/////.X####///          ------2-3-2-----
////////////#:#/////#::X::#//          -------3-2------
////////////#X.//////##.#:#//          --------2-------
////////////#:#/////////#:#//          -------2---3----
////////////#:#/////////#:#//          ----------3-13---
////////////#:##////////#:#//          -----------13-3--
////////////#O::#.##.####:#//          2-----------3---
////////////#:#X:X::X:::::#//          ----------------
/////////////##:##########///          ----------------
Op mode: 3 Rot=0 MovF=1
Op mode: 3 Rot=0 MovF=1
Moving forward mode starts
travelledDist=1
curPos=(12,13) 
 Moving forward mode ends
Op mode: 3 Rot=0 MovF=0
Go to junction mode starts
Right=0
Left=0
Go to junction mode ends
Op mode: 3 Rot=0 MovF=1
Op mode: 3 Rot=0 MovF=1

89
cPos=(12,13)
cJ=1, JCon=14, lJDir=1, nJs=2, nJl=13
cDir=1, nDir=1
travelledDist=1
2: 2. 1: 1. 0: 0. 
/////////////////////////////          -3-----------2--
/////////////#///####/###////          3-4-------------
////////////#:###::::#:::#///          -4-3------------
////////////#X::####:###X:#//          --3-3-----------
////////////#:#::X::X:##:#///          ---3-5----------
////////////#:###.###X::X#///          ----5-3---------
////////////#X./////#:##:#///          -----3-2--------
////////////#:#/////.X####///          ------2-3-2-----
////////////#:#/////#::X::#//          -------3-2------
////////////#X.//////##.#:#//          --------2-------
////////////#:#/////////#:#//          -------2---3----
////////////#:#/////////#:#//          ----------3-13---
////////////#O##////////#:#//          -----------13-3--
////////////#X::#.##.####:#//          2-----------3---
////////////#:#X:X::X:::::#//          ----------------
/////////////##:##########///          ----------------
Op mode: 3 Rot=0 MovF=1
Op mode: 3 Rot=0 MovF=1
Moving forward mode starts
travelledDist=2
curPos=(11,13) 
 Moving forward mode ends
Op mode: 3 Rot=0 MovF=0
Go to junction mode starts
Right=0
Left=0
Go to junction mode ends
Op mode: 3 Rot=0 MovF=1
Op mode: 3 Rot=0 MovF=1

90
cPos=(11,13)
cJ=1, JCon=14, lJDir=1, nJs=2, nJl=13
cDir=1, nDir=1
travelledDist=2
2: 2. 1: 1. 0: 0. 
/////////////////////////////          -3-----------2--
/////////////#///####/###////          3-4-------------
////////////#:###::::#:::#///          -4-3------------
////////////#X::####:###X:#//          --3-3-----------
////////////#:#::X::X:##:#///          ---3-5----------
////////////#:###.###X::X#///          ----5-3---------
////////////#X./////#:##:#///          -----3-2--------
////////////#:#/////.X####///          ------2-3-2-----
////////////#:#/////#::X::#//          -------3-2------
////////////#X.//////##.#:#//          --------2-------
////////////#:#/////////#:#//          -------2---3----
////////////#O#/////////#:#//          ----------3-13---
////////////#:##////////#:#//          -----------13-3--
////////////#X::#.##.####:#//          2-----------3---
////////////#:#X:X::X:::::#//          ----------------
/////////////##:##########///          ----------------
Op mode: 3 Rot=0 MovF=1
Op mode: 3 Rot=0 MovF=1
Moving forward mode starts
travelledDist=3
curPos=(10,13) 
 Moving forward mode ends
Op mode: 3 Rot=0 MovF=0
Go to junction mode starts
Right=0
Left=0
Go to junction mode ends
Op mode: 3 Rot=0 MovF=1
Op mode: 3 Rot=0 MovF=1

91
cPos=(10,13)
cJ=1, JCon=14, lJDir=1, nJs=2, nJl=13
cDir=1, nDir=1
travelledDist=3
2: 2. 1: 1. 0: 0. 
/////////////////////////////          -3-----------2--
/////////////#///####/###////          3-4-------------
////////////#:###::::#:::#///          -4-3------------
////////////#X::####:###X:#//          --3-3-----------
////////////#:#::X::X:##:#///          ---3-5----------
////////////#:###.###X::X#///          ----5-3---------
////////////#X./////#:##:#///          -----3-2--------
////////////#:#/////.X####///          ------2-3-2-----
////////////#:#/////#::X::#//          -------3-2------
////////////#X.//////##.#:#//          --------2-------
////////////#O#/////////#:#//          -------2---3----
////////////#:#/////////#:#//          ----------3-13---
////////////#:##////////#:#//          -----------13-3--
////////////#X::#.##.####:#//          2-----------3---
////////////#:#X:X::X:::::#//          ----------------
/////////////##:##########///          ----------------
Op mode: 3 Rot=0 MovF=1
Op mode: 3 Rot=0 MovF=1
Moving forward mode starts
travelledDist=4
curPos=(9,13) 
 Moving forward mode ends
Op mode: 3 Rot=0 MovF=0
Go to junction mode starts
Right=1
ROT=-1
curJ=nJs!!
Down=0, Left=0, Right=1, Up=0
Tester=1, UnexSq=1, 0=01, 1=01, 2=01, 3=01
UnexSq exist!!
Go to junction mode ends
Op mode: 0 Rot=0 MovF=0
Op mode: 0 Rot=0 MovF=0

92
cPos=(9,13)
cJ=2, JCon=14, lJDir=1, nJs=2, nJl=13
cDir=1, nDir=0
travelledDist=0
2: 2. 1: 1. 0: 0. 
/////////////////////////////          -3-----------2--
/////////////#///####/###////          3-4-------------
////////////#:###::::#:::#///          -4-3------------
////////////#X::####:###X:#//          --3-3-----------
////////////#:#::X::X:##:#///          ---3-5----------
////////////#:###.###X::X#///          ----5-3---------
////////////#X./////#:##:#///          -----3-2--------
////////////#:#/////.X####///          ------2-3-2-----
////////////#:#/////#::X::#//          -------3-2------
////////////#O.//////##.#:#//          --------2-------
////////////#:#/////////#:#//          -------2---3----
////////////#:#/////////#:#//          ----------3-13---
////////////#:##////////#:#//          -----------13-3--
////////////#X::#.##.####:#//          2-----------3---
////////////#:#X:X::X:::::#//          ----------------
/////////////##:##########///          ----------------
Normal mode start
Down=0, Left=0, Right=1, Up=0
Visited=1, junction=1
Entered visited junction
Array=0, j1=2, j2=2
Array=0, j1=2, j2=2
J#=2, right=0, up=3, left=0, down=1
J#=2, right=0, up=3, left=0, down=1
Sent dir=3
Tester=1, UnexSq=1, 0=01, 1=01, 2=01, 3=01
Has UnexSQ=1
Normal mode end
Op mode: 0 Rot=1 MovF=1
Rotating mode starts
curDir=0 
 Rotating mode ends
Op mode: 0 Rot=0 MovF=1
Moving forward mode starts
travelledDist=1
curPos=(9,14) 
 Moving forward mode ends
Op mode: 0 Rot=0 MovF=0
Op mode: 0 Rot=0 MovF=0
Op mode: 0 Rot=0 MovF=0

93
cPos=(9,14)
cJ=2, JCon=14, lJDir=0, nJs=2, nJl=13
cDir=0, nDir=0
travelledDist=1
1: 1. 0: 0. 3: 3. 
/////////////////////////////          -3-----------2--
/////////////#///####/###////          3-4-------------
////////////#:###::::#:::#///          -4-3------------
////////////#X::####:###X:#//          --3-3-----------
////////////#:#::X::X:##:#///          ---3-5----------
////////////#:###.###X::X#///          ----5-3---------
////////////#X./////#:##:#///          -----3-2--------
////////////#:#/////.X####///          ------2-3-2-----
////////////#:#/////#::X::#//          -------3-2------
////////////#XO./////##.#:#//          --------2-------
////////////#:#/////////#:#//          -------2---3----
////////////#:#/////////#:#//          ----------3-13---
////////////#:##////////#:#//          -----------13-3--
////////////#X::#.##.####:#//          2-----------3---
////////////#:#X:X::X:::::#//          ----------------
/////////////##:##########///          ----------------
Normal mode start
Down=0, Left=1, Right=1, Up=0
Visited=1, junction=0
Entered new square
Normal mode end
Op mode: 0 Rot=0 MovF=1
Op mode: 0 Rot=0 MovF=1
Moving forward mode starts
travelledDist=2
curPos=(9,15) 
 Moving forward mode ends
Op mode: 0 Rot=0 MovF=0
Op mode: 0 Rot=0 MovF=0
Op mode: 0 Rot=0 MovF=0

94
cPos=(9,15)
cJ=2, JCon=14, lJDir=0, nJs=2, nJl=13
cDir=0, nDir=0
travelledDist=2
1: 1. 0: 0. 3: 3. 
/////////////////////////////          -3-----------2--
/////////////#///####/###////          3-4-------------
////////////#:###::::#:::#///          -4-3------------
////////////#X::####:###X:#//          --3-3-----------
////////////#:#::X::X:##:#///          ---3-5----------
////////////#:###.###X::X#///          ----5-3---------
////////////#X./////#:##:#///          -----3-2--------
////////////#:#/////.X####///          ------2-3-2-----
////////////#:#.////#::X::#//          -------3-2------
////////////#X:O#////##.#:#//          --------2-------
////////////#:##////////#:#//          -------2---3----
////////////#:#/////////#:#//          ----------3-13---
////////////#:##////////#:#//          -----------13-3--
////////////#X::#.##.####:#//          2-----------3---
////////////#:#X:X::X:::::#//          ----------------
/////////////##:##########///          ----------------
Normal mode start
Down=0, Left=0, Right=0, Up=1
Visited=1, junction=0
Entered new square
Normal mode end
Op mode: 0 Rot=1 MovF=1
Rotating mode starts
curDir=1 
 Rotating mode ends
Op mode: 0 Rot=0 MovF=1
Moving forward mode starts
travelledDist=3
curPos=(8,15) 
 Moving forward mode ends
Op mode: 0 Rot=0 MovF=0
Op mode: 0 Rot=0 MovF=0
Op mode: 0 Rot=0 MovF=0

95
cPos=(8,15)
cJ=2, JCon=14, lJDir=0, nJs=2, nJl=13
cDir=1, nDir=1
travelledDist=3
2: 2. 1: 1. 0: 0. 
/////////////////////////////          -3-----------2--
/////////////#///####/###////          3-4-------------
////////////#:###::::#:::#///          -4-3------------
////////////#X::####:###X:#//          --3-3-----------
////////////#:#::X::X:##:#///          ---3-5----------
////////////#:###.###X::X#///          ----5-3---------
////////////#X./////#:##:#///          -----3-2--------
////////////#:#.////.X####///          ------2-3-2-----
////////////#:#O#///#::X::#//          -------3-2------
////////////#X::#////##.#:#//          --------2-------
////////////#:##////////#:#//          -------2---3----
////////////#:#/////////#:#//          ----------3-13---
////////////#:##////////#:#//          -----------13-3--
////////////#X::#.##.####:#//          2-----------3---
////////////#:#X:X::X:::::#//          ----------------
/////////////##:##########///          ----------------
Normal mode start
Down=0, Left=0, Right=0, Up=1
Visited=1, junction=0
Entered new square
Normal mode end
Op mode: 0 Rot=0 MovF=1
Op mode: 0 Rot=0 MovF=1
Moving forward mode starts
travelledDist=4
curPos=(7,15) 
 Moving forward mode ends
Op mode: 0 Rot=0 MovF=0
Op mode: 0 Rot=0 MovF=0
Op mode: 0 Rot=0 MovF=0

96
cPos=(7,15)
cJ=2, JCon=14, lJDir=0, nJs=2, nJl=13
cDir=1, nDir=1
travelledDist=4
2: 2. 1: 1. 0: 0. 
/////////////////////////////          -3-----------2--
/////////////#///####/###////          3-4-------------
////////////#:###::::#:::#///          -4-3------------
////////////#X::####:###X:#//          --3-3-----------
////////////#:#::X::X:##:#///          ---3-5----------
////////////#:###.###X::X#///          ----5-3---------
////////////#X..////#:##:#///          -----3-2--------
////////////#:#O#///.X####///          ------2-3-2-----
////////////#:#:#///#::X::#//          -------3-2------
////////////#X::#////##.#:#//          --------2-------
////////////#:##////////#:#//          -------2---3----
////////////#:#/////////#:#//          ----------3-13---
////////////#:##////////#:#//          -----------13-3--
////////////#X::#.##.####:#//          2-----------3---
////////////#:#X:X::X:::::#//          ----------------
/////////////##:##########///          ----------------
Normal mode start
Down=0, Left=0, Right=0, Up=1
Visited=1, junction=0
Entered new square
Normal mode end
Op mode: 0 Rot=0 MovF=1
Op mode: 0 Rot=0 MovF=1
Moving forward mode starts
travelledDist=5
curPos=(6,15) 
 Moving forward mode ends
Op mode: 0 Rot=0 MovF=0
Op mode: 0 Rot=0 MovF=0
Op mode: 0 Rot=0 MovF=0

97
cPos=(6,15)
cJ=2, JCon=14, lJDir=0, nJs=2, nJl=13
cDir=1, nDir=1
travelledDist=5
2: 2. 1: 1. 0: 0. 
/////////////////////////////          -3-----------2--
/////////////#///####/###////          3-4-------------
////////////#:###::::#:::#///          -4-3------------
////////////#X::####:###X:#//          --3-3-----------
////////////#:#::X::X:##:#///          ---3-5----------
////////////#:###.###X::X#///          ----5-3---------
////////////#X.O#///#:##:#///          -----3-2--------
////////////#:#:#///.X####///          ------2-3-2-----
////////////#:#:#///#::X::#//          -------3-2------
////////////#X::#////##.#:#//          --------2-------
////////////#:##////////#:#//          -------2---3----
////////////#:#/////////#:#//          ----------3-13---
////////////#:##////////#:#//          -----------13-3--
////////////#X::#.##.####:#//          2-----------3---
////////////#:#X:X::X:::::#//          ----------------
/////////////##:##########///          ----------------
Normal mode start
Down=0, Left=1, Right=0, Up=0
Visited=1, junction=0
Entered new square
Normal mode end
Op mode: 0 Rot=1 MovF=1
Rotating mode starts
curDir=2 
 Rotating mode ends
Op mode: 0 Rot=0 MovF=1
Moving forward mode starts
travelledDist=6
curPos=(6,14) 
 Moving forward mode ends
Op mode: 0 Rot=0 MovF=0
Op mode: 0 Rot=0 MovF=0
Op mode: 0 Rot=0 MovF=0

98
cPos=(6,14)
cJ=2, JCon=14, lJDir=0, nJs=2, nJl=13
cDir=2, nDir=2
travelledDist=6
3: 3. 2: 2. 1: 1. 
/////////////////////////////          -3-----------2--
/////////////#///####/###////          3-4-------------
////////////#:###::::#:::#///          -4-3------------
////////////#X::####:###X:#//          --3-3-----------
////////////#:#::X::X:##:#///          ---3-5----------
////////////#:###.###X::X#///          ----5-3---------
////////////#XO:#///#:##:#///          -----3-2--------
////////////#:#:#///.X####///          ------2-3-2-----
////////////#:#:#///#::X::#//          -------3-2------
////////////#X::#////##.#:#//          --------2-------
////////////#:##////////#:#//          -------2---3----
////////////#:#/////////#:#//          ----------3-13---
////////////#:##////////#:#//          -----------13-3--
////////////#X::#.##.####:#//          2-----------3---
////////////#:#X:X::X:::::#//          ----------------
/////////////##:##########///          ----------------
Normal mode start
Down=0, Left=1, Right=0, Up=0
Visited=1, junction=0
Entered new square
Normal mode end
Op mode: 0 Rot=0 MovF=1
Op mode: 0 Rot=0 MovF=1
Moving forward mode starts
travelledDist=7
curPos=(6,13) 
 Moving forward mode ends
Op mode: 0 Rot=0 MovF=0
Op mode: 0 Rot=0 MovF=0
Op mode: 0 Rot=0 MovF=0

99
cPos=(6,13)
cJ=2, JCon=14, lJDir=0, nJs=2, nJl=13
cDir=2, nDir=2
travelledDist=7
3: 3. 2: 2. 1: 1. 
/////////////////////////////          -3-----------2--
/////////////#///####/###////          3-4-------------
////////////#:###::::#:::#///          -4-3------------
////////////#X::####:###X:#//          --3-3-----------
////////////#:#::X::X:##:#///          ---3-5----------
////////////#:###.###X::X#///          ----5-3---------
////////////#O::#///#:##:#///          -----3-2--------
////////////#:#:#///.X####///          ------2-3-2-----
////////////#:#:#///#::X::#//          -------3-2------
////////////#X::#////##.#:#//          --------2-------
////////////#:##////////#:#//          -------2---3----
////////////#:#/////////#:#//          ----------3-13---
////////////#:##////////#:#//          -----------13-3--
////////////#X::#.##.####:#//          2-----------3---
////////////#:#X:X::X:::::#//          ----------------
/////////////##:##########///          ----------------
Normal mode start
Down=0, Left=0, Right=0, Up=0
Visited=1, junction=1
Entered visited junction
Array=3, j1=2, j2=3
Array=3, j1=3, j2=2
J#=2, right=0, up=3, left=0, down=1
J#=3, right=0, up=4, left=0, down=2
Sent dir=0
Tester=0, UnexSq=0, 0=01, 1=01, 2=01, 3=01
Fully explored junction
WTF CurJunction = 3
 14
Decided nJl=13
Op mode: 2 Rot=0 MovF=0
Op mode: 2 Rot=0 MovF=0
Op mode: 2 Rot=0 MovF=0
Far junction mode starts
Destination decided, nJl=13
Åk mot nJs
nDir=1, cJ=3, nJs=4
nDir=1, cJ=3, nJs=4
Far junction mode ends
Op mode: 3 Rot=1 MovF=1

100
cPos=(6,13)
cJ=3, JCon=14, lJDir=0, nJs=4, nJl=13
cDir=2, nDir=1
travelledDist=0
3: 3. 2: 2. 1: 1. 
/////////////////////////////          -3-----------2--
/////////////#///####/###////          3-4-------------
////////////#:###::::#:::#///          -4-3------------
////////////#X::####:###X:#//          --3-3-----------
////////////#:#::X::X:##:#///          ---3-5----------
////////////#:###.###X::X#///          ----5-3---------
////////////#O::#///#:##:#///          -----3-2--------
////////////#:#:#///.X####///          ------2-3-2-----
////////////#:#:#///#::X::#//          -------3-2------
////////////#X::#////##.#:#//          --------2-------
////////////#:##////////#:#//          -------2---3----
////////////#:#/////////#:#//          ----------3-13---
////////////#:##////////#:#//          -----------13-3--
////////////#X::#.##.####:#//          2-----------3---
////////////#:#X:X::X:::::#//          ----------------
/////////////##:##########///          ----------------
Op mode: 3 Rot=1 MovF=1
Rotating mode starts
curDir=1 
 Rotating mode ends
Op mode: 3 Rot=0 MovF=1
Moving forward mode starts
travelledDist=1
curPos=(5,13) 
 Moving forward mode ends
Op mode: 3 Rot=0 MovF=0
Go to junction mode starts
Right=0
Left=0
Go to junction mode ends
Op mode: 3 Rot=0 MovF=1
Op mode: 3 Rot=0 MovF=1

101
cPos=(5,13)
cJ=3, JCon=14, lJDir=1, nJs=4, nJl=13
cDir=1, nDir=1
travelledDist=1
2: 2. 1: 1. 0: 0. 
/////////////////////////////          -3-----------2--
/////////////#///####/###////          3-4-------------
////////////#:###::::#:::#///          -4-3------------
////////////#X::####:###X:#//          --3-3-----------
////////////#:#::X::X:##:#///          ---3-5----------
////////////#O###.###X::X#///          ----5-3---------
////////////#X::#///#:##:#///          -----3-2--------
////////////#:#:#///.X####///          ------2-3-2-----
////////////#:#:#///#::X::#//          -------3-2------
////////////#X::#////##.#:#//          --------2-------
////////////#:##////////#:#//          -------2---3----
////////////#:#/////////#:#//          ----------3-13---
////////////#:##////////#:#//          -----------13-3--
////////////#X::#.##.####:#//          2-----------3---
////////////#:#X:X::X:::::#//          ----------------
/////////////##:##########///          ----------------
Op mode: 3 Rot=0 MovF=1
Op mode: 3 Rot=0 MovF=1
Moving forward mode starts
travelledDist=2
curPos=(4,13) 
 Moving forward mode ends
Op mode: 3 Rot=0 MovF=0
Go to junction mode starts
Right=0
Left=0
Go to junction mode ends
Op mode: 3 Rot=0 MovF=1
Op mode: 3 Rot=0 MovF=1

102
cPos=(4,13)
cJ=3, JCon=14, lJDir=1, nJs=4, nJl=13
cDir=1, nDir=1
travelledDist=2
2: 2. 1: 1. 0: 0. 
/////////////////////////////          -3-----------2--
/////////////#///####/###////          3-4-------------
////////////#:###::::#:::#///          -4-3------------
////////////#X::####:###X:#//          --3-3-----------
////////////#O#::X::X:##:#///          ---3-5----------
////////////#:###.###X::X#///          ----5-3---------
////////////#X::#///#:##:#///          -----3-2--------
////////////#:#:#///.X####///          ------2-3-2-----
////////////#:#:#///#::X::#//          -------3-2------
////////////#X::#////##.#:#//          --------2-------
////////////#:##////////#:#//          -------2---3----
////////////#:#/////////#:#//          ----------3-13---
////////////#:##////////#:#//          -----------13-3--
////////////#X::#.##.####:#//          2-----------3---
////////////#:#X:X::X:::::#//          ----------------
/////////////##:##########///          ----------------
Op mode: 3 Rot=0 MovF=1
Op mode: 3 Rot=0 MovF=1
Moving forward mode starts
travelledDist=3
curPos=(3,13) 
 Moving forward mode ends
Op mode: 3 Rot=0 MovF=0
Go to junction mode starts
Right=1
ROT=-1
curJ=nJs!!
Down=0, Left=0, Right=0, Up=0
Tester=0, UnexSq=0, 0=01, 1=01, 2=01, 3=01
 14
Decided nJl=13
Go to junction mode ends
Op mode: 2 Rot=1 MovF=0
Op mode: 2 Rot=1 MovF=0

103
cPos=(3,13)
cJ=4, JCon=14, lJDir=1, nJs=5, nJl=13
cDir=1, nDir=1
travelledDist=0
2: 2. 1: 1. 0: 0. 
/////////////////////////////          -3-----------2--
/////////////#///####/###////          3-4-------------
////////////#:###::::#:::#///          -4-3------------
////////////#O::####:###X:#//          --3-3-----------
////////////#:#::X::X:##:#///          ---3-5----------
////////////#:###.###X::X#///          ----5-3---------
////////////#X::#///#:##:#///          -----3-2--------
////////////#:#:#///.X####///          ------2-3-2-----
////////////#:#:#///#::X::#//          -------3-2------
////////////#X::#////##.#:#//          --------2-------
////////////#:##////////#:#//          -------2---3----
////////////#:#/////////#:#//          ----------3-13---
////////////#:##////////#:#//          -----------13-3--
////////////#X::#.##.####:#//          2-----------3---
////////////#:#X:X::X:::::#//          ----------------
/////////////##:##########///          ----------------
Op mode: 2 Rot=1 MovF=0
Rotating mode starts
curDir=1 
 Rotating mode ends
Op mode: 2 Rot=0 MovF=0
Op mode: 2 Rot=0 MovF=0
Op mode: 2 Rot=0 MovF=0
Far junction mode starts
Destination decided, nJl=13
Åk mot nJs
nDir=1, cJ=4, nJs=5
nDir=0, cJ=4, nJs=5
Far junction mode ends
Op mode: 3 Rot=1 MovF=1

104
cPos=(3,13)
cJ=4, JCon=14, lJDir=1, nJs=5, nJl=13
cDir=1, nDir=0
travelledDist=0
2: 2. 1: 1. 0: 0. 
/////////////////////////////          -3-----------2--
/////////////#///####/###////          3-4-------------
////////////#:###::::#:::#///          -4-3------------
////////////#O::####:###X:#//          --3-3-----------
////////////#:#::X::X:##:#///          ---3-5----------
////////////#:###.###X::X#///          ----5-3---------
////////////#X::#///#:##:#///          -----3-2--------
////////////#:#:#///.X####///          ------2-3-2-----
////////////#:#:#///#::X::#//          -------3-2------
////////////#X::#////##.#:#//          --------2-------
////////////#:##////////#:#//          -------2---3----
////////////#:#/////////#:#//          ----------3-13---
////////////#:##////////#:#//          -----------13-3--
////////////#X::#.##.####:#//          2-----------3---
////////////#:#X:X::X:::::#//          ----------------
/////////////##:##########///          ----------------
Op mode: 3 Rot=1 MovF=1
Rotating mode starts
curDir=0 
 Rotating mode ends
Op mode: 3 Rot=0 MovF=1
Moving forward mode starts
travelledDist=1
curPos=(3,14) 
 Moving forward mode ends
Op mode: 3 Rot=0 MovF=0
Go to junction mode starts
Down=0
Up=0
Go to junction mode ends
Op mode: 3 Rot=0 MovF=1
Op mode: 3 Rot=0 MovF=1

105
cPos=(3,14)
cJ=4, JCon=14, lJDir=0, nJs=5, nJl=13
cDir=0, nDir=0
travelledDist=1
1: 1. 0: 0. 3: 3. 
/////////////////////////////          -3-----------2--
/////////////#///####/###////          3-4-------------
////////////#:###::::#:::#///          -4-3------------
////////////#XO:####:###X:#//          --3-3-----------
////////////#:#::X::X:##:#///          ---3-5----------
////////////#:###.###X::X#///          ----5-3---------
////////////#X::#///#:##:#///          -----3-2--------
////////////#:#:#///.X####///          ------2-3-2-----
////////////#:#:#///#::X::#//          -------3-2------
////////////#X::#////##.#:#//          --------2-------
////////////#:##////////#:#//          -------2---3----
////////////#:#/////////#:#//          ----------3-13---
////////////#:##////////#:#//          -----------13-3--
////////////#X::#.##.####:#//          2-----------3---
////////////#:#X:X::X:::::#//          ----------------
/////////////##:##########///          ----------------
Op mode: 3 Rot=0 MovF=1
Op mode: 3 Rot=0 MovF=1
Moving forward mode starts
travelledDist=2
curPos=(3,15) 
 Moving forward mode ends
Op mode: 3 Rot=0 MovF=0
Go to junction mode starts
Down=1
ROT=-1
Go to junction mode ends
Op mode: 3 Rot=1 MovF=1
Op mode: 3 Rot=1 MovF=1

106
cPos=(3,15)
cJ=4, JCon=14, lJDir=0, nJs=5, nJl=13
cDir=0, nDir=3
travelledDist=2
1: 1. 0: 0. 3: 3. 
/////////////////////////////          -3-----------2--
/////////////#///####/###////          3-4-------------
////////////#:###::::#:::#///          -4-3------------
////////////#X:O####:###X:#//          --3-3-----------
////////////#:#::X::X:##:#///          ---3-5----------
////////////#:###.###X::X#///          ----5-3---------
////////////#X::#///#:##:#///          -----3-2--------
////////////#:#:#///.X####///          ------2-3-2-----
////////////#:#:#///#::X::#//          -------3-2------
////////////#X::#////##.#:#//          --------2-------
////////////#:##////////#:#//          -------2---3----
////////////#:#/////////#:#//          ----------3-13---
////////////#:##////////#:#//          -----------13-3--
////////////#X::#.##.####:#//          2-----------3---
////////////#:#X:X::X:::::#//          ----------------
/////////////##:##########///          ----------------
Op mode: 3 Rot=1 MovF=1
Rotating mode starts
curDir=3 
 Rotating mode ends
Op mode: 3 Rot=0 MovF=1
Moving forward mode starts
travelledDist=3
curPos=(4,15) 
 Moving forward mode ends
Op mode: 3 Rot=0 MovF=0
Go to junction mode starts
Left=0
Right=1
ROT=1
Go to junction mode ends
Op mode: 3 Rot=1 MovF=1
Op mode: 3 Rot=1 MovF=1

107
cPos=(4,15)
cJ=4, JCon=14, lJDir=0, nJs=5, nJl=13
cDir=3, nDir=0
travelledDist=3
0: 0. 3: 3. 2: 2. 
/////////////////////////////          -3-----------2--
/////////////#///####/###////          3-4-------------
////////////#:###::::#:::#///          -4-3------------
////////////#X::####:###X:#//          --3-3-----------
////////////#:#O:X::X:##:#///          ---3-5----------
////////////#:###.###X::X#///          ----5-3---------
////////////#X::#///#:##:#///          -----3-2--------
////////////#:#:#///.X####///          ------2-3-2-----
////////////#:#:#///#::X::#//          -------3-2------
////////////#X::#////##.#:#//          --------2-------
////////////#:##////////#:#//          -------2---3----
////////////#:#/////////#:#//          ----------3-13---
////////////#:##////////#:#//          -----------13-3--
////////////#X::#.##.####:#//          2-----------3---
////////////#:#X:X::X:::::#//          ----------------
/////////////##:##########///          ----------------
Op mode: 3 Rot=1 MovF=1
Rotating mode starts
curDir=0 
 Rotating mode ends
Op mode: 3 Rot=0 MovF=1
Moving forward mode starts
travelledDist=4
curPos=(4,16) 
 Moving forward mode ends
Op mode: 3 Rot=0 MovF=0
Go to junction mode starts
Down=0
Up=0
Go to junction mode ends
Op mode: 3 Rot=0 MovF=1
Op mode: 3 Rot=0 MovF=1

108
cPos=(4,16)
cJ=4, JCon=14, lJDir=0, nJs=5, nJl=13
cDir=0, nDir=0
travelledDist=4
1: 1. 0: 0. 3: 3. 
/////////////////////////////          -3-----------2--
/////////////#///####/###////          3-4-------------
////////////#:###::::#:::#///          -4-3------------
////////////#X::####:###X:#//          --3-3-----------
////////////#:#:OX::X:##:#///          ---3-5----------
////////////#:###.###X::X#///          ----5-3---------
////////////#X::#///#:##:#///          -----3-2--------
////////////#:#:#///.X####///          ------2-3-2-----
////////////#:#:#///#::X::#//          -------3-2------
////////////#X::#////##.#:#//          --------2-------
////////////#:##////////#:#//          -------2---3----
////////////#:#/////////#:#//          ----------3-13---
////////////#:##////////#:#//          -----------13-3--
////////////#X::#.##.####:#//          2-----------3---
////////////#:#X:X::X:::::#//          ----------------
/////////////##:##########///          ----------------
Op mode: 3 Rot=0 MovF=1
Op mode: 3 Rot=0 MovF=1
Moving forward mode starts
travelledDist=5
curPos=(4,17) 
 Moving forward mode ends
Op mode: 3 Rot=0 MovF=0
Go to junction mode starts
Down=1
ROT=-1
curJ=nJs!!
Down=1, Left=0, Right=0, Up=0
Tester=1, UnexSq=1, 0=01, 1=01, 2=01, 3=01
UnexSq exist!!
Go to junction mode ends
Op mode: 0 Rot=0 MovF=0
Op mode: 0 Rot=0 MovF=0

109
cPos=(4,17)
cJ=5, JCon=14, lJDir=0, nJs=5, nJl=13
cDir=0, nDir=3
travelledDist=0
1: 1. 0: 0. 3: 3. 
/////////////////////////////          -3-----------2--
/////////////#///####/###////          3-4-------------
////////////#:###::::#:::#///          -4-3------------
////////////#X::####:###X:#//          --3-3-----------
////////////#:#::O::X:##:#///          ---3-5----------
////////////#:###.###X::X#///          ----5-3---------
////////////#X::#///#:##:#///          -----3-2--------
////////////#:#:#///.X####///          ------2-3-2-----
////////////#:#:#///#::X::#//          -------3-2------
////////////#X::#////##.#:#//          --------2-------
////////////#:##////////#:#//          -------2---3----
////////////#:#/////////#:#//          ----------3-13---
////////////#:##////////#:#//          -----------13-3--
////////////#X::#.##.####:#//          2-----------3---
////////////#:#X:X::X:::::#//          ----------------
/////////////##:##########///          ----------------
Normal mode start
Down=1, Left=0, Right=0, Up=0
Visited=1, junction=1
Entered visited junction
Array=0, j1=5, j2=5
Array=0, j1=5, j2=5
J#=5, right=6, up=0, left=4, down=0
J#=5, right=6, up=0, left=4, down=0
Sent dir=2
Tester=1, UnexSq=1, 0=01, 1=01, 2=01, 3=01
Has UnexSQ=1
Normal mode end
Op mode: 0 Rot=1 MovF=1
Rotating mode starts
curDir=3 
 Rotating mode ends
Op mode: 0 Rot=0 MovF=1
Moving forward mode starts
travelledDist=1
curPos=(5,17) 
 Moving forward mode ends
Op mode: 0 Rot=0 MovF=0
Op mode: 0 Rot=0 MovF=0
Op mode: 0 Rot=0 MovF=0

110
cPos=(5,17)
cJ=5, JCon=14, lJDir=3, nJs=5, nJl=13
cDir=3, nDir=3
travelledDist=1
0: 0. 3: 3. 2: 2. 
/////////////////////////////          -3-----------2--
/////////////#///####/###////          3-4-------------
////////////#:###::::#:::#///          -4-3------------
////////////#X::####:###X:#//          --3-3-----------
////////////#:#::X::X:##:#///          ---3-5----------
////////////#:###O###X::X#///          ----5-3---------
////////////#X::#.//#:##:#///          -----3-2--------
////////////#:#:#///.X####///          ------2-3-2-----
////////////#:#:#///#::X::#//          -------3-2------
////////////#X::#////##.#:#//          --------2-------
////////////#:##////////#:#//          -------2---3----
////////////#:#/////////#:#//          ----------3-13---
////////////#:##////////#:#//          -----------13-3--
////////////#X::#.##.####:#//          2-----------3---
////////////#:#X:X::X:::::#//          ----------------
/////////////##:##########///          ----------------
Normal mode start
Down=1, Left=0, Right=0, Up=1
Visited=1, junction=0
Entered new square
Normal mode end
Op mode: 0 Rot=0 MovF=1
Op mode: 0 Rot=0 MovF=1
Moving forward mode starts
travelledDist=2
curPos=(6,17) 
 Moving forward mode ends
Op mode: 0 Rot=0 MovF=0
Op mode: 0 Rot=0 MovF=0
Op mode: 0 Rot=0 MovF=0

111
cPos=(6,17)
cJ=5, JCon=14, lJDir=3, nJs=5, nJl=13
cDir=3, nDir=3
travelledDist=2
0: 0. 3: 3. 2: 2. 
/////////////////////////////          -3-----------2--
/////////////#///####/###////          3-4-------------
////////////#:###::::#:::#///          -4-3------------
////////////#X::####:###X:#//          --3-3-----------
////////////#:#::X::X:##:#///          ---3-5----------
////////////#:###:###X::X#///          ----5-3---------
////////////#X::#O#/#:##:#///          -----3-2--------
////////////#:#:#.//.X####///          ------2-3-2-----
////////////#:#:#///#::X::#//          -------3-2------
////////////#X::#////##.#:#//          --------2-------
////////////#:##////////#:#//          -------2---3----
////////////#:#/////////#:#//          ----------3-13---
////////////#:##////////#:#//          -----------13-3--
////////////#X::#.##.####:#//          2-----------3---
////////////#:#X:X::X:::::#//          ----------------
/////////////##:##########///          ----------------
Normal mode start
Down=1, Left=0, Right=0, Up=0
Visited=1, junction=0
Entered new square
Normal mode end
Op mode: 0 Rot=0 MovF=1
Op mode: 0 Rot=0 MovF=1
Moving forward mode starts
travelledDist=3
curPos=(7,17) 
 Moving forward mode ends
Op mode: 0 Rot=0 MovF=0
Op mode: 0 Rot=0 MovF=0
Op mode: 0 Rot=0 MovF=0

112
cPos=(7,17)
cJ=5, JCon=14, lJDir=3, nJs=5, nJl=13
cDir=3, nDir=3
travelledDist=3
0: 0. 3: 3. 2: 2. 
/////////////////////////////          -3-----------2--
/////////////#///####/###////          3-4-------------
////////////#:###::::#:::#///          -4-3------------
////////////#X::####:###X:#//          --3-3-----------
////////////#:#::X::X:##:#///          ---3-5----------
////////////#:###:###X::X#///          ----5-3---------
////////////#X::#:#/#:##:#///          -----3-2--------
////////////#:#:#O./.X####///          ------2-3-2-----
////////////#:#:##//#::X::#//          -------3-2------
////////////#X::#////##.#:#//          --------2-------
////////////#:##////////#:#//          -------2---3----
////////////#:#/////////#:#//          ----------3-13---
////////////#:##////////#:#//          -----------13-3--
////////////#X::#.##.####:#//          2-----------3---
////////////#:#X:X::X:::::#//          ----------------
/////////////##:##########///          ----------------
Normal mode start
Down=0, Left=0, Right=1, Up=0
Visited=1, junction=0
Entered new square
Normal mode end
Op mode: 0 Rot=1 MovF=1
Rotating mode starts
curDir=0 
 Rotating mode ends
Op mode: 0 Rot=0 MovF=1
Moving forward mode starts
travelledDist=4
curPos=(7,18) 
 Moving forward mode ends
Op mode: 0 Rot=0 MovF=0
Op mode: 0 Rot=0 MovF=0
Op mode: 0 Rot=0 MovF=0

113
cPos=(7,18)
cJ=5, JCon=14, lJDir=3, nJs=5, nJl=13
cDir=0, nDir=0
travelledDist=4
1: 1. 0: 0. 3: 3. 
/////////////////////////////          -3-----------2--
/////////////#///####/###////          3-4-------------
////////////#:###::::#:::#///          -4-3------------
////////////#X::####:###X:#//          --3-3-----------
////////////#:#::X::X:##:#///          ---3-5----------
////////////#:###:###X::X#///          ----5-3---------
////////////#X::#:#/#:##:#///          -----3-2--------
////////////#:#:#:O..X####///          ------2-3-2-----
////////////#:#:###/#::X::#//          -------3-2------
////////////#X::#////##.#:#//          --------2-------
////////////#:##////////#:#//          -------2---3----
////////////#:#/////////#:#//          ----------3-13---
////////////#:##////////#:#//          -----------13-3--
////////////#X::#.##.####:#//          2-----------3---
////////////#:#X:X::X:::::#//          ----------------
/////////////##:##########///          ----------------
Normal mode start
Down=0, Left=0, Right=1, Up=0
Visited=1, junction=0
Entered new square
Normal mode end
Op mode: 0 Rot=0 MovF=1
Op mode: 0 Rot=0 MovF=1
Moving forward mode starts
travelledDist=5
curPos=(7,19) 
 Moving forward mode ends
Op mode: 0 Rot=0 MovF=0
Op mode: 0 Rot=0 MovF=0
Op mode: 0 Rot=0 MovF=0

114
cPos=(7,19)
cJ=5, JCon=14, lJDir=3, nJs=5, nJl=13
cDir=0, nDir=0
travelledDist=5
1: 1. 0: 0. 3: 3. 
/////////////////////////////          -3-----------2--
/////////////#///####/###////          3-4-------------
////////////#:###::::#:::#///          -4-3------------
////////////#X::####:###X:#//          --3-3-----------
////////////#:#::X::X:##:#///          ---3-5----------
////////////#:###:###X::X#///          ----5-3---------
////////////#X::#:###:##:#///          -----3-2--------
////////////#:#:#::O.X####///          ------2-3-2-----
////////////#:#:#####::X::#//          -------3-2------
////////////#X::#////##.#:#//          --------2-------
////////////#:##////////#:#//          -------2---3----
////////////#:#/////////#:#//          ----------3-13---
////////////#:##////////#:#//          -----------13-3--
////////////#X::#.##.####:#//          2-----------3---
////////////#:#X:X::X:::::#//          ----------------
/////////////##:##########///          ----------------
Normal mode start
Down=0, Left=0, Right=1, Up=0
Visited=1, junction=0
Entered new square
Normal mode end
Op mode: 0 Rot=0 MovF=1
Op mode: 0 Rot=0 MovF=1
Moving forward mode starts
travelledDist=6
curPos=(7,20) 
 Moving forward mode ends
Op mode: 0 Rot=0 MovF=0
Op mode: 0 Rot=0 MovF=0
Op mode: 0 Rot=0 MovF=0

115
cPos=(7,20)
cJ=5, JCon=14, lJDir=3, nJs=5, nJl=13
cDir=0, nDir=0
travelledDist=6
1: 1. 0: 0. 3: 3. 
/////////////////////////////          -3-----------2--
/////////////#///####/###////          3-4-------------
////////////#:###::::#:::#///          -4-3------------
////////////#X::####:###X:#//          --3-3-----------
////////////#:#::X::X:##:#///          ---3-5----------
////////////#:###:###X::X#///          ----5-3---------
////////////#X::#:###:##:#///          -----3-2--------
////////////#:#:#:::OX####///          ------2-3-2-----
////////////#:#:#####::X::#//          -------3-2------
////////////#X::#////##.#:#//          --------2-------
////////////#:##////////#:#//          -------2---3----
////////////#:#/////////#:#//          ----------3-13---
////////////#:##////////#:#//          -----------13-3--
////////////#X::#.##.####:#//          2-----------3---
////////////#:#X:X::X:::::#//          ----------------
/////////////##:##########///          ----------------
Normal mode start
Down=0, Left=0, Right=1, Up=0
Visited=1, junction=0
Entered new square
Normal mode end
Op mode: 0 Rot=0 MovF=1
Op mode: 0 Rot=0 MovF=1
Moving forward mode starts
travelledDist=7
curPos=(7,21) 
 Moving forward mode ends
Op mode: 0 Rot=0 MovF=0
Op mode: 0 Rot=0 MovF=0
Op mode: 0 Rot=0 MovF=0

116
cPos=(7,21)
cJ=5, JCon=14, lJDir=3, nJs=5, nJl=13
cDir=0, nDir=0
travelledDist=7
1: 1. 0: 0. 3: 3. 
/////////////////////////////          -3-----------2--
/////////////#///####/###////          3-4-------------
////////////#:###::::#:::#///          -4-3------------
////////////#X::####:###X:#//          --3-3-----------
////////////#:#::X::X:##:#///          ---3-5----------
////////////#:###:###X::X#///          ----5-3---------
////////////#X::#:###:##:#///          -----3-2--------
////////////#:#:#::::O####///          ------2-3-2-----
////////////#:#:#####::X::#//          -------3-2------
////////////#X::#////##.#:#//          --------2-------
////////////#:##////////#:#//          -------2---3----
////////////#:#/////////#:#//          ----------3-13---
////////////#:##////////#:#//          -----------13-3--
////////////#X::#.##.####:#//          2-----------3---
////////////#:#X:X::X:::::#//          ----------------
/////////////##:##########///          ----------------
Normal mode start
Down=0, Left=0, Right=0, Up=0
Visited=1, junction=1
Entered visited junction
Array=0, j1=5, j2=10
1337
j1=10, j2=5, direction=2,Added left
j1=5, j2=10, direction=3,Added down
J#=5, right=6, up=0, left=4, down=10
J#=10, right=0, up=7, left=5, down=11
Sent dir=2
Tester=0, UnexSq=0, 0=01, 1=01, 2=01, 3=01
Fully explored junction
WTF CurJunction = 10
 14
Decided nJl=13
Op mode: 2 Rot=0 MovF=0
Op mode: 2 Rot=0 MovF=0
Op mode: 2 Rot=0 MovF=0
Far junction mode starts
Destination decided, nJl=13
Åk mot nJs
nDir=1, cJ=10, nJs=11
nDir=3, cJ=10, nJs=11
Far junction mode ends
Op mode: 3 Rot=1 MovF=1

117
cPos=(7,21)
cJ=10, JCon=14, lJDir=3, nJs=11, nJl=13
cDir=0, nDir=3
travelledDist=0
1: 1. 0: 0. 3: 3. 
/////////////////////////////          -3-----------2--
/////////////#///####/###////          3-4-------------
////////////#:###::::#:::#///          -4-3------------
////////////#X::####:###X:#//          --3-3-----------
////////////#:#::X::X:##:#///          ---3-5----------
////////////#:###:###X::X#///          ----5-3---7-----
////////////#X::#:###:##:#///          -----3-2--------
////////////#:#:#::::O####///          ------2-3-2-----
////////////#:#:#####::X::#//          -------3-2------
////////////#X::#////##.#:#//          --------2-------
////////////#:##////////#:#//          -----7-2---3----
////////////#:#/////////#:#//          ----------3-13---
////////////#:##////////#:#//          -----------13-3--
////////////#X::#.##.####:#//          2-----------3---
////////////#:#X:X::X:::::#//          ----------------
/////////////##:##########///          ----------------
Op mode: 3 Rot=1 MovF=1
Rotating mode starts
curDir=3 
 Rotating mode ends
Op mode: 3 Rot=0 MovF=1
Moving forward mode starts
travelledDist=1
curPos=(8,21) 
 Moving forward mode ends
Op mode: 3 Rot=0 MovF=0
Go to junction mode starts
Left=0
Right=1
ROT=1
Go to junction mode ends
Op mode: 3 Rot=1 MovF=1
Op mode: 3 Rot=1 MovF=1

118
cPos=(8,21)
cJ=10, JCon=14, lJDir=3, nJs=11, nJl=13
cDir=3, nDir=0
travelledDist=1
0: 0. 3: 3. 2: 2. 
/////////////////////////////          -3-----------2--
/////////////#///####/###////          3-4-------------
////////////#:###::::#:::#///          -4-3------------
////////////#X::####:###X:#//          --3-3-----------
////////////#:#::X::X:##:#///          ---3-5----------
////////////#:###:###X::X#///          ----5-3---7-----
////////////#X::#:###:##:#///          -----3-2--------
////////////#:#:#::::X####///          ------2-3-2-----
////////////#:#:#####O:X::#//          -------3-2------
////////////#X::#////##.#:#//          --------2-------
////////////#:##////////#:#//          -----7-2---3----
////////////#:#/////////#:#//          ----------3-13---
////////////#:##////////#:#//          -----------13-3--
////////////#X::#.##.####:#//          2-----------3---
////////////#:#X:X::X:::::#//          ----------------
/////////////##:##########///          ----------------
Op mode: 3 Rot=1 MovF=1
Rotating mode starts
curDir=0 
 Rotating mode ends
Op mode: 3 Rot=0 MovF=1
Moving forward mode starts
travelledDist=2
curPos=(8,22) 
 Moving forward mode ends
Op mode: 3 Rot=0 MovF=0
Go to junction mode starts
Down=0
Up=0
Go to junction mode ends
Op mode: 3 Rot=0 MovF=1
Op mode: 3 Rot=0 MovF=1

119
cPos=(8,22)
cJ=10, JCon=14, lJDir=3, nJs=11, nJl=13
cDir=0, nDir=0
travelledDist=2
1: 1. 0: 0. 3: 3. 
/////////////////////////////          -3-----------2--
/////////////#///####/###////          3-4-------------
////////////#:###::::#:::#///          -4-3------------
////////////#X::####:###X:#//          --3-3-----------
////////////#:#::X::X:##:#///          ---3-5----------
////////////#:###:###X::X#///          ----5-3---7-----
////////////#X::#:###:##:#///          -----3-2--------
////////////#:#:#::::X####///          ------2-3-2-----
////////////#:#:#####:OX::#//          -------3-2------
////////////#X::#////##.#:#//          --------2-------
////////////#:##////////#:#//          -----7-2---3----
////////////#:#/////////#:#//          ----------3-13---
////////////#:##////////#:#//          -----------13-3--
////////////#X::#.##.####:#//          2-----------3---
////////////#:#X:X::X:::::#//          ----------------
/////////////##:##########///          ----------------
Op mode: 3 Rot=0 MovF=1
Op mode: 3 Rot=0 MovF=1
Moving forward mode starts
travelledDist=3
curPos=(8,23) 
 Moving forward mode ends
Op mode: 3 Rot=0 MovF=0
Go to junction mode starts
Down=1
ROT=-1
curJ=nJs!!
Down=1, Left=0, Right=0, Up=0
Tester=1, UnexSq=1, 0=01, 1=01, 2=01, 3=01
UnexSq exist!!
Go to junction mode ends
Op mode: 0 Rot=0 MovF=0
Op mode: 0 Rot=0 MovF=0

120
cPos=(8,23)
cJ=11, JCon=14, lJDir=3, nJs=11, nJl=13
cDir=0, nDir=3
travelledDist=0
1: 1. 0: 0. 3: 3. 
/////////////////////////////          -3-----------2--
/////////////#///####/###////          3-4-------------
////////////#:###::::#:::#///          -4-3------------
////////////#X::####:###X:#//          --3-3-----------
////////////#:#::X::X:##:#///          ---3-5----------
////////////#:###:###X::X#///          ----5-3---7-----
////////////#X::#:###:##:#///          -----3-2--------
////////////#:#:#::::X####///          ------2-3-2-----
////////////#:#:#####::O::#//          -------3-2------
////////////#X::#////##.#:#//          --------2-------
////////////#:##////////#:#//          -----7-2---3----
////////////#:#/////////#:#//          ----------3-13---
////////////#:##////////#:#//          -----------13-3--
////////////#X::#.##.####:#//          2-----------3---
////////////#:#X:X::X:::::#//          ----------------
/////////////##:##########///          ----------------
Normal mode start
Down=1, Left=0, Right=0, Up=0
Visited=1, junction=1
Entered visited junction
Array=0, j1=11, j2=11
Array=0, j1=11, j2=11
J#=11, right=12, up=0, left=10, down=0
J#=11, right=12, up=0, left=10, down=0
Sent dir=2
Tester=1, UnexSq=1, 0=01, 1=01, 2=01, 3=01
Has UnexSQ=1
Normal mode end
Op mode: 0 Rot=1 MovF=1
Rotating mode starts
curDir=3 
 Rotating mode ends
Op mode: 0 Rot=0 MovF=1
Moving forward mode starts
travelledDist=1
curPos=(9,23) 
 Moving forward mode ends
Op mode: 0 Rot=0 MovF=0
Op mode: 0 Rot=0 MovF=0
Op mode: 0 Rot=0 MovF=0

121
cPos=(9,23)
cJ=11, JCon=14, lJDir=3, nJs=11, nJl=13
cDir=3, nDir=3
travelledDist=1
0: 0. 3: 3. 2: 2. 
/////////////////////////////          -3-----------2--
/////////////#///####/###////          3-4-------------
////////////#:###::::#:::#///          -4-3------------
////////////#X::####:###X:#//          --3-3-----------
////////////#:#::X::X:##:#///          ---3-5----------
////////////#:###:###X::X#///          ----5-3---7-----
////////////#X::#:###:##:#///          -----3-2--------
////////////#:#:#::::X####///          ------2-3-2-----
////////////#:#:#####::X::#//          -------3-2------
////////////#X::#////##O#:#//          --------2-------
////////////#:##///////.#:#//          -----7-2---3----
////////////#:#/////////#:#//          ----------3-13---
////////////#:##////////#:#//          -----------13-3--
////////////#X::#.##.####:#//          2-----------3---
////////////#:#X:X::X:::::#//          ----------------
/////////////##:##########///          ----------------
Normal mode start
Down=1, Left=0, Right=0, Up=1
Visited=1, junction=0
Entered new square
Normal mode end
Op mode: 0 Rot=0 MovF=1
Op mode: 0 Rot=0 MovF=1
Moving forward mode starts
travelledDist=2
curPos=(10,23) 
 Moving forward mode ends
Op mode: 0 Rot=0 MovF=0
Op mode: 0 Rot=0 MovF=0
Op mode: 0 Rot=0 MovF=0

122
cPos=(10,23)
cJ=11, JCon=14, lJDir=3, nJs=11, nJl=13
cDir=3, nDir=3
travelledDist=2
0: 0. 3: 3. 2: 2. 
/////////////////////////////          -3-----------2--
/////////////#///####/###////          3-4-------------
////////////#:###::::#:::#///          -4-3------------
////////////#X::####:###X:#//          --3-3-----------
////////////#:#::X::X:##:#///          ---3-5----------
////////////#:###:###X::X#///          ----5-3---7-----
////////////#X::#:###:##:#///          -----3-2--------
////////////#:#:#::::X####///          ------2-3-2-----
////////////#:#:#####::X::#//          -------3-2------
////////////#X::#////##:#:#//          --------2-------
////////////#:##//////#O#:#//          -----7-2---3----
////////////#:#////////.#:#//          ----------3-13---
////////////#:##////////#:#//          -----------13-3--
////////////#X::#.##.####:#//          2-----------3---
////////////#:#X:X::X:::::#//          ----------------
/////////////##:##########///          ----------------
Normal mode start
Down=1, Left=0, Right=0, Up=0
Visited=1, junction=0
Entered new square
Normal mode end
Op mode: 0 Rot=0 MovF=1
Op mode: 0 Rot=0 MovF=1
Moving forward mode starts
travelledDist=3
curPos=(11,23) 
 Moving forward mode ends
Op mode: 0 Rot=0 MovF=0
Op mode: 0 Rot=0 MovF=0
Op mode: 0 Rot=0 MovF=0

123
cPos=(11,23)
cJ=11, JCon=14, lJDir=3, nJs=11, nJl=13
cDir=3, nDir=3
travelledDist=3
0: 0. 3: 3. 2: 2. 
/////////////////////////////          -3-----------2--
/////////////#///####/###////          3-4-------------
////////////#:###::::#:::#///          -4-3------------
////////////#X::####:###X:#//          --3-3-----------
////////////#:#::X::X:##:#///          ---3-5----------
////////////#:###:###X::X#///          ----5-3---7-----
////////////#X::#:###:##:#///          -----3-2--------
////////////#:#:#::::X####///          ------2-3-2-----
////////////#:#:#####::X::#//          -------3-2------
////////////#X::#////##:#:#//          --------2-------
////////////#:##//////#:#:#//          -----7-2---3----
////////////#:#///////.O#:#//          ----------3-13---
////////////#:##///////##:#//          -----------13-3--
////////////#X::#.##.####:#//          2-----------3---
////////////#:#X:X::X:::::#//          ----------------
/////////////##:##########///          ----------------
Normal mode start
Down=0, Left=1, Right=0, Up=0
Visited=1, junction=0
Entered new square
Normal mode end
Op mode: 0 Rot=1 MovF=1
Rotating mode starts
curDir=2 
 Rotating mode ends
Op mode: 0 Rot=0 MovF=1
Moving forward mode starts
travelledDist=4
curPos=(11,22) 
 Moving forward mode ends
Op mode: 0 Rot=0 MovF=0
Op mode: 0 Rot=0 MovF=0
Op mode: 0 Rot=0 MovF=0

124
cPos=(11,22)
cJ=11, JCon=14, lJDir=3, nJs=11, nJl=13
cDir=2, nDir=2
travelledDist=4
3: 3. 2: 2. 1: 1. 
/////////////////////////////          -3-----------2--
/////////////#///####/###////          3-4-------------
////////////#:###::::#:::#///          -4-3------------
////////////#X::####:###X:#//          --3-3-----------
////////////#:#::X::X:##:#///          ---3-5----------
////////////#:###:###X::X#///          ----5-3---7-----
////////////#X::#:###:##:#///          -----3-2--------
////////////#:#:#::::X####///          ------2-3-2-----
////////////#:#:#####::X::#//          -------3-2------
////////////#X::#////##:#:#//          --------2-------
////////////#:##//////#:#:#//          -----7-2---3----
////////////#:#//////.O:#:#//          ----------3-13---
////////////#:##//////###:#//          -----------13-3--
////////////#X::#.##.####:#//          2-----------3---
////////////#:#X:X::X:::::#//          ----------------
/////////////##:##########///          ----------------
Normal mode start
Down=0, Left=1, Right=0, Up=0
Visited=1, junction=0
Entered new square
Normal mode end
Op mode: 0 Rot=0 MovF=1
Op mode: 0 Rot=0 MovF=1
Moving forward mode starts
travelledDist=5
curPos=(11,21) 
 Moving forward mode ends
Op mode: 0 Rot=0 MovF=0
Op mode: 0 Rot=0 MovF=0
Op mode: 0 Rot=0 MovF=0

125
cPos=(11,21)
cJ=11, JCon=14, lJDir=3, nJs=11, nJl=13
cDir=2, nDir=2
travelledDist=5
3: 3. 2: 2. 1: 1. 
/////////////////////////////          -3-----------2--
/////////////#///####/###////          3-4-------------
////////////#:###::::#:::#///          -4-3------------
////////////#X::####:###X:#//          --3-3-----------
////////////#:#::X::X:##:#///          ---3-5----------
////////////#:###:###X::X#///          ----5-3---7-----
////////////#X::#:###:##:#///          -----3-2--------
////////////#:#:#::::X####///          ------2-3-2-----
////////////#:#:#####::X::#//          -------3-2------
////////////#X::#////##:#:#//          --------2-------
////////////#:##/////##:#:#//          -----7-2---3----
////////////#:#/////.O::#:#//          ----------3-13---
////////////#:##/////####:#//          -----------13-3--
////////////#X::#.##.####:#//          2-----------3---
////////////#:#X:X::X:::::#//          ----------------
/////////////##:##########///          ----------------
Normal mode start
Down=0, Left=1, Right=0, Up=0
Visited=1, junction=0
Entered new square
Normal mode end
Op mode: 0 Rot=0 MovF=1
Op mode: 0 Rot=0 MovF=1
Moving forward mode starts
travelledDist=6
curPos=(11,20) 
 Moving forward mode ends
Op mode: 0 Rot=0 MovF=0
Op mode: 0 Rot=0 MovF=0
Op mode: 0 Rot=0 MovF=0

126
cPos=(11,20)
cJ=11, JCon=14, lJDir=3, nJs=11, nJl=13
cDir=2, nDir=2
travelledDist=6
3: 3. 2: 2. 1: 1. 
/////////////////////////////          -3-----------2--
/////////////#///####/###////          3-4-------------
////////////#:###::::#:::#///          -4-3------------
////////////#X::####:###X:#//          --3-3-----------
////////////#:#::X::X:##:#///          ---3-5----------
////////////#:###:###X::X#///          ----5-3---7-----
////////////#X::#:###:##:#///          -----3-2--------
////////////#:#:#::::X####///          ------2-3-2-----
////////////#:#:#####::X::#//          -------3-2------
////////////#X::#////##:#:#//          --------2-------
////////////#:##////###:#:#//          -----7-2---3----
////////////#:#////.O:::#:#//          ----------3-13---
////////////#:##////.####:#//          -----------13-3--
////////////#X::#.##.####:#//          2-----------3---
////////////#:#X:X::X:::::#//          ----------------
/////////////##:##########///          ----------------
Normal mode start
Down=1, Left=1, Right=0, Up=0
Visited=1, junction=0
Entered new square
Has unex roads, UnexSQ=2
Array=0, j1=11, j2=14
1337
j1=11, j2=14, direction=3,Added down
j1=14, j2=11, direction=0,Added right
J#=11, right=12, up=0, left=10, down=14
J#=14, right=11, up=0, left=0, down=0
Normal mode end
Op mode: 0 Rot=1 MovF=1
Rotating mode starts
curDir=3 
 Rotating mode ends
Op mode: 0 Rot=0 MovF=1
Moving forward mode starts
travelledDist=1
curPos=(12,20) 
 Moving forward mode ends
Op mode: 0 Rot=0 MovF=0
Op mode: 0 Rot=0 MovF=0
Op mode: 0 Rot=0 MovF=0

127
cPos=(12,20)
cJ=14, JCon=15, lJDir=3, nJs=11, nJl=13
cDir=3, nDir=3
travelledDist=1
0: 0. 3: 3. 2: 2. 
/////////////////////////////          -3-----------2--
/////////////#///####/###////          3-4-------------
////////////#:###::::#:::#///          -4-3------------
////////////#X::####:###X:#//          --3-3-----------
////////////#:#::X::X:##:#///          ---3-5----------
////////////#:###:###X::X#///          ----5-3---7-----
////////////#X::#:###:##:#///          -----3-2--------
////////////#:#:#::::X####///          ------2-3-2-----
////////////#:#:#####::X::#//          -------3-2------
////////////#X::#////##:#:#//          --------2-------
////////////#:##////###:#:#//          -----7-2---3----
////////////#:#////.X:::#:#//          ----------3-13-6-
////////////#:##///#O####:#//          -----------13-3--
////////////#X::#.##.####:#//          2-----------3---
////////////#:#X:X::X:::::#//          -----------6----
/////////////##:##########///          ----------------
Normal mode start
Down=1, Left=0, Right=0, Up=1
Visited=1, junction=0
Entered new square
Normal mode end
Op mode: 0 Rot=0 MovF=1
Op mode: 0 Rot=0 MovF=1
Moving forward mode starts
travelledDist=2
curPos=(13,20) 
 Moving forward mode ends
Op mode: 0 Rot=0 MovF=0
Op mode: 0 Rot=0 MovF=0
Op mode: 0 Rot=0 MovF=0

128
cPos=(13,20)
cJ=14, JCon=15, lJDir=3, nJs=11, nJl=13
cDir=3, nDir=3
travelledDist=2
0: 0. 3: 3. 2: 2. 
/////////////////////////////          -3-----------2--
/////////////#///####/###////          3-4-------------
////////////#:###::::#:::#///          -4-3------------
////////////#X::####:###X:#//          --3-3-----------
////////////#:#::X::X:##:#///          ---3-5----------
////////////#:###:###X::X#///          ----5-3---7-----
////////////#X::#:###:##:#///          -----3-2--------
////////////#:#:#::::X####///          ------2-3-2-----
////////////#:#:#####::X::#//          -------3-2------
////////////#X::#////##:#:#//          --------2-------
////////////#:##////###:#:#//          -----7-2---3----
////////////#:#////.X:::#:#//          ----------3-13-6-
////////////#:##///#:####:#//          -----------13-3--
////////////#X::#.##O####:#//          2-----------3---
////////////#:#X:X::X:::::#//          -----------6----
/////////////##:##########///          ----------------
Normal mode start
Down=1, Left=0, Right=0, Up=0
Visited=1, junction=0
Entered new square
Normal mode end
Op mode: 0 Rot=0 MovF=1
Op mode: 0 Rot=0 MovF=1
Moving forward mode starts
travelledDist=3
curPos=(14,20) 
 Moving forward mode ends
Op mode: 0 Rot=0 MovF=0
Op mode: 0 Rot=0 MovF=0
Op mode: 0 Rot=0 MovF=0

129
cPos=(14,20)
cJ=14, JCon=15, lJDir=3, nJs=11, nJl=13
cDir=3, nDir=3
travelledDist=3
0: 0. 3: 3. 2: 2. 
/////////////////////////////          -3-----------2--
/////////////#///####/###////          3-4-------------
////////////#:###::::#:::#///          -4-3------------
////////////#X::####:###X:#//          --3-3-----------
////////////#:#::X::X:##:#///          ---3-5----------
////////////#:###:###X::X#///          ----5-3---7-----
////////////#X::#:###:##:#///          -----3-2--------
////////////#:#:#::::X####///          ------2-3-2-----
////////////#:#:#####::X::#//          -------3-2------
////////////#X::#////##:#:#//          --------2-------
////////////#:##////###:#:#//          -----7-2---3----
////////////#:#////.X:::#:#//          ----------3-13-6-
////////////#:##///#:####:#//          -----------13-3--
////////////#X::#.##:####:#//          2-----------3---
////////////#:#X:X::O:::::#//          -----------6----
/////////////##:##########///          ----------------
Normal mode start
Down=0, Left=0, Right=0, Up=0
Visited=1, junction=1
Entered visited junction
Array=0, j1=14, j2=12
1337
j1=12, j2=14, direction=1,Added up
j1=14, j2=12, direction=3,Added down
J#=14, right=11, up=0, left=0, down=12
J#=12, right=11, up=14, left=13, down=0
Sent dir=1
Tester=0, UnexSq=0, 0=01, 1=01, 2=01, 3=01
Fully explored junction
WTF CurJunction = 12
 15
Decided nJl=14
Op mode: 2 Rot=0 MovF=0
Op mode: 2 Rot=0 MovF=0
Op mode: 2 Rot=0 MovF=0
Far junction mode starts
Destination decided, nJl=14
Åk mot nJs
nDir=1, cJ=12, nJs=13
nDir=2, cJ=12, nJs=13
Far junction mode ends
Op mode: 3 Rot=1 MovF=1

130
cPos=(14,20)
cJ=12, JCon=15, lJDir=3, nJs=13, nJl=14
cDir=3, nDir=2
travelledDist=0
0: 0. 3: 3. 2: 2. 
/////////////////////////////          -3-----------2--
/////////////#///####/###////          3-4-------------
////////////#:###::::#:::#///          -4-3------------
////////////#X::####:###X:#//          --3-3-----------
////////////#:#::X::X:##:#///          ---3-5----------
////////////#:###:###X::X#///          ----5-3---7-----
////////////#X::#:###:##:#///          -----3-2--------
////////////#:#:#::::X####///          ------2-3-2-----
////////////#:#:#####::X::#//          -------3-2------
////////////#X::#////##:#:#//          --------2-------
////////////#:##////###:#:#//          -----7-2---3----
////////////#:#////.X:::#:#//          ----------3-13-6-
////////////#:##///#:####:#//          -----------13-33-
////////////#X::#.##:####:#//          2-----------3---
////////////#:#X:X::O:::::#//          -----------63---
/////////////##:##########///          ----------------
Op mode: 3 Rot=1 MovF=1
Rotating mode starts
curDir=2 
 Rotating mode ends
Op mode: 3 Rot=0 MovF=1
Moving forward mode starts
travelledDist=1
curPos=(14,19) 
 Moving forward mode ends
Op mode: 3 Rot=0 MovF=0
Go to junction mode starts
Up=0
Down=0
Go to junction mode ends
Op mode: 3 Rot=0 MovF=1
Op mode: 3 Rot=0 MovF=1

131
cPos=(14,19)
cJ=12, JCon=15, lJDir=2, nJs=13, nJl=14
cDir=2, nDir=2
travelledDist=1
3: 3. 2: 2. 1: 1. 
/////////////////////////////          -3-----------2--
/////////////#///####/###////          3-4-------------
////////////#:###::::#:::#///          -4-3------------
////////////#X::####:###X:#//          --3-3-----------
////////////#:#::X::X:##:#///          ---3-5----------
////////////#:###:###X::X#///          ----5-3---7-----
////////////#X::#:###:##:#///          -----3-2--------
////////////#:#:#::::X####///          ------2-3-2-----
////////////#:#:#####::X::#//          -------3-2------
////////////#X::#////##:#:#//          --------2-------
////////////#:##////###:#:#//          -----7-2---3----
////////////#:#////.X:::#:#//          ----------3-13-6-
////////////#:##///#:####:#//          -----------13-33-
////////////#X::#.##:####:#//          2-----------3---
////////////#:#X:X:OX:::::#//          -----------63---
/////////////##:##########///          ----------------
Op mode: 3 Rot=0 MovF=1
Op mode: 3 Rot=0 MovF=1
Moving forward mode starts
travelledDist=2
curPos=(14,18) 
 Moving forward mode ends
Op mode: 3 Rot=0 MovF=0
Go to junction mode starts
Up=0
Down=0
Go to junction mode ends
Op mode: 3 Rot=0 MovF=1
Op mode: 3 Rot=0 MovF=1

132
cPos=(14,18)
cJ=12, JCon=15, lJDir=2, nJs=13, nJl=14
cDir=2, nDir=2
travelledDist=2
3: 3. 2: 2. 1: 1. 
/////////////////////////////          -3-----------2--
/////////////#///####/###////          3-4-------------
////////////#:###::::#:::#///          -4-3------------
////////////#X::####:###X:#//          --3-3-----------
////////////#:#::X::X:##:#///          ---3-5----------
////////////#:###:###X::X#///          ----5-3---7-----
////////////#X::#:###:##:#///          -----3-2--------
////////////#:#:#::::X####///          ------2-3-2-----
////////////#:#:#####::X::#//          -------3-2------
////////////#X::#////##:#:#//          --------2-------
////////////#:##////###:#:#//          -----7-2---3----
////////////#:#////.X:::#:#//          ----------3-13-6-
////////////#:##///#:####:#//          -----------13-33-
////////////#X::#.##:####:#//          2-----------3---
////////////#:#X:XO:X:::::#//          -----------63---
/////////////##:##########///          ----------------
Op mode: 3 Rot=0 MovF=1
Op mode: 3 Rot=0 MovF=1
Moving forward mode starts
travelledDist=3
curPos=(14,17) 
 Moving forward mode ends
Op mode: 3 Rot=0 MovF=0
Go to junction mode starts
Up=1
ROT=-1
curJ=nJs!!
Down=0, Left=0, Right=0, Up=1
Tester=1, UnexSq=1, 0=01, 1=01, 2=01, 3=01
UnexSq exist!!
Go to junction mode ends
Op mode: 0 Rot=0 MovF=0
Op mode: 0 Rot=0 MovF=0

133
cPos=(14,17)
cJ=13, JCon=15, lJDir=2, nJs=13, nJl=14
cDir=2, nDir=1
travelledDist=0
3: 3. 2: 2. 1: 1. 
/////////////////////////////          -3-----------2--
/////////////#///####/###////          3-4-------------
////////////#:###::::#:::#///          -4-3------------
////////////#X::####:###X:#//          --3-3-----------
////////////#:#::X::X:##:#///          ---3-5----------
////////////#:###:###X::X#///          ----5-3---7-----
////////////#X::#:###:##:#///          -----3-2--------
////////////#:#:#::::X####///          ------2-3-2-----
////////////#:#:#####::X::#//          -------3-2------
////////////#X::#////##:#:#//          --------2-------
////////////#:##////###:#:#//          -----7-2---3----
////////////#:#////.X:::#:#//          ----------3-13-6-
////////////#:##///#:####:#//          -----------13-33-
////////////#X::#.##:####:#//          2-----------3---
////////////#:#X:O::X:::::#//          -----------63---
/////////////##:##########///          ----------------
Normal mode start
Down=0, Left=0, Right=0, Up=1
Visited=1, junction=1
Entered visited junction
Array=0, j1=13, j2=13
Array=0, j1=13, j2=13
J#=13, right=12, up=0, left=0, down=0
J#=13, right=12, up=0, left=0, down=0
Sent dir=0
Tester=1, UnexSq=1, 0=01, 1=01, 2=01, 3=01
Has UnexSQ=1
Normal mode end
Op mode: 0 Rot=1 MovF=1
Rotating mode starts
curDir=1 
 Rotating mode ends
Op mode: 0 Rot=0 MovF=1
Moving forward mode starts
travelledDist=1
curPos=(13,17) 
 Moving forward mode ends
Op mode: 0 Rot=0 MovF=0
Op mode: 0 Rot=0 MovF=0
Op mode: 0 Rot=0 MovF=0

134
cPos=(13,17)
cJ=13, JCon=15, lJDir=1, nJs=13, nJl=14
cDir=1, nDir=1
travelledDist=1
2: 2. 1: 1. 0: 0. 
/////////////////////////////          -3-----------2--
/////////////#///####/###////          3-4-------------
////////////#:###::::#:::#///          -4-3------------
////////////#X::####:###X:#//          --3-3-----------
////////////#:#::X::X:##:#///          ---3-5----------
////////////#:###:###X::X#///          ----5-3---7-----
////////////#X::#:###:##:#///          -----3-2--------
////////////#:#:#::::X####///          ------2-3-2-----
////////////#:#:#####::X::#//          -------3-2------
////////////#X::#////##:#:#//          --------2-------
////////////#:##////###:#:#//          -----7-2---3----
////////////#:#////.X:::#:#//          ----------3-13-6-
////////////#:##/./#:####:#//          -----------13-33-
////////////#X::#O##:####:#//          2-----------3---
////////////#:#X:X::X:::::#//          -----------63---
/////////////##:##########///          ----------------
Normal mode start
Down=1, Left=0, Right=0, Up=1
Visited=1, junction=0
Entered new square
Normal mode end
Op mode: 0 Rot=0 MovF=1
Op mode: 0 Rot=0 MovF=1
Moving forward mode starts
travelledDist=2
curPos=(12,17) 
 Moving forward mode ends
Op mode: 0 Rot=0 MovF=0
Op mode: 0 Rot=0 MovF=0
Op mode: 0 Rot=0 MovF=0

135
cPos=(12,17)
cJ=13, JCon=15, lJDir=1, nJs=13, nJl=14
cDir=1, nDir=1
travelledDist=2
2: 2. 1: 1. 0: 0. 
/////////////////////////////          -3-----------2--
/////////////#///####/###////          3-4-------------
////////////#:###::::#:::#///          -4-3------------
////////////#X::####:###X:#//          --3-3-----------
////////////#:#::X::X:##:#///          ---3-5----------
////////////#:###:###X::X#///          ----5-3---7-----
////////////#X::#:###:##:#///          -----3-2--------
////////////#:#:#::::X####///          ------2-3-2-----
////////////#:#:#####::X::#//          -------3-2------
////////////#X::#////##:#:#//          --------2-------
////////////#:##////###:#:#//          -----7-2---3----
////////////#:#//./.X:::#:#//          ----------3-13-6-
////////////#:###O##:####:#//          -----------13-33-
////////////#X::#:##:####:#//          2-----------3---
////////////#:#X:X::X:::::#//          -----------63---
/////////////##:##########///          ----------------
Normal mode start
Down=0, Left=0, Right=0, Up=1
Visited=1, junction=0
Entered new square
Normal mode end
Op mode: 0 Rot=0 MovF=1
Op mode: 0 Rot=0 MovF=1
Moving forward mode starts
travelledDist=3
curPos=(11,17) 
 Moving forward mode ends
Op mode: 0 Rot=0 MovF=0
Op mode: 0 Rot=0 MovF=0
Op mode: 0 Rot=0 MovF=0

136
cPos=(11,17)
cJ=13, JCon=15, lJDir=1, nJs=13, nJl=14
cDir=1, nDir=1
travelledDist=3
2: 2. 1: 1. 0: 0. 
/////////////////////////////          -3-----------2--
/////////////#///####/###////          3-4-------------
////////////#:###::::#:::#///          -4-3------------
////////////#X::####:###X:#//          --3-3-----------
////////////#:#::X::X:##:#///          ---3-5----------
////////////#:###:###X::X#///          ----5-3---7-----
////////////#X::#:###:##:#///          -----3-2--------
////////////#:#:#::::X####///          ------2-3-2-----
////////////#:#:#####::X::#//          -------3-2------
////////////#X::#////##:#:#//          --------2-------
////////////#:##/#//###:#:#//          -----7-2---3----
////////////#:#/#O..X:::#:#//          ----------3-13-6-
////////////#:###:##:####:#//          -----------13-33-
////////////#X::#:##:####:#//          2-----------3---
////////////#:#X:X::X:::::#//          -----------63---
/////////////##:##########///          ----------------
Normal mode start
Down=0, Left=0, Right=1, Up=0
Visited=1, junction=0
Entered new square
Normal mode end
Op mode: 0 Rot=1 MovF=1
Rotating mode starts
curDir=0 
 Rotating mode ends
Op mode: 0 Rot=0 MovF=1
Moving forward mode starts
travelledDist=4
curPos=(11,18) 
 Moving forward mode ends
Op mode: 0 Rot=0 MovF=0
Op mode: 0 Rot=0 MovF=0
Op mode: 0 Rot=0 MovF=0

137
cPos=(11,18)
cJ=13, JCon=15, lJDir=1, nJs=13, nJl=14
cDir=0, nDir=0
travelledDist=4
1: 1. 0: 0. 3: 3. 
/////////////////////////////          -3-----------2--
/////////////#///####/###////          3-4-------------
////////////#:###::::#:::#///          -4-3------------
////////////#X::####:###X:#//          --3-3-----------
////////////#:#::X::X:##:#///          ---3-5----------
////////////#:###:###X::X#///          ----5-3---7-----
////////////#X::#:###:##:#///          -----3-2--------
////////////#:#:#::::X####///          ------2-3-2-----
////////////#:#:#####::X::#//          -------3-2------
////////////#X::#////##:#:#//          --------2-------
////////////#:##/##/###:#:#//          -----7-2---3----
////////////#:#/#:O.X:::#:#//          ----------3-13-6-
////////////#:###:##:####:#//          -----------13-33-
////////////#X::#:##:####:#//          2-----------3---
////////////#:#X:X::X:::::#//          -----------63---
/////////////##:##########///          ----------------
Normal mode start
Down=0, Left=0, Right=1, Up=0
Visited=1, junction=0
Entered new square
Normal mode end
Op mode: 0 Rot=0 MovF=1
Op mode: 0 Rot=0 MovF=1
Moving forward mode starts
travelledDist=5
curPos=(11,19) 
 Moving forward mode ends
Op mode: 0 Rot=0 MovF=0
Op mode: 0 Rot=0 MovF=0
Op mode: 0 Rot=0 MovF=0

138
cPos=(11,19)
cJ=13, JCon=15, lJDir=1, nJs=13, nJl=14
cDir=0, nDir=0
travelledDist=5
1: 1. 0: 0. 3: 3. 
/////////////////////////////          -3-----------2--
/////////////#///####/###////          3-4-------------
////////////#:###::::#:::#///          -4-3------------
////////////#X::####:###X:#//          --3-3-----------
////////////#:#::X::X:##:#///          ---3-5----------
////////////#:###:###X::X#///          ----5-3---7-----
////////////#X::#:###:##:#///          -----3-2--------
////////////#:#:#::::X####///          ------2-3-2-----
////////////#:#:#####::X::#//          -------3-2------
////////////#X::#////##:#:#//          --------2-------
////////////#:##/##.###:#:#//          -----7-2---3----
////////////#:#/#::OX:::#:#//          ----------3-13-6-
////////////#:###:##:####:#//          -----------13-33-
////////////#X::#:##:####:#//          2-----------3---
////////////#:#X:X::X:::::#//          -----------63---
/////////////##:##########///          ----------------
Normal mode start
Down=0, Left=0, Right=1, Up=1
Visited=1, junction=0
Entered new square
Has unex roads, UnexSQ=2
Array=0, j1=13, j2=15
1337
j1=13, j2=15, direction=1,Added up
j1=15, j2=13, direction=2,Added left
J#=13, right=12, up=15, left=0, down=0
J#=15, right=0, up=0, left=13, down=0
Normal mode end
Op mode: 0 Rot=1 MovF=1
Rotating mode starts
curDir=1 
 Rotating mode ends
Op mode: 0 Rot=0 MovF=1
Moving forward mode starts
travelledDist=1
curPos=(10,19) 
 Moving forward mode ends
Op mode: 0 Rot=0 MovF=0
Op mode: 0 Rot=0 MovF=0
Op mode: 0 Rot=0 MovF=0

139
cPos=(10,19)
cJ=15, JCon=16, lJDir=1, nJs=13, nJl=14
cDir=1, nDir=1
travelledDist=1
2: 2. 1: 1. 0: 0. 
/////////////////////////////          -3-----------2--
/////////////#///####/###////          3-4-------------
////////////#:###::::#:::#///          -4-3------------
////////////#X::####:###X:#//          --3-3-----------
////////////#:#::X::X:##:#///          ---3-5----------
////////////#:###:###X::X#///          ----5-3---7-----
////////////#X::#:###:##:#///          -----3-2--------
////////////#:#:#::::X####///          ------2-3-2-----
////////////#:#:#####::X::#//          -------3-2------
////////////#X::#//./##:#:#//          --------2-------
////////////#:##/##O###:#:#//          -----7-2---3----
////////////#:#/#::XX:::#:#//          ----------3-13-6-
////////////#:###:##:####:#//          -----------13-33-
////////////#X::#:##:####:#//          2-----------3--5
////////////#:#X:X::X:::::#//          -----------63---
/////////////##:##########///          -------------5--
Normal mode start
Down=1, Left=0, Right=0, Up=1
Visited=1, junction=0
Entered new square
Normal mode end
Op mode: 0 Rot=0 MovF=1
Op mode: 0 Rot=0 MovF=1
Moving forward mode starts
travelledDist=2
curPos=(9,19) 
 Moving forward mode ends
Op mode: 0 Rot=0 MovF=0
Op mode: 0 Rot=0 MovF=0
Op mode: 0 Rot=0 MovF=0

140
cPos=(9,19)
cJ=15, JCon=16, lJDir=1, nJs=13, nJl=14
cDir=1, nDir=1
travelledDist=2
2: 2. 1: 1. 0: 0. 
/////////////////////////////          -3-----------2--
/////////////#///####/###////          3-4-------------
////////////#:###::::#:::#///          -4-3------------
////////////#X::####:###X:#//          --3-3-----------
////////////#:#::X::X:##:#///          ---3-5----------
////////////#:###:###X::X#///          ----5-3---7-----
////////////#X::#:###:##:#///          -----3-2--------
////////////#:#:#::::X####///          ------2-3-2-----
////////////#:#:#####::X::#//          -------3-2------
////////////#X::#/.O###:#:#//          --------2-------
////////////#:##/##:###:#:#//          -----7-2---3----
////////////#:#/#::XX:::#:#//          ----------3-13-6-
////////////#:###:##:####:#//          -----------13-33-
////////////#X::#:##:####:#//          2-----------3--5
////////////#:#X:X::X:::::#//          -----------63---
/////////////##:##########///          -------------5--
Normal mode start
Down=0, Left=1, Right=0, Up=0
Visited=1, junction=0
Entered new square
Normal mode end
Op mode: 0 Rot=1 MovF=1
Rotating mode starts
curDir=2 
 Rotating mode ends
Op mode: 0 Rot=0 MovF=1
Moving forward mode starts
travelledDist=3
curPos=(9,18) 
 Moving forward mode ends
Op mode: 0 Rot=0 MovF=0
Op mode: 0 Rot=0 MovF=0
Op mode: 0 Rot=0 MovF=0

141
cPos=(9,18)
cJ=15, JCon=16, lJDir=1, nJs=13, nJl=14
cDir=2, nDir=2
travelledDist=3
3: 3. 2: 2. 1: 1. 
/////////////////////////////          -3-----------2--
/////////////#///####/###////          3-4-------------
////////////#:###::::#:::#///          -4-3------------
////////////#X::####:###X:#//          --3-3-----------
////////////#:#::X::X:##:#///          ---3-5----------
////////////#:###:###X::X#///          ----5-3---7-----
////////////#X::#:###:##:#///          -----3-2--------
////////////#:#:#::::X####///          ------2-3-2-----
////////////#:#:#####::X::#//          -------3-2------
////////////#X::#.O:###:#:#//          --------2-------
////////////#:##/##:###:#:#//          -----7-2---3----
////////////#:#/#::XX:::#:#//          ----------3-13-6-
////////////#:###:##:####:#//          -----------13-33-
////////////#X::#:##:####:#//          2-----------3--5
////////////#:#X:X::X:::::#//          -----------63---
/////////////##:##########///          -------------5--
Normal mode start
Down=0, Left=1, Right=0, Up=0
Visited=1, junction=0
Entered new square
Normal mode end
Op mode: 0 Rot=0 MovF=1
Op mode: 0 Rot=0 MovF=1
Moving forward mode starts
travelledDist=4
curPos=(9,17) 
 Moving forward mode ends
Op mode: 0 Rot=0 MovF=0
Op mode: 0 Rot=0 MovF=0
Op mode: 0 Rot=0 MovF=0

142
cPos=(9,17)
cJ=15, JCon=16, lJDir=1, nJs=13, nJl=14
cDir=2, nDir=2
travelledDist=4
3: 3. 2: 2. 1: 1. 
/////////////////////////////          -3-----------2--
/////////////#///####/###////          3-4-------------
////////////#:###::::#:::#///          -4-3------------
////////////#X::####:###X:#//          --3-3-----------
////////////#:#::X::X:##:#///          ---3-5----------
////////////#:###:###X::X#///          ----5-3---7-----
////////////#X::#:###:##:#///          -----3-2--------
////////////#:#:#::::X####///          ------2-3-2-----
////////////#:#:#####::X::#//          -------3-2------
////////////#X::#O::###:#:#//          --------2-------
////////////#:##/##:###:#:#//          -----7-2---3----
////////////#:#/#::XX:::#:#//          ----------3-13-6-
////////////#:###:##:####:#//          -----------13-33-
////////////#X::#:##:####:#//          2-----------3--5
////////////#:#X:X::X:::::#//          -----------63---
/////////////##:##########///          -------------5--
Normal mode start
Down=0, Left=0, Right=0, Up=0
Visited=1, junction=0
Entered new square
Dead end, UnexSq=0
Rotating mode starts
curDir=0 
 Rotating mode ends
Op mode: 3 Rot=0 MovF=1
Moving forward mode starts
travelledDist=5
curPos=(9,18) 
 Moving forward mode ends
Op mode: 3 Rot=0 MovF=0
Go to junction mode starts
Down=0
Up=0
Go to junction mode ends
Op mode: 3 Rot=0 MovF=1
Op mode: 3 Rot=0 MovF=1

143
cPos=(9,18)
cJ=15, JCon=16, lJDir=1, nJs=15, nJl=14
cDir=0, nDir=0
travelledDist=5
1: 1. 0: 0. 3: 3. 
/////////////////////////////          -3-----------2--
/////////////#///####/###////          3-4-------------
////////////#:###::::#:::#///          -4-3------------
////////////#X::####:###X:#//          --3-3-----------
////////////#:#::X::X:##:#///          ---3-5----------
////////////#:###:###X::X#///          ----5-3---7-----
////////////#X::#:###:##:#///          -----3-2--------
////////////#:#:#::::X####///          ------2-3-2-----
////////////#:#:#####::X::#//          -------3-2------
////////////#X::#:O:###:#:#//          --------2-------
////////////#:##/##:###:#:#//          -----7-2---3----
////////////#:#/#::XX:::#:#//          ----------3-13-6-
////////////#:###:##:####:#//          -----------13-33-
////////////#X::#:##:####:#//          2-----------3--5
////////////#:#X:X::X:::::#//          -----------63---
/////////////##:##########///          -------------5--
Op mode: 3 Rot=0 MovF=1
Op mode: 3 Rot=0 MovF=1
Moving forward mode starts
travelledDist=6
curPos=(9,19) 
 Moving forward mode ends
Op mode: 3 Rot=0 MovF=0
Go to junction mode starts
Down=1
ROT=-1
Go to junction mode ends
Op mode: 3 Rot=1 MovF=1
Op mode: 3 Rot=1 MovF=1

144
cPos=(9,19)
cJ=15, JCon=16, lJDir=1, nJs=15, nJl=14
cDir=0, nDir=3
travelledDist=6
1: 1. 0: 0. 3: 3. 
/////////////////////////////          -3-----------2--
/////////////#///####/###////          3-4-------------
////////////#:###::::#:::#///          -4-3------------
////////////#X::####:###X:#//          --3-3-----------
////////////#:#::X::X:##:#///          ---3-5----------
////////////#:###:###X::X#///          ----5-3---7-----
////////////#X::#:###:##:#///          -----3-2--------
////////////#:#:#::::X####///          ------2-3-2-----
////////////#:#:#####::X::#//          -------3-2------
////////////#X::#::O###:#:#//          --------2-------
////////////#:##/##:###:#:#//          -----7-2---3----
////////////#:#/#::XX:::#:#//          ----------3-13-6-
////////////#:###:##:####:#//          -----------13-33-
////////////#X::#:##:####:#//          2-----------3--5
////////////#:#X:X::X:::::#//          -----------63---
/////////////##:##########///          -------------5--
Op mode: 3 Rot=1 MovF=1
Rotating mode starts
curDir=3 
 Rotating mode ends
Op mode: 3 Rot=0 MovF=1
Moving forward mode starts
travelledDist=7
curPos=(10,19) 
 Moving forward mode ends
Op mode: 3 Rot=0 MovF=0
Go to junction mode starts
Left=0
Right=0
Go to junction mode ends
Op mode: 3 Rot=0 MovF=1
Op mode: 3 Rot=0 MovF=1

145
cPos=(10,19)
cJ=15, JCon=16, lJDir=1, nJs=15, nJl=14
cDir=3, nDir=3
travelledDist=7
0: 0. 3: 3. 2: 2. 
/////////////////////////////          -3-----------2--
/////////////#///####/###////          3-4-------------
////////////#:###::::#:::#///          -4-3------------
////////////#X::####:###X:#//          --3-3-----------
////////////#:#::X::X:##:#///          ---3-5----------
////////////#:###:###X::X#///          ----5-3---7-----
////////////#X::#:###:##:#///          -----3-2--------
////////////#:#:#::::X####///          ------2-3-2-----
////////////#:#:#####::X::#//          -------3-2------
////////////#X::#:::###:#:#//          --------2-------
////////////#:##/##O###:#:#//          -----7-2---3----
////////////#:#/#::XX:::#:#//          ----------3-13-6-
////////////#:###:##:####:#//          -----------13-33-
////////////#X::#:##:####:#//          2-----------3--5
////////////#:#X:X::X:::::#//          -----------63---
/////////////##:##########///          -------------5--
Op mode: 3 Rot=0 MovF=1
Op mode: 3 Rot=0 MovF=1
Moving forward mode starts
travelledDist=8
curPos=(11,19) 
 Moving forward mode ends
Op mode: 3 Rot=0 MovF=0
Go to junction mode starts
Left=1
ROT=-1
curJ=nJs!!
Down=0, Left=0, Right=1, Up=0
Tester=1, UnexSq=1, 0=10, 1=01, 2=01, 3=01
UnexSq exist!!
Go to junction mode ends
Op mode: 0 Rot=0 MovF=0
Op mode: 0 Rot=0 MovF=0

146
cPos=(11,19)
cJ=15, JCon=16, lJDir=1, nJs=15, nJl=14
cDir=3, nDir=0
travelledDist=0
0: 0. 3: 3. 2: 2. 
/////////////////////////////          -3-----------2--
/////////////#///####/###////          3-4-------------
////////////#:###::::#:::#///          -4-3------------
////////////#X::####:###X:#//          --3-3-----------
////////////#:#::X::X:##:#///          ---3-5----------
////////////#:###:###X::X#///          ----5-3---7-----
////////////#X::#:###:##:#///          -----3-2--------
////////////#:#:#::::X####///          ------2-3-2-----
////////////#:#:#####::X::#//          -------3-2------
////////////#X::#:::###:#:#//          --------2-------
////////////#:##/##:###:#:#//          -----7-2---3----
////////////#:#/#::OX:::#:#//          ----------3-13-6-
////////////#:###:##:####:#//          -----------13-33-
////////////#X::#:##:####:#//          2-----------3--5
////////////#:#X:X::X:::::#//          -----------63---
/////////////##:##########///          -------------5--
Normal mode start
Down=0, Left=0, Right=1, Up=0
Visited=1, junction=1
Entered visited junction
Array=0, j1=15, j2=15
Array=0, j1=15, j2=15
J#=15, right=0, up=0, left=13, down=0
J#=15, right=0, up=0, left=13, down=0
Sent dir=1
Tester=1, UnexSq=1, 0=10, 1=01, 2=01, 3=01
Has UnexSQ=1
Normal mode end
Op mode: 0 Rot=1 MovF=1
Rotating mode starts
curDir=0 
 Rotating mode ends
Op mode: 0 Rot=0 MovF=1
Moving forward mode starts
travelledDist=1
curPos=(11,20) 
 Moving forward mode ends
Op mode: 0 Rot=0 MovF=0
Op mode: 0 Rot=0 MovF=0
Op mode: 0 Rot=0 MovF=0

147
cPos=(11,20)
cJ=15, JCon=16, lJDir=0, nJs=15, nJl=14
cDir=0, nDir=0
travelledDist=1
1: 1. 0: 0. 3: 3. 
/////////////////////////////          -3-----------2--
/////////////#///####/###////          3-4-------------
////////////#:###::::#:::#///          -4-3------------
////////////#X::####:###X:#//          --3-3-----------
////////////#:#::X::X:##:#///          ---3-5----------
////////////#:###:###X::X#///          ----5-3---7-----
////////////#X::#:###:##:#///          -----3-2--------
////////////#:#:#::::X####///          ------2-3-2-----
////////////#:#:#####::X::#//          -------3-2------
////////////#X::#:::###:#:#//          --------2-------
////////////#:##/##:###:#:#//          -----7-2---3----
////////////#:#/#::XO:::#:#//          ----------3-13-6-
////////////#:###:##:####:#//          -----------13-33-
////////////#X::#:##:####:#//          2-----------3--5
////////////#:#X:X::X:::::#//          -----------63---
/////////////##:##########///          -------------5--
Normal mode start
Down=0, Left=1, Right=0, Up=0
Visited=1, junction=1
Entered visited junction
Array=0, j1=15, j2=14
1337
j1=14, j2=15, direction=2,Added left
j1=15, j2=14, direction=0,Added right
J#=15, right=14, up=0, left=13, down=0
J#=14, right=11, up=0, left=15, down=12
Sent dir=2
Tester=0, UnexSq=1, 0=01, 1=01, 2=11, 3=01
Fully explored junction
WTF CurJunction = 14
 16 15 14 13 12 11 10 9 8 7 6 5 4 3 2 1 0
Decided nJl=14
Op mode: 2 Rot=0 MovF=0
Op mode: 2 Rot=0 MovF=0
Op mode: 2 Rot=0 MovF=0
Far junction mode starts
Destination decided, nJl=14
nJl == curPos!!
Far junction mode ends
Op mode: 0 Rot=0 MovF=0

-3-----------2--
3-4-------------
-4-3------------
--3-3-----------
---3-5----------
----5-3---7-----
-----3-2--------
------2-3-2-----
-------3-2------
--------2-------
-----7-2---3----
----------3-13-6-
-----------13-33-
2-----------3--5
-----------63--1
-------------51-
(0,1) = 3 (0,13) = 2 
(1,0) = 3 (1,2) = 4 
(2,1) = 4 (2,3) = 3 
(3,2) = 3 (3,4) = 3 
(4,3) = 3 (4,5) = 5 
(5,4) = 5 (5,6) = 3 (5,10) = 7 
(6,5) = 3 (6,7) = 2 
(7,6) = 2 (7,8) = 3 (7,10) = 2 
(8,7) = 3 (8,9) = 2 
(9,8) = 2 
(10,5) = 7 (10,7) = 2 (10,11) = 3 
(11,10) = 3 (11,12) = 13 (11,14) = 6 
(12,11) = 13 (12,13) = 3 (12,14) = 3 
(13,0) = 2 (13,12) = 3 (13,15) = 5 
(14,11) = 6 (14,12) = 3 (14,15) = 1 
(15,13) = 5 (15,14) = 1 
SLUT
