adnanberberovic/TSEA56Grupp2/(commit log)

2015-02-15 Begränsningar: passager minst 40 cm breda
2015-02-15 Utvecklingsmetodik../// c eller c++, assembler?
2015-02-15 La till sensormodul i aktiviteter
2015-02-16 mallar etc
    [05Tidplan01.xls]
2015-02-16 tidplan v0.1
    [tidplan01.xlsx]
2015-02-17 Fixat tidplan och projektplan, v0.2
    [tidplan_v0.2.xlsx]
2015-02-17 Småfix på tidigare
    [tidplan_v0.2.xlsx]
2015-02-18 Slutgiltig v02, ej granskad
    [tidplan_v0.2.xlsx]
2015-02-18 korrigeringar i v0.2 av plan/systemskiss
    [tidplan_v0.2.xlsx]
2015-02-19 BP2 nästan färdig
    [tidplan_v0.3.xlsx]
2015-02-19 Alla ändringar gjorda
    [tidplan_v0.3.xlsx]
2015-02-19 lite ändringar
    [tidplan_v0.3.xlsx]
2015-02-22 Projekt- och tidplan v0.4
    Har gjort projekt- och tidplan v0.4 nästan klara.
    [tidplan_v0.4.xlsx]
2015-02-23 Ändrade projektplan och tidplan
    Ändrade aktiviteternas tider i tidplan för att stämma med
    projektplanen. Ändrade sensortest 2 i projektplanen - var felskriven.
    [tidplan_v0.4.xlsx]
2015-02-23 la till bp mappar
    [tidplan_v0.4.xlsx]
2015-02-24 bp2 v1.0
    [tidplan_v0.4.xlsx, tidplan_v1.0.xlsx]
2015-03-07 I2C och SPI
2015-03-07 spi komponent från vanheden
2015-03-10 tidplan 1.1.........
    [tidplan_v1.1.xlsx]
2015-03-11 tidplan 1.1
    [tidplan_v1.1.xlsx]
2015-03-26 Lade till sensormodul
    Atmel-filerna för sensormodul_test finns nu!
2015-03-27 Sensormodul
    Kod för hur roboten kan läsa av vinkel och vart den är i grottan
2015-03-27 fan va najs buss o lcd funkar heh
2015-03-27 Sensormodul
    Fixade ADMUX för alla sensorer.
    REFLEXSENSOR: MSB blir hög bara när vi är över svart underlag (om man
    håller den på rätt sätt - annars blir den 255!)
    [Sensormodul_test.c]
2015-03-30 kopplingsschema gyro styr
2015-03-30 start gyro
2015-04-01 Sensormodul test
    Nästan färdigt program för sensoravläsning och behandling!
    Att göra:
    Lägg till avbrottsvektor för att skicka
    Fixa reflexsensorvärdet
    Fixa front sensorn
    montera alla sensorer
    [Sensormodul_test.c]
2015-04-15 SPI fixifix
2015-04-15 Sensormodul nästan klar
    I princip färdig sensormodul. Endast busskommunikation saknas!
2015-04-15 SPI ändrad till kö, fixa cast från int till char
2015-04-16 styr och sensor
2015-04-16 SPI fixad, funktion för att skicka arrays fungera.
2015-04-16 Sensormodul-styrmodul-kommunikation
    Sensorvärden visas på styrmodulen. Delat upp sensor_data[3] till reflex,
    vägg_vänster och vägg_höger.
2015-04-17 fucking timer yesssss
2015-04-17 TIMER FUNKAR OMFG
2015-04-18 Speed calculator fix
    Nu borde koden till speedcalculator funka! Problem som kvarstår:
    Hur man gör PIND2 hög - fixas via hårdvara. Rita en svartvit cirkel med
    ett bra antal svartvita områden och sätt fast på hjulets utsida. Ta reda
    på hur reflexsensorn _som skall användas_ beter sig när den det pappret.
    Vilken spänning vid vitt och vilken vid svart. Spänningsdela med
    resistorer för att hitta den spänningen.
2015-04-21 buggar i motor fixd
2015-04-21 added filen bed gyro funktioner
2015-04-21 Gyro
    La till gyro. Verkar inte fungera men kompilerar bra! Tog bort så att
    gyro inte stänger av ss - man får göra det manuellt. Testa att ta bort
    så att det görs när man kör mastertransmit.
2015-04-22 Styrmodul
    Gyro fungerar typ. Delade upp i test-funktioner.
2015-04-23 Styrmodul_04
    oklart push igår laddade upp styrmodul ver04 med typ fungerande gyro och
    uppdelning i test
2015-04-23 GUI
    Coolt som fan
2015-04-23 LCD_displayint16 fix
    Displayint16-funktionen fungerade inte och kraschade när den anropades.
    Hastighetstest genomfördes
    [Styrmodul_0.4.c, Styrmodul_LCD.c]
2015-04-27 Styrmodul
    Hastighetsberäkningen flyttades till external interrupt INT0
2015-04-27 Test av SPI-styrmodul
2015-04-28 Utredd SPI-funktion
2015-04-28 Speed interrupt
    Försökte ändra klockans prescaler.
2015-04-28 Hastighetsmätare wtf
    Väldigt känslig sensor... Oklart hur lösa. OBS globala avbrott
    inaktiverade i INT0-vektorn
2015-04-29 Flyttat sensormodul till RÄTT plats
2015-04-29 Bluetooth och autonom/manual mode fix, fungerande byte via hårdvaruknapp
    [Autonomt.cpp, Autonomt.h, Manual.cpp, Manual.h]
2015-04-30 gyro kod optimering
2015-05-04 La till PC7 som utgång för schmitt-resistorn. Diverse regler och servo i mainloop, DWI
2015-05-05 reflex också. fan va bra den e nu
2015-05-08 Hastighet
    Hastighet fungerar! Stökig timer.
2015-05-12 fucking cpkuk sensor fjshjashfsaf
2015-05-12 Försökte fixa trevägskorsningar. BATTERISPÄNNINGEN PÅVERKAR VILKEN DELAY SOM FUNGERAR.
    [Styrmodul_V1.0.c]
2015-05-13 styrbeslut på väg att funka. har lagt till nya saker som skickas över buss, förhoppningsvis är manuell/autonom-biten korrekt konfigurerad fortfarande. Bytt till en lång sensor i fram
2015-05-14 small fixes and to do list
    [Path.h, path.c]
2015-05-14 Styrbeslut
    Försökte fixa styrbeslut. Kvar att göra:
    - Göra medelvärde av sensordata innan den skickas iväg
    - Fixa junctiondelay i fyrvägs
    - se måns awesome post its lol xd
    [Sensormodul_V1.0.c, Styrmodul_V1.0.c]
2015-05-18 styrbeslut fungerar bra. Reglering med en vägg fungerar bra. Fixa regleringen i c och r läge
    [Map.c, Map.h, Sensormodul_V1.0.c, Styrmodul_V1.0.c]
2015-05-22 hastigheten fungerar. Försöker fixa styrbeslut som är cp. weed blaze it 430
    [Styrmodul_V1.0.c]
2015-05-22 Map fix. Bör fungera
    [Styrmodul_V1.0.c]
2015-05-24 hej
    fan
2015-05-24 Småfixar med ingång i korsningar o.d., Problem med 3w2, den tappar koordinater. Även i vissa dead-ends.
    [Styrmodul_V1.0.c]
2015-05-24 skiten kanske fungerar nu fan, dvs map
2015-05-24 Lagt in sändning av sensordata
2015-05-24 den funkar fan i vissa kartor
2015-05-24 Kart-GUI implenterat. Alla 3way fixade. Reglering efter en vägg borttagen pga anledning. 430
    [Autonomt.cpp, Autonomt.h, State.cpp, Styrmodul_V1.0.c]
2015-05-25 kortaste väg simulerat och funkar bra men strul med korsningar när den implementeras. Stökigt pga hur man definierar en utforskad korsning. Utred hur man ska göra om man har t.ex. två korsningar bred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
2015-05-25 Helt OK bra kartläggning+´reglering. Problem med alla korsningar är utforskade.
    [Map.c, Styrmodul_V1.0.c]
2015-05-26 fixat korsningar. lite problem med slutkorsningen
    [Map.c, Styrmodul_V1.0.c]
2015-05-26 mål fixat. lite bättre reglering. bitches
    [Map.c, Sensormodul_V1.0.c, Styrmodul_V1.0.c]
2015-05-26 backupar. kvar: fixa så att den åker tillbaks rätt
    [Map.c, Styrmodul_V1.0.c]
2015-05-26 EN LITEN GREJ KVAR. HUR FAN ÅKER MAN TILLBAKS. KOLLA I MAP MAIN MAN1 HAHA LOL XD
2015-05-27 kukars. allt fucka ur. wheel counter hade blivit för dålig, gg. nu börjar det likna nåt! ska bara få den att åka rätt från mål till 0:an
2015-05-27 Roboten kan utforska hela kartan, hitta målet, åka till start, hitta tillbaks till målet men kan ej åka hem därifrån. Ger dock ut rätt väg som den vill åka men fel map_nextdir. ATT GÖRA: lös att åka 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
2015-05-27 Funkar att åka fram och tillbaka, alla gånger nu. Problem med att den inte lägger till alla korsningar verkar det som? även i stärre banor tog den inte rätt väg när den skulle tillbaka till mål fast 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
    [Styrmodul_V1.0.c]
2015-05-27 de blir fan bra såhär vi kör på denna kod
2015-05-29 Fixade rotate för små vinklar
    tog bort gammal oanvänd kod, såsjustering i PD
    [Styrmodul_V1.0.c]
